promaaa/firefighter-robot/vision/README.md

# Vision: the fire detector

This folder holds the fire detector of the robot: a YOLO11n network (Ultralytics) with one class, fire.
It finds flames in the 640 x 480 image of the Arducam B0201 camera and gives a box for each fire.
`detector.py` is the plug-in that `robot/camera_node.py` loads. It needs only onnxruntime, numpy and pillow.

**Licence:** this folder (code and model files) is AGPL-3.0 ([LICENSE](LICENSE)), because it uses Ultralytics YOLO. The code in the rest of the repository is MIT ([../LICENSE](../LICENSE)).

**Not verified:** From the B0201 camera, the modes, the frame rates, the lens calibration and the screen bench (fire images on a screen, 5 and 6 Nov) are measured. No real flame is measured yet (test V4). No number comes from the ROCK 3C board. All test images are public photos and video frames. The RKNN models ran only in the Rockchip simulator.
**Measured on laptop (5 Nov):** at 640 x 480, the B0201 has f = 476 px at the image centre and a real field of view of 80° x 59° (`camera_b0201.json`). The old model value was f = 283 px.

## Status

| Part | Status |
|---|---|
| Dataset from public sources, with a data card (`data.py`, [DATA.md](DATA.md)) | built |
| YOLO11n detector, trained at 416 px (`train.py`) | built |
| Accuracy on held-out test images, CPU speed (`evaluate.py`, `export.py`, `detector.py`) | measured on laptop |
| RKNN INT8 model for the RK3566 NPU (`rknn_convert.py`) | measured on laptop, in the Rockchip simulator |
| Detector in the F2 mission simulation with real-fire flames ([sim/mission](../sim/mission/README.md)) | tested in simulation |
| Speed test for the robot board (`board_bench.py`) | built |
| B0201 on the laptop: 640 x 480 MJPEG at 14.8 fps (15 fps set), 1920 x 1080 MJPEG at 30 fps (`robot/bench.py camera`, [modes](results/b0201_modes.txt)) | measured on laptop |
| Camera calibration with a live view (`calibrate.py`) | measured on laptop: f = 476 px, RMS 0.51 px at 640 x 480 (100 views); f = 1084 px, RMS 1.53 px at 1920 x 1080 (50 views) |
| Screen bench: the B0201 films fire images on a screen (`screen_bench.py`) | built, tested in simulation (ideal camera, `--fake`) |
| Range test: the B0201 films real candles at measured distances (`range_test.py`) | built, tested in simulation (a video file in place of the camera) |
| Small-flame variant `small416`: training images scaled by 0.1 to 1.9 (`train.py`, [metrics.md](results/small416/metrics.md)) | measured on laptop: no gain, not used. Ideal-camera screen bench: a candle needs 23 px (old model: 16 px) |
| Model changes `cam416` (camera-like training images), `p2_416` (YOLOv8n-P2), `y26_416` (YOLO26n), `p2cam416` (P2 + camera-like images), `p2bench` (p2cam416 + B0201 screen bench frames) in `train.py` ([plan](../docs/plan/vision.md#model-changes-after-v2-and-v4)) | measured on laptop (test images and B0201 screen bench frames, 5 and 6 Nov; `p2bench` INT8 in the Rockchip simulator), planned (real candles V4, board) |
| Detector on the board with the B0201, indoor fire test | planned |

The test stages with the B0201 and the ROCK 3C, their commands and pass criteria: [docs/plan/vision.md](../docs/plan/vision.md).

## Terms

- Box: the rectangle around a fire, in pixels of the 640 x 480 image. Confidence: a score from 0 to 1 for each box.
- Precision: the share of boxes that are real fires. Recall: the share of real fires that get a box.
- IoU: the overlap of two boxes, from 0 to 1. mAP50: the area under the precision-recall curve, with a match at IoU 0.5 or more.
- New scenes: test images that do not show the same scene as a training image ([DATA.md](DATA.md)). They are closer to a new room.
- NPU: the neural processing unit of the RK3566 chip. RKNN: its model format. INT8: the network computes with 8-bit integers.

## Results

The detector keeps the boxes with a confidence of 0.28 or more. This threshold gives the best balance of precision and recall on the validation images.
The full test uses the 416 x 416 export of the deployed weights. On a 640 x 480 image, it resizes the image by the same factor as the deployed file (0.65).
Sources: [metrics.md](results/all416/metrics.md) ([JSON](results/all416/metrics.json)), [speed.md](results/speed.md), [deploy_check.md](results/deploy_check.md), [video_check.md](results/video_check.md).

| Test | Result |
|---|---|
| Real test images, all (13 919 images, 8 455 fire boxes) | precision 0.781, recall 0.745, mAP50 0.809 |
| Real test images, new scenes only (5 733 images, 2 284 fire boxes) | precision 0.673, recall 0.723, mAP50 0.747 |
| Small fires (box under 32 px wide), all real test images | recall 0.472, mAP50 0.529 |
| False alarms: 330 COCO photos of fire-like things, no fire | a false box in 2.1 % of the images |
| False alarms: 4 738 new-scene images without fire | a false box in 7.4 % of the images |
| Box width for 50 % recall (IoU 0.25), distance d = f × flame width / box width, f = 476 px | 16 px: a 10 cm flame up to 3.0 m, a 30 cm flame up to 8.9 m |
| Box width for 90 % recall (IoU 0.25) | 64 px: a 10 cm flame up to 0.7 m, a 30 cm flame up to 2.2 m |
| Laptop CPU (i7-9700, onnxruntime), `detect()` on a 640 x 480 frame | 12.0 ms with 4 threads (83 frames per second), 26.7 ms with 1 thread |
| RKNN INT8 in the Rockchip simulator, 918 test images | mAP50 0.775 (ONNX on the same images: 0.816). Small-fire recall 0.500 (ONNX: 0.554) |
| 6 real videos (Wikimedia Commons, [timeline](results/video_timeline.png)) | frames with a box: candle 95 %, burning bottle 100 %, far campfire 58 %. LED candles (no fire): weak false boxes, up to 0.36 |
| F2 mission simulation, real-fire flame sprites | recall by box width as on real photos. 0.001 false boxes per image |

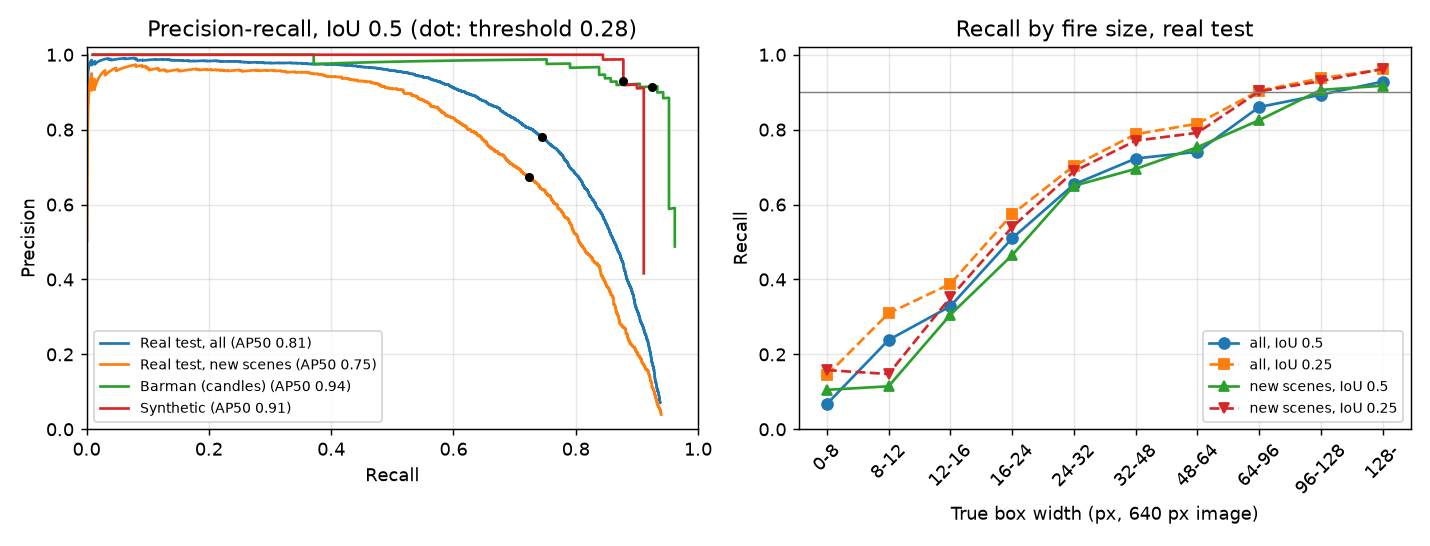
[picture p3: vision/results/all416/pr_and_size.png]
Precision-recall curves and recall by box width


Left: precision-recall curves at IoU 0.5. The dot is the threshold 0.28. Right: recall by true box width.

We trained YOLO11n from the COCO weights for 20 epochs at 416 px: AdamW, learning rate 0.001, batch 64, 62 719 images per epoch ([DATA.md](DATA.md), [training curves](results/training_curves.png)).
A control run without our 203 synthetic images (`real416`) gives the same mAP50 on real photos (0.811). On the synthetic test images, it falls from 0.911 to 0.164 ([variants.md](results/variants.md)).

## Models: which file runs where

| File | Runs on | How |
|---|---|---|
| `models/fire_yolo11n_416x320.onnx` (FP32, 10.5 MB) | laptop CPU or board CPU, with onnxruntime | the default of `detector.py` |
| `models/fire_yolo11n_416x320_int8.rknn` (INT8, 3.9 MB) | RK3566 NPU, with rknn-toolkit-lite2 | `FIRE_MODEL=vision/models/fire_yolo11n_416x320_int8.rknn` |

Both files take a 416 x 320 input: a 640 x 480 camera image becomes 416 x 312 with a 4 px grey border. `aim/` then uses only the boxes from its `min_conf` (0.3 for F2 and F3, `aim/geometry.py`).

## On the robot board (RK3566)

The robot runs the INT8 model on the NPU, so that the CPU stays free for the other robot programs. The target is 10 frames per second, the rate of `aim/`.

Measured on board, 11 Nov 2026 (ROCK 3C, Radxa OS Debian 12, kernel 6.1, NPU driver 0.9.8, librknnrt 2.5.0; [results/board_bench_rock-3c.md](results/board_bench_rock-3c.md)):

| Model and runtime | Detector (ms, median) | Camera + detector (fps) | 10 fps target |
|---|---|---|---|
| NPU INT8, `fire_yolo11n_416x320_int8.rknn` | 43.6 | 21.2 | PASS |
| NPU INT8, `fire_yolo11n_640x480_int8.rknn` | 70.5 | 13.5 | PASS |
| NPU INT8, `p2bench`, 416 x 320 | 66.5 | 14.2 | PASS |
| NPU INT8, `p2bench`, 640 x 480 | 114.8 | 8.3 | FAIL |
| CPU (onnxruntime, 4 threads), 416 x 320 | 246.5 | 3.8 | FAIL |

- The camera program (`robot/bench.py camera`, B0201 on the board, 1 ms exposure, a candle video on a screen) runs at 14.5 fps with `fire_yolo11n_416x320_int8.rknn` and finds the flame in 267 of 267 frames.
- **Known issue:** `p2bench` gives wrong boxes on the NPU (the whole candle, or boxes at the image edge), in INT8 and in fp16. The same model in ONNX on the laptop, and in the Rockchip simulator, gives the right box. So the robot uses `fire_yolo11n_416x320_int8.rknn` until this is fixed. `cam416` INT8 gives the right boxes on the NPU.

### NPU setup

`robot/setup/install.sh` (step 11) does both steps. By hand:

1. Enable the NPU. The Radxa image ships with it disabled. Then reboot.

```sh
sudo rsetup enable_overlays rk3568-npu-enable.dtbo
```

2. Install the NPU runtime 2.5.0. The image has 2.3.0, and our `.rknn` models need 2.5.0.

```sh
sudo curl -L -o /usr/lib/librknnrt.so https://raw.githubusercontent.com/airockchip/rknn-toolkit2/v2.5.0/rknpu2/runtime/Linux/librknn_api/aarch64/librknnrt.so
```

3. Check: `/sys/class/devfreq/fde40000.npu` exists, and `sudo cat /sys/kernel/debug/rknpu/version` prints the driver version.

### Speed test

The `.rknn` models other than `fire_yolo11n_416x320_int8.rknn` are not in git. Copy them from the laptop (docs/plan/vision.md, V6). Plug in the B0201 camera, then run from the repository root. Without a camera, add `--video FILE`:

```sh
uv run --with rknn-toolkit-lite2==2.5.0 python vision/board_bench.py
```

A model that cannot load shows "skipped" and the reason. The script writes `vision/results/board_bench_<host>.md`.

## Camera (Arducam B0201)

The B0201 has an M12 lens with a 120° diagonal field of view on a 16:9 sensor (datasheet). The robot reads it at 640 x 480 in MJPEG.
640 x 480 is the centre 1440 x 1080 of the 1920 x 1080 image, scaled by 1/2.25 (measured on laptop, 5 Nov: the edges of both images match). So a flame is 2.25 times wider in pixels at 1920 x 1080.
The lens calibration of 5 Nov (measured on laptop) gives f = 476 px, cx = 298 px, cy = 223 px and k1 = -0.39 at 640 x 480. The real field of view is 80° x 59°. The pinhole value of f gives 67.8°.
A board at a measured 400 mm comes out at 401 mm. `detector.py` and `aim/run.py` read `camera_b0201.json`. `robot/config.toml` `hfov_deg = 67.8` is only used when that file is missing.
Since 6 Nov, `aim/geometry.py` and the mission simulation use a pinhole camera with f = 476 px and the image centre. They have no lens distortion, so they see 67.8° instead of 80°.
`calibrate.py` measures the focal length, the image centre and the distortion with a printed checkerboard. Run it on the laptop, with the camera on USB.

1. Print `results/calib_board_9x6_25mm_A4.pdf` on A4 at 100 % scale: 10 x 7 squares (9 x 6 inner corners). Glue it flat on a rigid board. `calibrate.py --board-pdf FILE` writes it again.
2. Measure the 100 mm line under the board. When it is not 100 mm, measure one square and add `--square` with its size in metres.
3. Start the live capture. With a folder of 20 to 30 photos of the board, use `--images FOLDER` instead of `--camera`:

```sh
uv run --project vision python vision/calibrate.py --camera /dev/video0
```

4. Move the board slowly: near, far, tilted up to 45°, and in all four corners of the image. The script saves one view each second, 25 views in total.
5. Read the RMS error at the end. Below 0.5 px is good. Above 0.5 px, repeat with more views near the corners.
6. Commit the output file `vision/camera_b0201.json`. When it exists, `detector.py` corrects each box for the lens distortion, and `aim/run.py` uses its fx, fy, cx and cy.
7. Put the new `hfov_deg` into `robot/config.toml` for the other programs.

## How to run

Run all commands from the repository root, one at a time, in this order.
`--project vision` selects the vision environment (Python 3.12, torch, Ultralytics, OpenCV). The first run installs it (about 6 GB).
Big files stay outside git: the dataset in `~/datasets/firefighter/` and the training runs in `~/runs/firefighter/vision/`.

| Step | Command | Output |
|---|---|---|
| 1. Build the dataset: 26 GB download, about 40 GB on disk, about 30 min | `uv run --project vision python vision/data.py` | `~/datasets/firefighter/yolo/`, `vision/results/data_stats.md` |
| 2. Train: NVIDIA GPU with 6 GB of memory, about 2 h on an RTX 3090 | `uv run --project vision python vision/train.py all416` | `~/runs/firefighter/vision/all416/` |
| 3. Export to ONNX, measure the CPU speed, copy the 416 x 320 model to `vision/models/` | `uv run --project vision python vision/export.py all416 --speed --install` | `vision/results/speed.md` |
| 4. Evaluate on the test images: 20 to 40 min on the CPU | `uv run --project vision python vision/evaluate.py ~/runs/firefighter/vision/all416/onnx/fire_yolo11n_416.onnx --name all416` | `vision/results/all416/` |
| 5. Convert to RKNN and run the Rockchip simulator. uv makes a separate environment for rknn-toolkit2 | `uv run --script vision/rknn_convert.py vision/models/fire_yolo11n_416x320.onnx` | `~/runs/firefighter/vision/rknn/` |
| 6. Copy the INT8 model to `vision/models/` | `cp ~/runs/firefighter/vision/rknn/fire_yolo11n_416x320_int8.rknn vision/models/` | `vision/models/` |
| 7. Compare ONNX and the RKNN simulator on the same 918 test images | `uv run --project vision python vision/evaluate.py --conf 0.28 --deploy vision/models/fire_yolo11n_416x320.onnx --rknn ~/runs/firefighter/vision/rknn/preds_fire_yolo11n_416x320_int8.npz` | `vision/results/deploy_check.md` |
| 8. Run the tests: letterbox, box decoding, detector output, lens distortion, calibration | `uv run --project vision pytest vision/test_vision.py -q` | test result |
| 9. Real fire videos. First download the clips ([video_sources.md](results/video_sources.md)) | `uv run --project vision python vision/video_demo.py` | `vision/results/video_check.md`, `video_timeline.png` |
| Camera node with this detector on a video file (root environment) | `uv run python robot/camera_node.py --source video:FILE --detector vision/detector.py` | UDP port 5600 |

## Limits and open points

- `uv sync --extra board` installs rknn-toolkit-lite2 on the board (aarch64 only), so the camera node can load the RKNN model. `robot/setup/install.sh` runs it.
- **Open:** We still need the calibration of the B0201 and an indoor test with a real tray fire.
- Small fires are the weak point: under 16 px wide, the recall is under 40 %. A 640 x 480 input finds more of them (recall 0.679 against 0.554 on the 918 test images). It takes about twice the time.
- Lights can give false boxes: traffic lights, lamps and LED candles, with a confidence of 0.3 to 0.6. A screen that shows a fire also looks like a fire.
- The detector has no memory between frames. `aim/` confirms a fire over several frames.

## Licence notes

- Code and model files: GNU AGPL-3.0 ([LICENSE](LICENSE)). Datasets: [DATA.md](DATA.md) lists each source and its licence. The datasets are not in the repository.
- **Assumed:** Research and education use is allowed for all data sources. Two sources are non-commercial, so the model is not for commercial use.
- The video clips come from Wikimedia Commons ([video_sources.md](results/video_sources.md)). They are not in the repository.

## References

1. Rockchip, rknn_model_zoo, "Model performance benchmark (FPS)", README at commit 837db8e (2026-10-13). <https://github.com/airockchip/rknn_model_zoo>
2. Ultralytics YOLO11, AGPL-3.0. <https://github.com/ultralytics/ultralytics>
