promaaa/firefighter-robot/docs/hardware/power_calc.md

# Power numbers (generated by docs/hardware/power_calc.py)

Status: tested in simulation. 40 walking runs of 20 s on F2 (bhl_F2), case 7, 1 falls.

## Motor bus (24 V, two 6S packs through the diode)

- Battery power, walking, mean of the runs: 34 W (highest run 41 W). Standing: 21 W. Both include 18 W drive standby (ASSUMED).
- Peak bus power: 191 W instant, 148 W over 20 ms. Peak into one drive: 107 W.
- Peak regen of the 12 drives together: 54 W. Peak regen of one drive: 79 W (3.3 A at 24 V). Mean regen power: at most 1.4 W in one run.
- Pump (KLP02, through the DMC-101, after relay K1): 12 W or less while it sprays (0.5 A at 24 V, datasheet). At 10 % spray time (ASSUMED): 1.2 W on average.
- Battery time, two 6S at 80 % usable, simulated walking power plus the mean pump power: 5.0 h.

| Brake option | Peak bus voltage (V) | Peak resistor power (W) | Largest energy per event (J) | Mean resistor power, worst run (W) | Events per second | Brake current limit per drive (A) |
|---|---|---|---|---|---|---|
| none | 36.48 | 0 | 0.00 | 0.00 | 0.0 | - |
| 1 x 2.2 ohm | 25.56 | 47 | 2.04 | 1.15 | 4.1 | 11.2 |
| 2 x 2.2 ohm | 25.53 | 47 | 2.04 | 1.15 | 4.1 | 11.2 |
| 1 x 4.7 ohm | 25.63 | 45 | 2.04 | 1.14 | 4.1 | 5.2 |
| 2 x 4.7 ohm | 25.57 | 47 | 2.04 | 1.15 | 4.1 | 5.2 |
| 12 x own resistor, no ramp | 25.20 | 79 | - | 11.35 | 0.0 | - |

Ramp 25.5 V to 25.9 V, bus capacitance 6 mF, start at 25.2 V. The brake current counts in dc_max_positive_current (12 A).

## 3S rail (computer, relay coils, pan-tilt)

| Rail | Load | Typical (A) | Peak (A) | Source |
|---|---|---|---|---|
| 5V | ROCK 3C at full CPU load | 1.20 | 2.00 | estimate 5-6 W (parts.md). Radxa asks for a 5 V 3 A supply |
| 5V | 2 x CANable V2.0 Pro (isolated) | 0.20 | 0.25 | ASSUMED 100 mA each (isolated DC-DC + STM32G431) |
| 5V | Camera B0201 | 0.20 | 0.30 | listing: 300 mA max |
| 5V | IMU IM10A on UART | 0.01 | 0.02 | listing: 12 mA |
| 5V | Bus servo adapter, USB side | 0.02 | 0.05 | ASSUMED |
| 12V | Pan-tilt: 2 x ST3215 | 0.30 | 5.40 | Waveshare: stall 2.7 A each at 12 V. Typical ASSUMED |
| 12V | Push-lock switch lamps, meters | 0.05 | 0.05 | ASSUMED 15-20 mA each |

- 5 V rail: 1.63 A typical, 2.62 A peak.
- 3S input: 20.3 W typical (1.83 A at 11.1 V), 82.4 W peak (7.8 A at 10.5 V).
- 3S battery time at the typical load: 2.6 h.

## Harness check

All rows pass.
