promaaa/firefighter-robot/cad/final/kit/hardware.md

# Hardware list, final design F2 (generated by kit.py)

Counts are for one robot. Buy 10 % spare of the small screws.

| Item | Count | Where |
|---|---|---|
| M5 drop-in T-nut, 2020 6 mm slot | 32 | deck 4, holder 4, pod spacers 4, resistor mounts 4, tanks 8, frame clips 8 |
| M5 x 55 socket head screw + washer | 8 | tanks to the side slots of the posts (4 per tank) |
| M5 x 12 socket head screw | 8 | deck 4, holder 4 |
| M5 x 12 button head screw | 8 | pod spacers 4, resistor mounts 4 |
| M5 x 8 button head screw | 8 | frame clips |
| M5 x 12 button head screw + M5 nut + washer | 2 | relay K1 to the shelf, heads below (check the relay foot thickness) |
| M5 x 10 screw + M5 nut + washer | 2 | shunt to the pod plate (ASSUMED size, check the shunt) |
| M6 x 12 screw + M6 nut + 2 washers | 2 | diode to the pod plate, with thermal paste |
| M4 x 12 button head screw + M4 nut | 4 | head to the tilt U (nuts in the U pockets) |
| M4 x 16 screw + M4 nut | 4 | pan base to the deck (nuts in the deck pockets) |
| M3 heat-set insert, 4.0 mm hole, 5 mm long | 8 | resistor mounts |
| M3 x 8 screw + washer | 8 | brake resistors to their mounts (ASSUMED 39.7 x 21.4 mm pattern) |
| M3 x 20 screw + M3 nut | 4 | IMU mount and shelf to the front bracket bar 2, pump holder and shelf to the rear bar 2 |
| M3 x 10 screw + M3 nut + nylon spacer 5 mm | 4 | boost converter on the shelf |
| M3 x 12 button head screw + M3 nut | 4 | 3S basket to the pod plate (nuts in the band pockets) |
| M3 x 10 screw + M3 nut | 2 | pod cover to the basket ledge, from below |
| M3 x 10 set screw (or thread-forming M3 x 10) | 1 | nozzle adapter in the head |
| M2.5 x 10 male-female brass standoff + M2.5 nut | 4 | ROCK 3C on the pod plate |
| M2.5 x 5 screw | 4 | ROCK 3C to the standoffs |
| M2 x 8 screw + M2 nut | 4 | camera board in the head (34 or 28 mm pattern) |
| Brass hose barb M5 x 3 mm | 2 | tank outlets, with PTFE tape |
| Hose tee for 3 mm tube | 1 | joins the 2 tank lines in front of the torso |
| Silicone stopper for a 16 mm bore, with a vent hole | 2 | tank fill necks |
| Hook-and-loop strap 20 mm x 400 mm | 2 | 6S packs in the holder |
| Hook-and-loop strap 20 mm x 250 mm | 3 | 3S pack in the basket 2, DWP-385 pump holder 1 (see the pump note) |
| Rubber grommet for a 20 mm hole | 1 | pod plate cable pass |
| Zip tie 2.5 mm | 24 | IMU 1, hose clips 8, relay K2 1, filter 2, tank tubes 4, spare 8 |
| Double-sided foam tape 1 mm | 0.4 m | CANable x 2 and buck on the basket lip, relay K2, IMU back |
| Silicone tube 3 x 6 mm | 1.5 m | tanks to tee to filter to pump 0.6 m, pump to nozzle 0.7 m, spare |
| Thermal paste | 1 g | diode |
| Aluminium sheet 2 mm, 150 x 198 mm | 1 | pod plate (drawing pod_plate_al2) |
| Clear acrylic 5 mm, 140 x 109 mm | 1 | middle shelf (drawing shelf_acrylic_5mm), from the B4 sheet |
| 6808-2RS ball bearing, 40 x 52 x 7 mm | 1 | pan axis, in the pan base |
| M3 screw, length to fit (ASSUMED thread) | 12 | pan yoke to the pan servo horn 4, tilt U arms to the 2 tilt servo horns 8 |
| M2 screw, length to fit (ASSUMED thread) | 8 | pan servo in the pan base 4, tilt servo to the yoke tabs 4 |

The pan-tilt also needs the 2 ST3215 servos. The Waveshare drawing gives no thread size for the horn and case screws. See the pan-tilt steps in `README.md`.

**Pump:** The pump holder and its 250 mm strap fit the DWP-385 pump. The team uses the Kamoer KLP02 24 V pump with a DMC-101 controller. We will redraw the holder when the KLP02 arrives and is measured.
