promaaa/firefighter-robot/cad/final/kit/drawings/pod_plate_al2.pdf

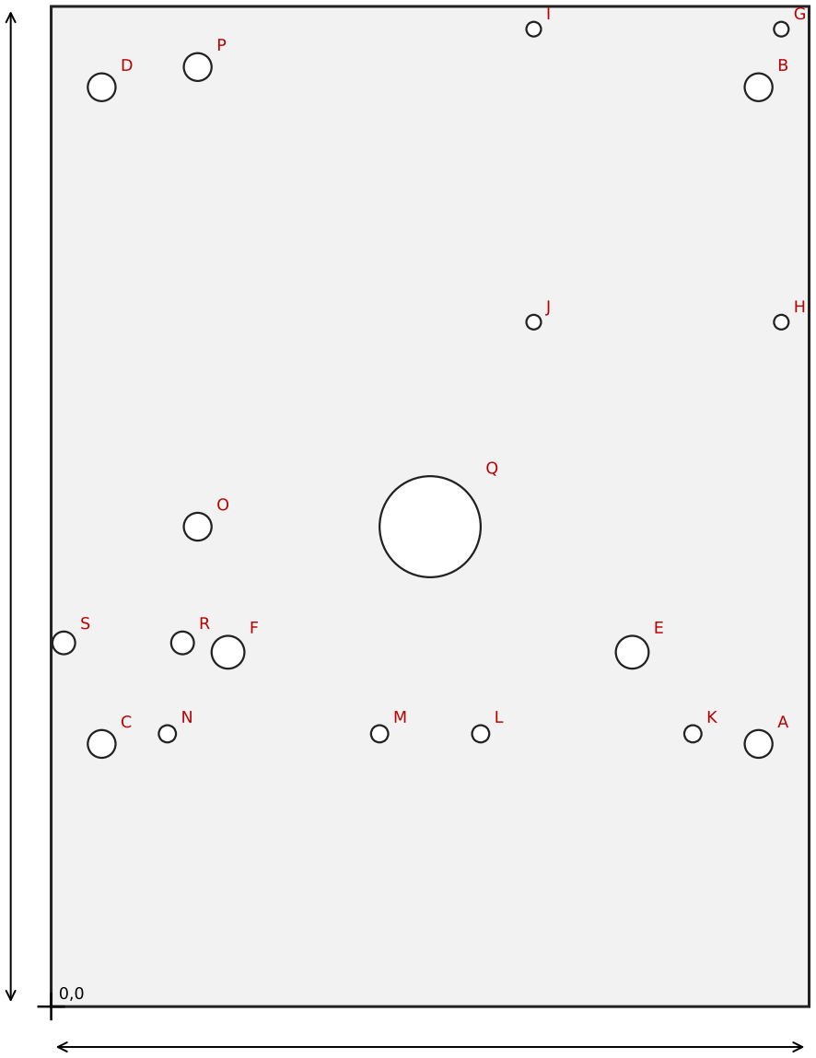
[picture p21: figure]

150.0

198.0

# Pod plate: 2 mm aluminium (5052 or 6061), 1 piece (seen from behind the robot)

| u | v | dia | use
A | 140.0 | 52.0 | 5.5 | M5 spacer
B | 140.0 | 182.0 | 5.5 | M5 spacer
C | 10.0 | 52.0 | 5.5 | M5 spacer
D | 10.0 | 182.0 | 5.5 | M5 spacer
E | 115.0 | 70.1 | 6.5 | M6 diode
F | 35.0 | 70.1 | 6.5 | M6 diode
G | 144.5 | 193.5 | 2.9 | M2.5 ROCK 3C
H | 144.5 | 135.5 | 2.9 | M2.5 ROCK 3C
I | 95.5 | 193.5 | 2.9 | M2.5 ROCK 3C
J | 95.5 | 135.5 | 2.9 | M2.5 ROCK 3C
K | 127.0 | 54.0 | 3.4 | M3 basket
L | 85.0 | 54.0 | 3.4 | M3 basket
M | 65.0 | 54.0 | 3.4 | M3 basket
N | 23.0 | 54.0 | 3.4 | M3 basket
O | 29.0 | 95.0 | 5.5 | M5 shunt*
P | 29.0 | 186.0 | 5.5 | M5 shunt*
Q | 75.0 | 95.0 | 20.0 | grommet
R | 26.0 | 72.0 | 4.5 | zip tie K2
S | 2.5 | 72.0 | 4.5 | zip tie K2

Seen from behind: robot left (+y) is on the left. Origin: bottom left corner seen from behind.
u = across, v = up from the bottom edge, mm. Deburr all edges. No bends.
* Shunt holes: ASSUMED near the ends of a 105 mm base. Drill them from the part. Grommet: 20 mm hole for a rubber grommet. M6 diode: thermal paste under the diode.
