promaaa/firefighter-robot/cad/final/kit/drawings/shelf_acrylic_5mm.pdf

## Middle shelf: 5 mm clear acrylic, 1 piece (top view, front = +x to the right)

| x | y | dia | use
A | 14.0 | 44.7 | 3.4 | M3 to bracket bar
B | 14.0 | 64.3 | 3.4 | M3 to bracket bar
C | 126.0 | 44.7 | 3.4 | M3 to bracket bar
D | 126.0 | 64.3 | 3.4 | M3 to bracket bar
E | 111.0 | 22.8 | 5.5 | M5 relay
F | 85.0 | 86.2 | 5.5 | M5 relay
G | 45.0 | 3.5 | 3.4 | M3 boost*
H | 45.0 | 62.5 | 3.4 | M3 boost*
I | 74.0 | 3.5 | 3.4 | M3 boost*
J | 74.0 | 62.5 | 3.4 | M3 boost*
slot 50.0..80.0 x 98.5..106.5
slot 82.0..106.0 x 2.5..10.5

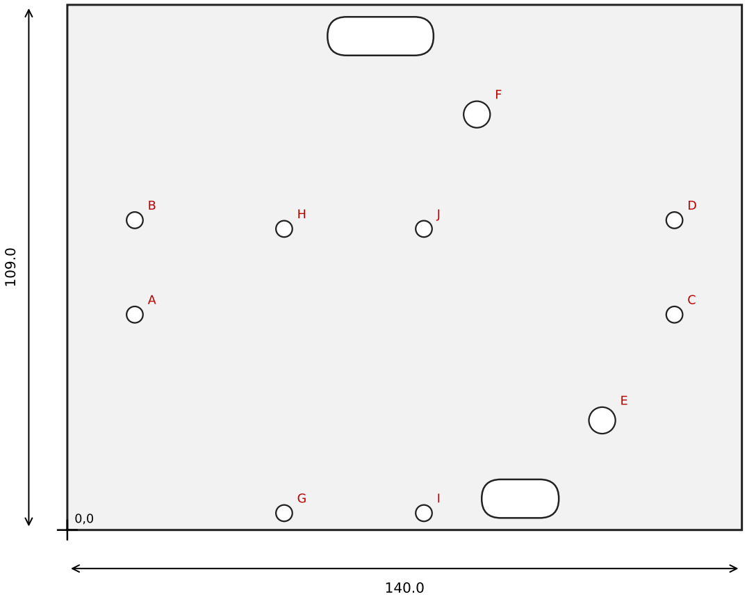
[picture p22: figure]

Origin: rear right corner (x -70, y -54.5).
u = robot x (forward), v = robot y (left), mm. Cut the outline and the 2 slots on a laser. Drill the holes or cut them on the laser.
* Boost holes: ASSUMED 59 x 29 mm pattern. Measure the board, then drill these 4 last. Relay: holes on one diagonal. Check which diagonal your relay has before you drill. M3 bracket holes: the holes of the BHL PC shelf brackets (mesh). Check on the robot. The shelf rests on the bracket bars (z 641). Rear M3 holes: the pump holder base sits
on them (M3 x 20).
