promaaa/firefighter-robot/cad/final/kit/drawings/pod_plate_al2.png

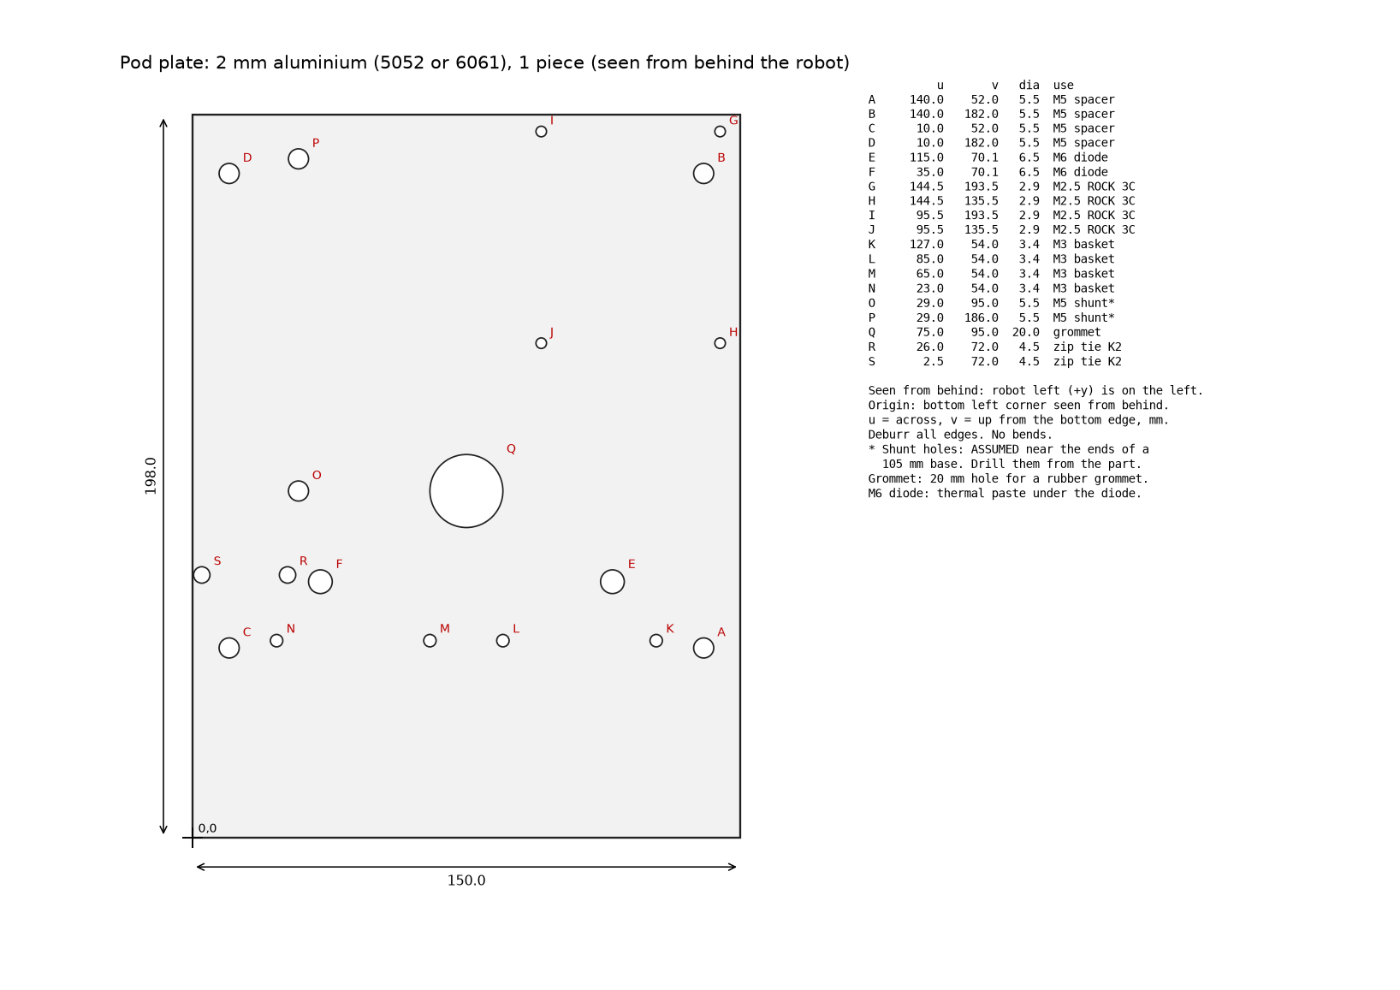
cad/final/kit/drawings/pod_plate_al2.png
