promaaa/firefighter-robot/cad/final/kit/drawings/shelf_acrylic_5mm.png

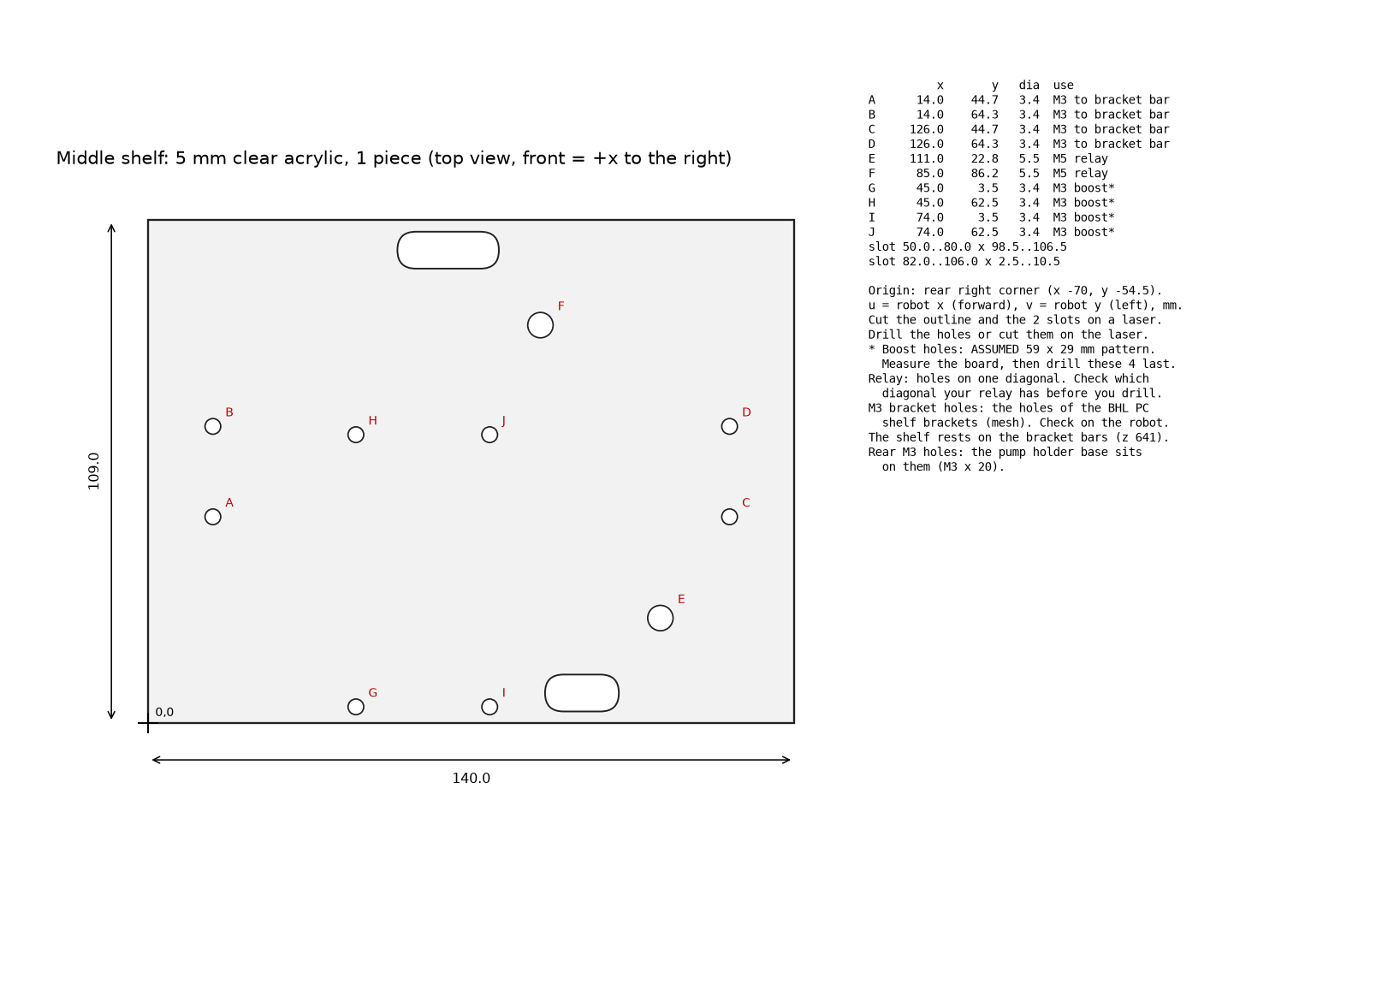
cad/final/kit/drawings/shelf_acrylic_5mm.png
