promaaa/firefighter-robot/cad/final/renders/f2_rear.jpg

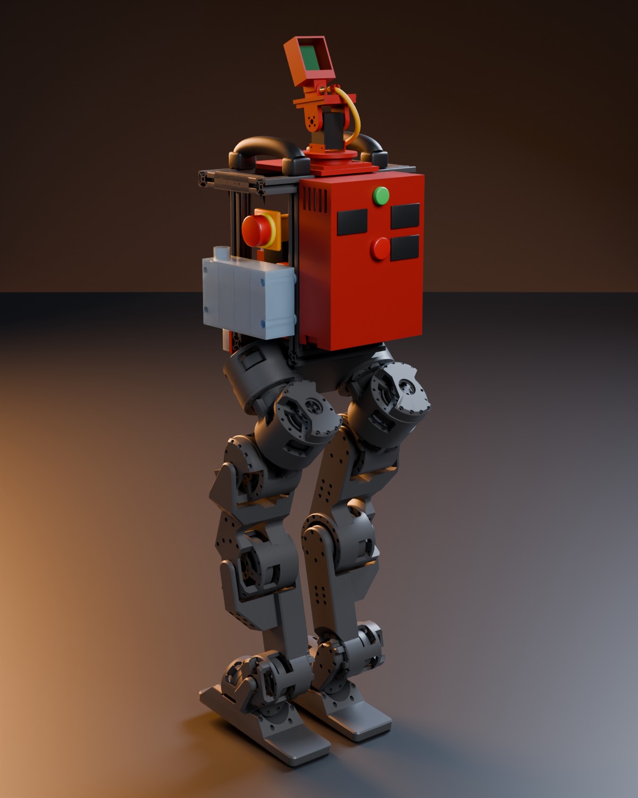
cad/final/renders/f2_rear.jpg
