promaaa/firefighter-robot/sim/mission/sprites/basket.webp

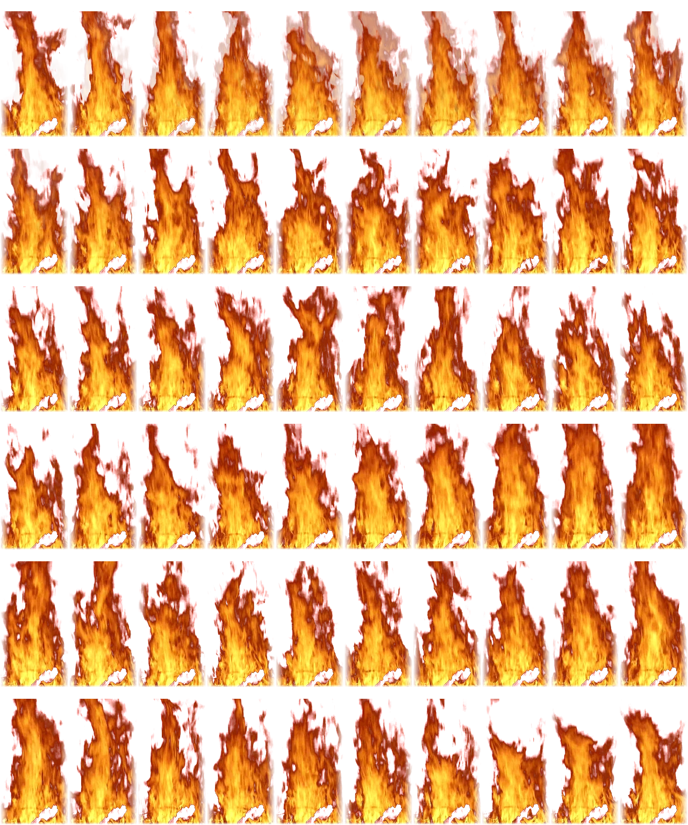
sim/mission/sprites/basket.webp
