promaaa/firefighter-robot/sim/mission/sprites/campfire_a.webp

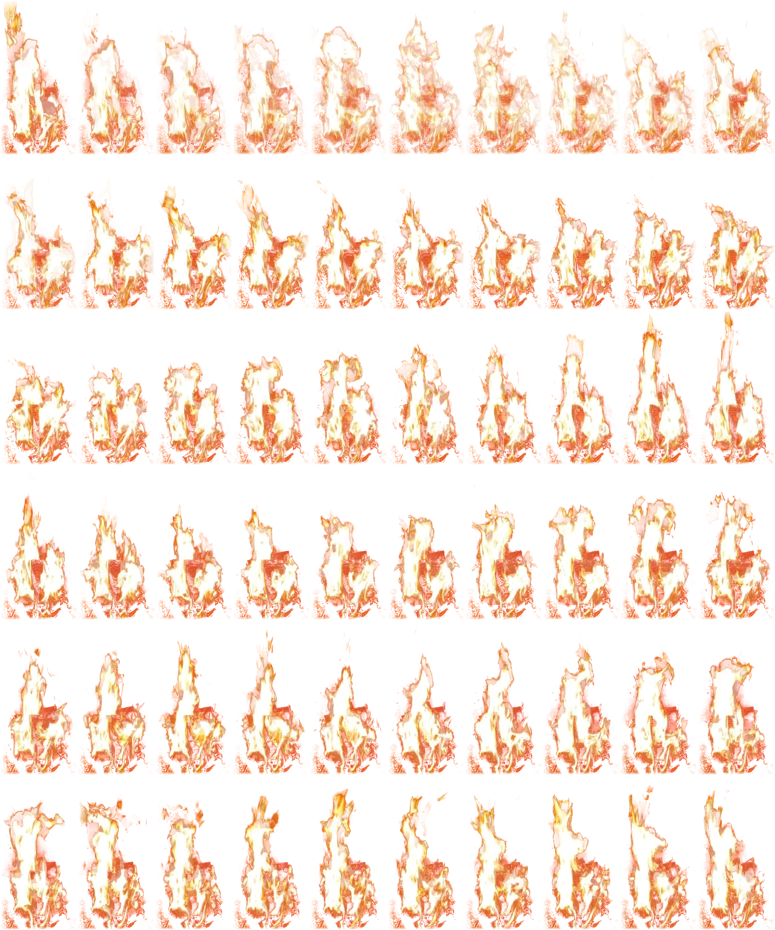
sim/mission/sprites/campfire_a.webp
