promaaa/firefighter-robot/sim/mission/sprites/campfire_b.webp

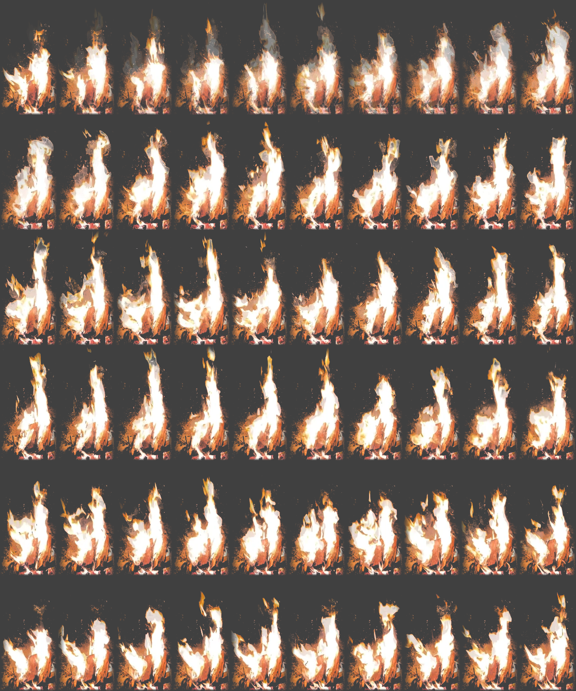
sim/mission/sprites/campfire_b.webp
