promaaa/firefighter-robot/sim/mission/sprites/free_flame.webp

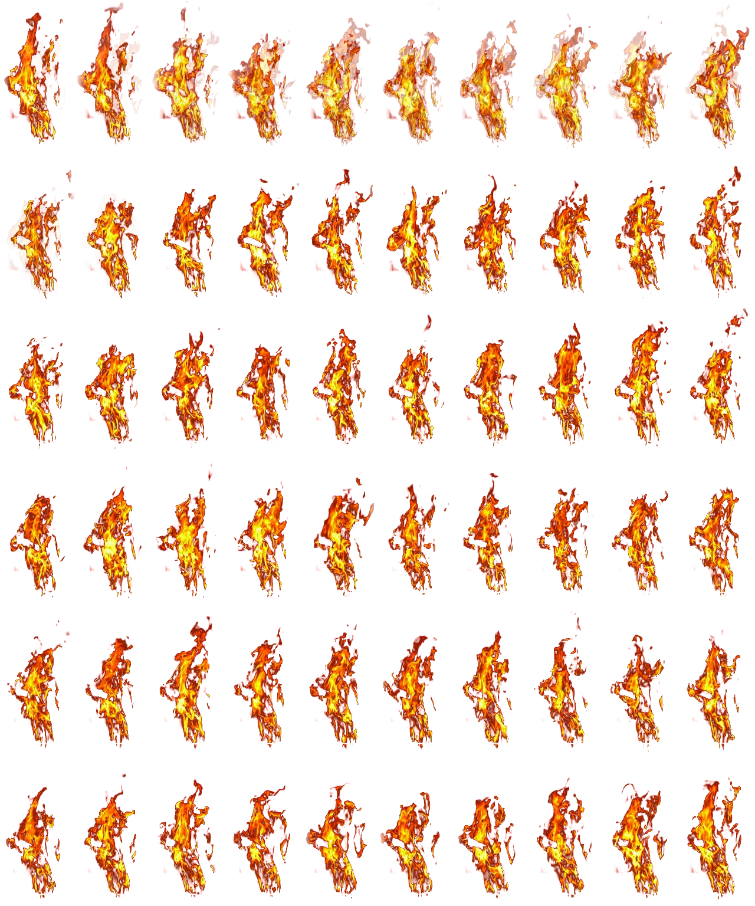
sim/mission/sprites/free_flame.webp
