promaaa/firefighter-robot/sim/mission/sprites/wood_fire.webp

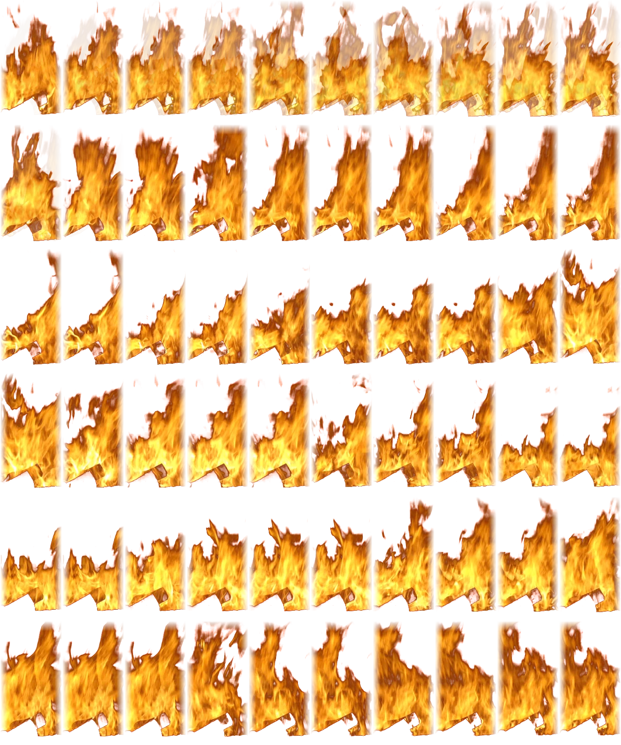
sim/mission/sprites/wood_fire.webp
