promaaa/firefighter-robot/docs/hardware/harness.csv

id | circuit | from | from_connector | to | to_connector | awg | colour | pair | length_mm | fuse | fuse_a | i_cont_a | i_peak_a | v_nom | notes
W01 | 6S pack A + | 6S pack A | EC5 (robot side) | F1 holder then diode D1 anode A1 | ring 6.4 mm (1/4-20 screw) | 12 | red | no | 250 | F1 | 20 | 1.5 | 8 | 25.2 | F1 = MTA 0100335 in-line holder (30 A. 4 mm2 leads) with a 20 A mini fuse within 50 mm of the EC5
W02 | 6S pack B + | 6S pack B | EC5 (robot side) | F2 holder then diode D1 anode A2 | ring 6.4 mm (1/4-20 screw) | 12 | red | no | 250 | F2 | 20 | 1.5 | 8 | 25.2 | F2 = MTA 0100335 within 50 mm of the EC5
W03 | 6S pack A - | 6S pack A | EC5 (robot side) | shunt BATT bolt | ring for the shunt bolt | 12 | black | no | 300 | F1 | 20 | 1.5 | 8 | 25.2 | F1 opens this loop
W04 | 6S pack B - | 6S pack B | EC5 (robot side) | shunt BATT bolt | ring for the shunt bolt | 12 | black | no | 300 | F2 | 20 | 1.5 | 8 | 25.2 | F2 opens this loop
W05 | motor bus + | diode D1 cathode K | ring 6.4 mm (1/4-20 screw) | relay K1 terminal 1 (+) | ring M5 | 10 | red | no | 150 | F1+F2 | 40 | 3 | 16 | 25.2 | both packs can feed this wire: 10 AWG carries 2 x 20 A
W06 | left leg + | relay K1 terminal 2 | ring M5 + F3 holder | left leg drive chain + | XT60 female (torso side) | 12 | red | no | 350 | F3 | 20 | 1.5 | 8 | 25.2 | F3 = MTA 0100335 at the relay. the leg keeps the course XT30 chain
W07 | right leg + | relay K1 terminal 2 | ring M5 + F4 holder | right leg drive chain + | XT60 female (torso side) | 12 | red | no | 350 | F4 | 20 | 1.5 | 8 | 25.2 | F4 = MTA 0100335 at the relay
W08 | left leg - | shunt LOAD bolt | ring for the shunt bolt | left leg drive chain - | XT60 female (torso side) | 12 | black | no | 350 | F3 | 20 | 1.5 | 8 | 25.2
W09 | right leg - | shunt LOAD bolt | ring for the shunt bolt | right leg drive chain - | XT60 female (torso side) | 12 | black | no | 350 | F4 | 20 | 1.5 | 8 | 25.2
W10 | brake resistor left | left hip roll drive AUX | AUX screw terminal (ferrule) | brake resistor RB1 (4.7 ohm 50 W, RH50C4R70J) | solder lug | 18 | red/black | yes | 250 | none (R limits it) | 0 | 0.1 | 5.2 | 25.9 | pulses up to 0.95 x 25.9 V / 4.7 ohm = 5.2 A. RB1 on the pelvis frame
W11 | brake resistor right | right hip roll drive AUX | AUX screw terminal (ferrule) | brake resistor RB2 (4.7 ohm 50 W, RH50C4R70J) | solder lug | 18 | red/black | yes | 250 | none (R limits it) | 0 | 0.1 | 5.2 | 25.9 | same settings on the right hip roll drive
W12 | motor bus meter | diode D1 cathode K and shunt sense screws | ring 6.4 mm + F5 holder | HAV6001 meter | meter leads | 22 | red/black | yes | 300 | F5 | 2 | 0.05 | 0.1 | 25.2 | F5 = mini 2 A in a Coms BE151 holder at K. twist the two sense wires
W20 | 3S main | 3S pack | EC5 (robot side) | F10 holder then HAV1625a ammeter then 3S distribution | Wago 221-413 | 16 | red/black | yes | 250 | F10 | 10 | 2.0 | 8.5 | 11.1 | F10 = 10 A mini fuse in a Coms BE151 holder within 50 mm of the EC5. ammeter in series in the + wire
W21 | 12 V switch feed | 3S distribution + | Wago 221-413 + F11 holder | S12 12 V push-lock switch NO (13) | ferrule | 22 | blue | no | 250 | F11 | 5 | 1.4 | 2.0 | 11.1 | S12 carries only the computer and the boost
W22 | buck input | S12 NO (14) and 3S distribution - | ferrule / Wago | 5 V buck VIN / GND | solder (Pololu pins) | 22 | blue/black | yes | 150 | F11 | 5 | 0.9 | 1.4 | 11.1
W23 | 5 V to ROCK 3C | 5 V buck VOUT / GND | solder (Pololu pins) | ROCK 3C header pins 2 + 4 (5 V) and 6 + 14 (GND) | 4 single Dupont female housings (22 AWG crimp) | 22 | red x2 / black x2 | yes | 150 | buck limit | 0 | 0.8 | 1.3 | 5.0 | two pairs in parallel. per wire 1.3 A peak. Do not plug a USB-C supply into the board at the same time
W24 | boost input | S12 NO (14) and 3S distribution - | ferrule / Wago | HAM5925 IN+ / IN- | screw terminal | 22 | blue/black | yes | 200 | F11 | 5 | 0.46 | 0.6 | 11.1
W25 | 24 V control | HAM5925 OUT+ | screw terminal + F12 holder | e-stop NC1 (11), with jumper W38 to NC2 (21) | ferrule | 22 | yellow | no | 200 | F12 | 2 | 0.18 | 0.2 | 24 | set the boost to 24.0 V and its current limit to 0.5 A before you connect the coils
W26 | 24 V control | e-stop NC1 (12) | ferrule | S24 24 V push-lock switch NO (13) | ferrule | 22 | yellow | no | 300 | F12 | 2 | 0.18 | 0.2 | 24
W27 | relay coil + | S24 NO (14) | ferrule | relay K1 coil plug Yazaki 7283-1020 (+) | crimp splice + heat shrink | 22 | yellow | no | 300 | F12 | 2 | 0.18 | 0.2 | 24 | varistor 10D390K across the coil leads. S24 lamp across the coil
W28 | relay coil - | relay K1 coil plug (-) | crimp splice + heat shrink | HAM5925 OUT- | screw terminal | 22 | black | no | 350 | F12 | 2 | 0.18 | 0.2 | 24
W29 | pan-tilt power | 12 V actuator node + / 3S distribution - | Wago 221-413 + F13 holder | bus servo adapter DC jack | DC plug 5.5 x 2.1 mm | 18 | red/black | yes | 400 | F13 | 10 | 0.3 | 5.4 | 11.1 | both servos at stall draw 5.4 A. F13 = 10 A mini fuse
W30 | actuator 12 V feed | 3S distribution + | Wago 221-413 | relay K2 terminal 30 | 6.3 mm female spade | 18 | red | no | 200 | F10 | 10 | 0.5 | 6.5 | 11.1 | K2 opens when the e-stop is pressed: the pan-tilt servos lose power
W31 | actuator 12 V node | relay K2 terminal 87 | 6.3 mm female spade | 12 V actuator node (Wago 221-413) | Wago 221-413 | 18 | red | no | 100 | F10 | 10 | 0.5 | 6.5 | 11.1
W32 | pump power | relay K1 terminal 2 (+24V_BUS) / RS1 LOAD bolt (GND_M) | ring M5 + F14 holder / ring for the shunt bolt | pump controller U7 (DMC-101) V+ / V- | screw terminal (check the DMC-101 datasheet) | 18 | red/black | yes | 300 | F14 | 3 | 0.5 | 1.5 | 25.2 | F14 = 3 A mini fuse in a Coms BE151 holder at K1 terminal 2. K1 (e-stop) cuts the pump. Peak current is an estimate: measure the start current
W37 | pump | pump controller U7 (DMC-101) M+ / M- | screw terminal | pump M1 (Kamoer KLP02, 24 V) | pump lead (check when the pump arrives) | 22 | red/black | yes | 200 | F14 | 3 | 0.5 | 1.5 | 25.2 | ≤ 12 W at 24 V. Add an SB560 flyback diode across the pump leads only if the pump is brushed and U7 has none
W33 | pump control | ROCK 3C pin 11 (GPIO3_A1) through R7 470 ohm / pin 9 (GND) | Dupont 1-pin x 2 | opto-isolator U8 input A / K | module pins | 26 | green/black | yes | 300 | none | 0 | 0.005 | 0.007 | 3.3 | proposed. R8 10 kohm from pin 11 to GND keeps the pump off while the board boots. High = pump on (check on the board)
W34 | e-stop sense | ROCK 3C pin 13 (GPIO3_A2) / pin 25 (GND) | Dupont 1-pin x 2 | e-stop NC3 (31 / 32) | ferrule | 26 | white/black | yes | 400 | none | 0 | 0.001 | 0.001 | 3.3 | R1 10 kohm pull-up from pin 1 (3.3 V) to pin 13: open contact or broken wire = high = stop
W35 | IMU UART | ROCK 3C pins 17 (3.3 V) / 20 (GND) / 18 (UART4_TX_M1) / 16 (UART4_RX_M1) | Dupont 1-pin x 4 | IM10A pin header VCC / GND / RX / TX | Dupont 1x4 | 26 | red/black/blue/green | no | 250 | none | 0 | 0.012 | 0.02 | 3.3 | UART4 on /dev/ttyS4. ROCK pin 18 (TX) to IMU RX. IMU TX to ROCK pin 16 (RX). The 3.3 V supply keeps the IMU TX at 3.3 V
W36 | 3S voltmeter | S12 NO (14) and 3S distribution - | ferrule / Wago | HAV1808 voltmeter | meter leads | 22 | blue/black | yes | 250 | F11 | 5 | 0.02 | 0.02 | 11.1 | shows the 3S voltage when the computer is on
W38 | 24 V control | e-stop NC1 (11) | twin ferrule | e-stop NC2 (21) | ferrule | 22 | yellow | no | 50 | F12 | 2 | 0.1 | 0.1 | 24 | jumper: NC2 feeds the K2 coil
W39 | relay K2 coil | e-stop NC2 (22) / HAM5925 OUT- | ferrule / screw terminal | relay K2 coil terminals 86 (+) / 85 (-) | 6.3 mm female spade | 22 | yellow/black | yes | 350 | F12 | 2 | 0.1 | 0.1 | 24 | SB560 across the K2 coil (cathode to 86). K2 coil current about 0.1 A (Assumed)
W40 | CAN left | CANable 1 screw terminal CAN_H / CAN_L / GND | screw terminal | left leg first drive CAN | JST-GH 2-pin CAN H / CAN L (course cable). GND wire to the shunt LOAD bolt | 24 | yellow/green/black twisted | no | 400 | none | 0 | 0.05 | 0.1 | 0 | termination jumper ON at the CANable and 120R jumper ON at the last drive. the CAN GND joins GND_M only here
W41 | CAN right | CANable 2 screw terminal CAN_H / CAN_L / GND | screw terminal | right leg first drive CAN | JST-GH 2-pin CAN H / CAN L (course cable). GND wire to the shunt LOAD bolt | 24 | yellow/green/black twisted | no | 400 | none | 0 | 0.05 | 0.1 | 0 | termination jumper ON at the CANable and 120R jumper ON at the last drive. the CAN GND joins GND_M only here
W42 | pump control, isolated side | opto-isolator U8 output C / E | module pins | pump controller U7 (DMC-101) control input / common | screw terminal (check the DMC-101 datasheet) | 26 | green/black | yes | 150 | none | 0 | 0.005 | 0.01 | 24 | proposed. The input type of the DMC-101 is not known yet
W50 | USB | ROCK 3C USB 2.0 host 1 | USB-A | CANable 1 | USB-C | USB | black | no | 300 | none | 0 | 0.1 | 0.1 | 5 | short USB-A to USB-C cable
W51 | USB | ROCK 3C USB 2.0 host 2 | USB-A | CANable 2 | USB-C | USB | black | no | 300 | none | 0 | 0.1 | 0.1 | 5 | short USB-A to USB-C cable
W52 | USB | ROCK 3C USB 3.0 host | USB-A | camera B0201 | camera cable | USB | black | no | 1000 | none | 0 | 0.2 | 0.3 | 5 | 1 m cable comes with the camera. route it through the pan loop
W53 | USB | ROCK 3C USB 2.0 OTG (board switch at HOST) | USB-A | bus servo adapter | USB-C | USB | black | no | 300 | none | 0 | 0.02 | 0.05 | 5 | set the board OTG switch to HOST
