promaaa/firefighter-robot/cad/final/kit/drawings/shelf_acrylic_5mm.dxf

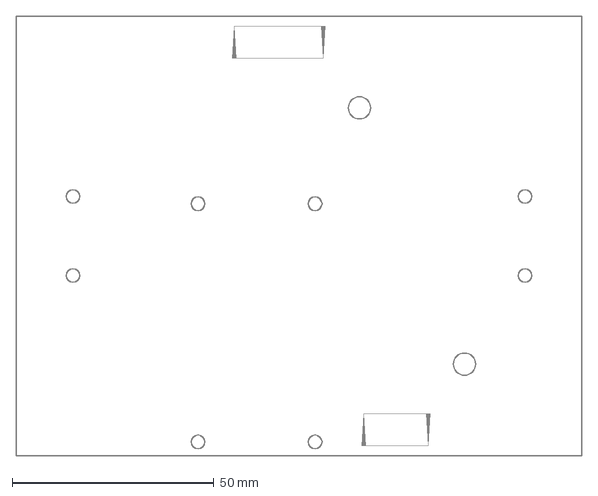
[picture p31: CAD file, 2026-10-22]
cad/final/kit/drawings/shelf_acrylic_5mm.dxf
140.0 x 109.0 mm
