promaaa/firefighter-robot/cad/final/kit/stl/pod_basket.stl

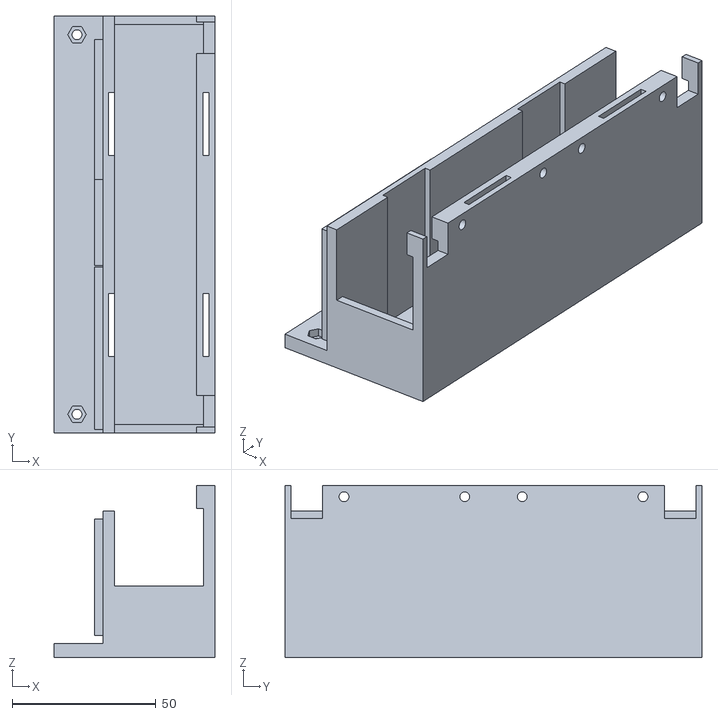
[picture p32: CAD file, 2026-10-22]
cad/final/kit/stl/pod_basket.stl
56.0 x 145.0 x 60.0
