promaaa/firefighter-robot/cad/final/out_f2/deck_f1.stl

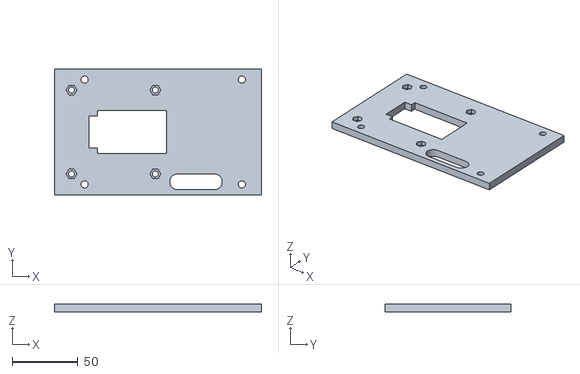
[picture p33: CAD file, 2026-10-22]
cad/final/out_f2/deck_f1.stl
158.0 x 96.0 x 6.00
