promaaa/firefighter-robot/cad/parts/out_sts3215/cam_usb32.stl

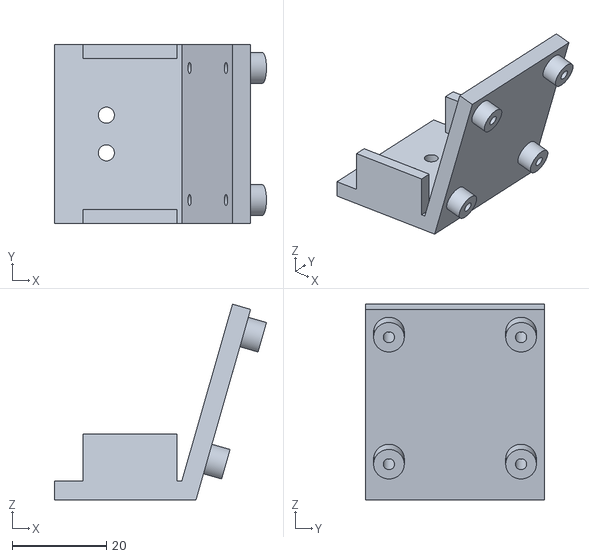
[picture p34: CAD file, 2026-10-22]
cad/parts/out_sts3215/cam_usb32.stl
44.9 x 38.0 x 41.5
