promaaa/firefighter-robot/cad/parts/out_sts3215/ref/ref_pan_bearing.stl

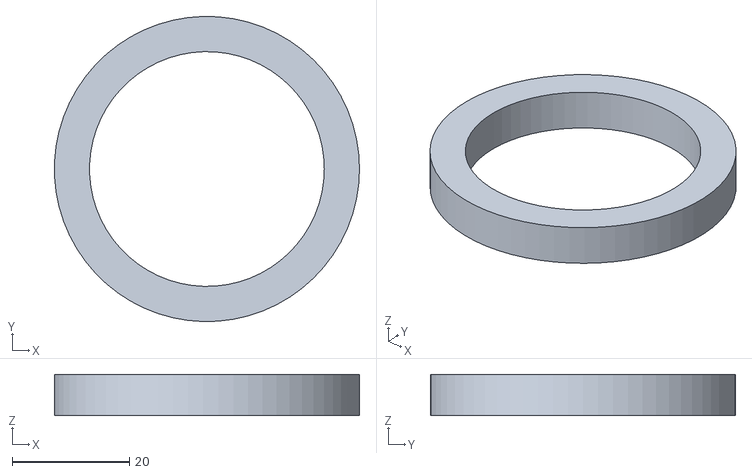
[picture p35: CAD file, 2026-10-22]
cad/parts/out_sts3215/ref/ref_pan_bearing.stl
52.0 x 52.0 x 7.00
