promaaa/firefighter-robot/source/robot_models/data/robots/asmr2026/asmr2026_humanoid_v1/meshes/leg_right_knee_pitch_visual.stl

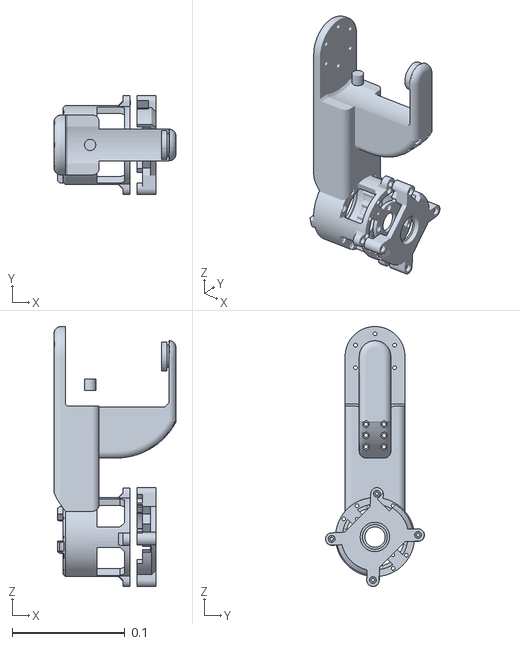
[picture p36: CAD file, 2026-11-11]
source/robot_models/data/robots/asmr2026/asmr2026_humanoid_v1/meshes/leg_right_knee_pitch_visual.stl
0.108 x 0.0876 x 0.23
