promaaa/firefighter-robot/cad/final/kit/drawings/pod_plate_al2.dxf

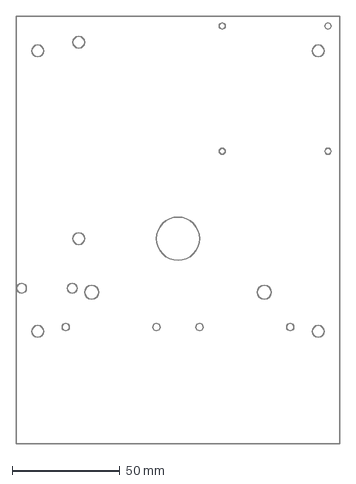
[picture p37: CAD file, 2026-10-22]
cad/final/kit/drawings/pod_plate_al2.dxf
150.0 x 198.0 mm
