promaaa/firefighter-robot/cad/final/out_f2/tank_right.stl

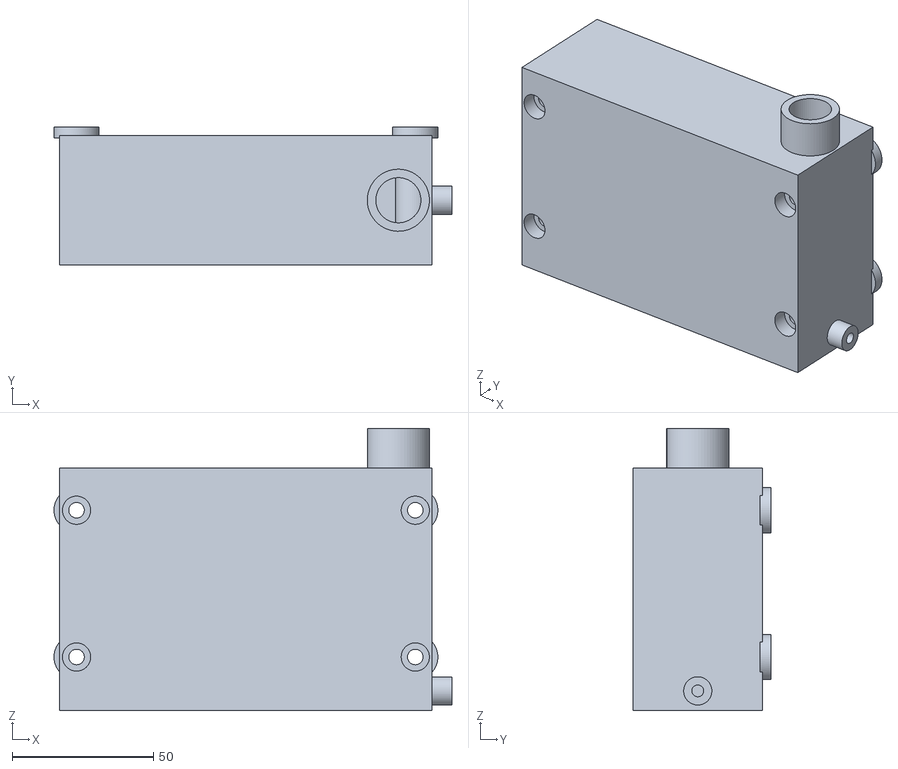
[picture p38: CAD file, 2026-10-22]
cad/final/out_f2/tank_right.stl
141.0 x 49.0 x 100.0
