promaaa/firefighter-robot/cad/parts/out_sts3215/pan_base.stl

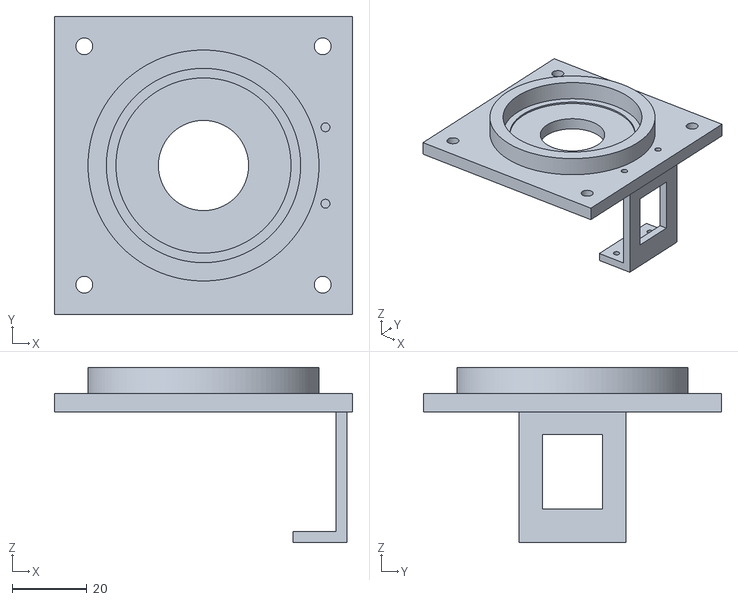
[picture p39: CAD file, 2026-10-22]
cad/parts/out_sts3215/pan_base.stl
80.0 x 80.0 x 47.0
