promaaa/firefighter-robot/source/robot_models/data/robots/asmr2026/asmr2026_humanoid_v1/meshes/leg_left_hip_pitch_visual.stl

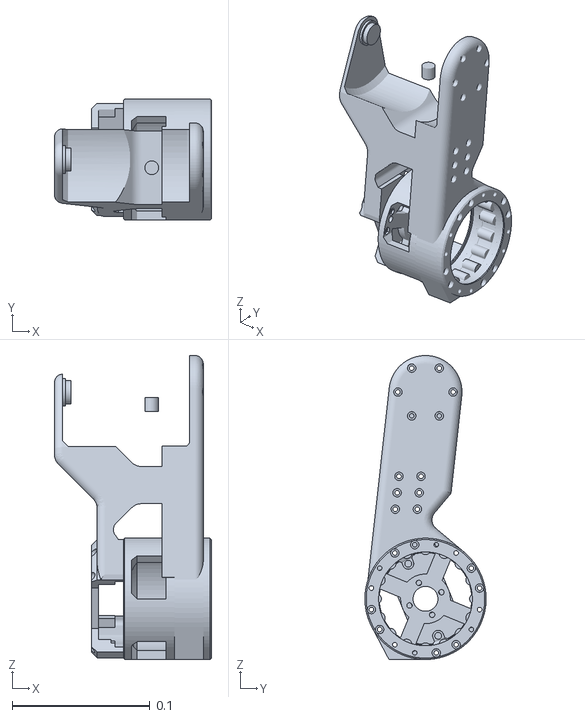
[picture p41: CAD file, 2026-11-11]
source/robot_models/data/robots/asmr2026/asmr2026_humanoid_v1/meshes/leg_left_hip_pitch_visual.stl
0.114 x 0.088 x 0.22
