promaaa/firefighter-robot/cad/final/kit/stl/pod_spacer_left.stl

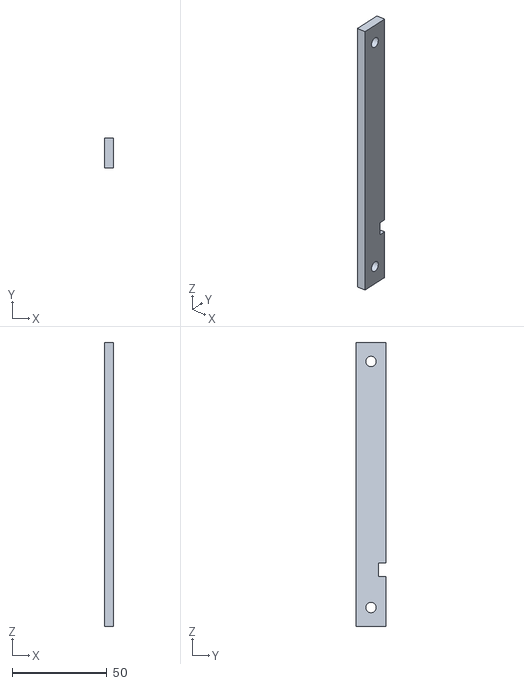
[picture p42: CAD file, 2026-10-22]
cad/final/kit/stl/pod_spacer_left.stl
5.00 x 16.0 x 150.0
