promaaa/firefighter-robot/cad/parts/out_sts3215/payload_plate.stl

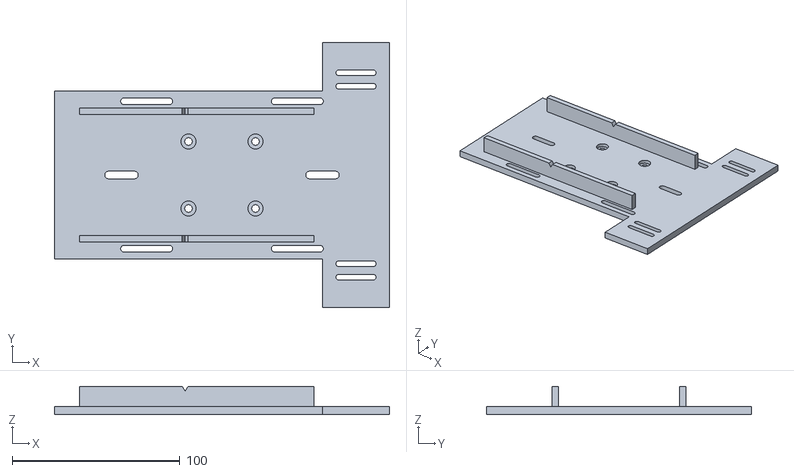
[picture p43: CAD file, 2026-10-22]
cad/parts/out_sts3215/payload_plate.stl
200.0 x 158.0 x 17.0
