promaaa/firefighter-robot/cad/parts/out_sts3215/ref/ref_tilt_servo.stl

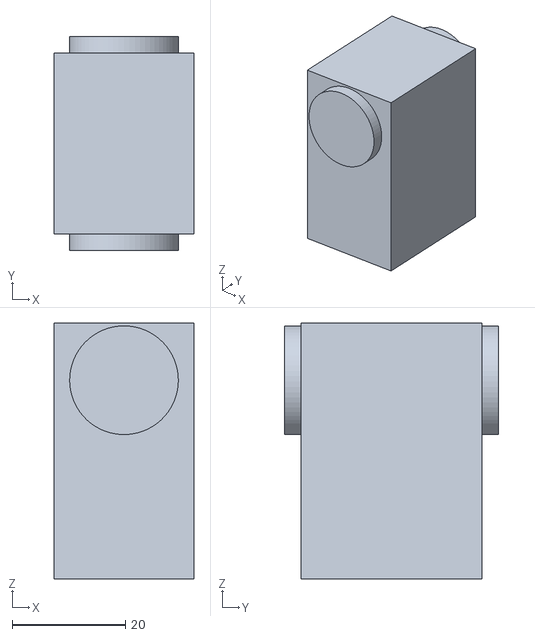
[picture p44: CAD file, 2026-10-22]
cad/parts/out_sts3215/ref/ref_tilt_servo.stl
24.7 x 37.8 x 45.2
