promaaa/firefighter-robot/source/robot_models/data/robots/asmr2026/asmr2026_humanoid_v1/meshes/leg_left_hip_yaw_visual.stl

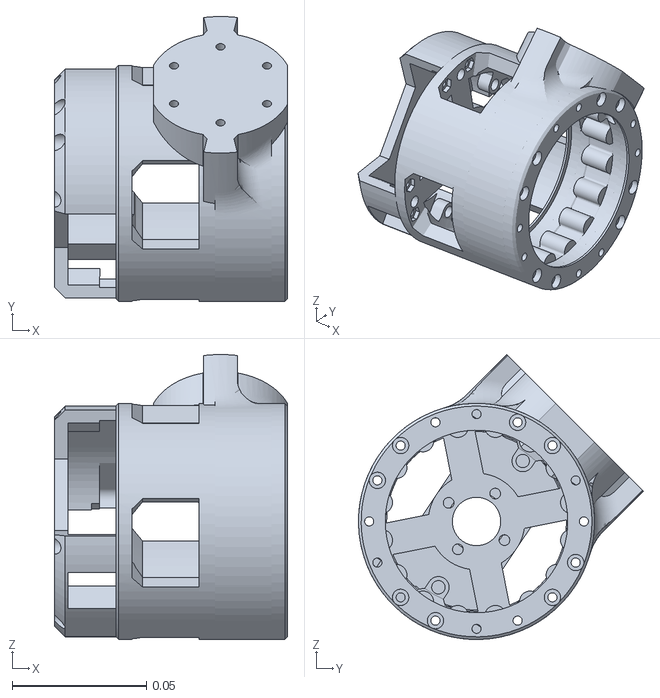
[picture p45: CAD file, 2026-11-11]
source/robot_models/data/robots/asmr2026/asmr2026_humanoid_v1/meshes/leg_left_hip_yaw_visual.stl
0.0869 x 0.106 x 0.106
