promaaa/firefighter-robot/cad/parts/out_sts3215/ref/ref_cam_thermal.stl

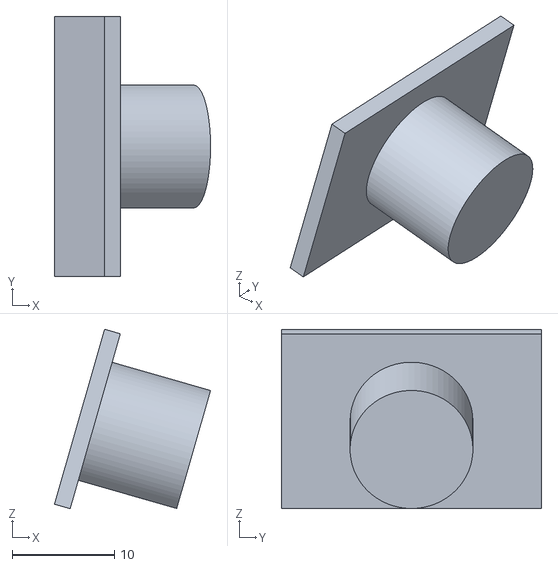
[picture p46: CAD file, 2026-10-22]
cad/parts/out_sts3215/ref/ref_cam_thermal.stl
15.3 x 25.4 x 17.5
