promaaa/firefighter-robot/cad/parts/out_sts3215/tilt_u.stl

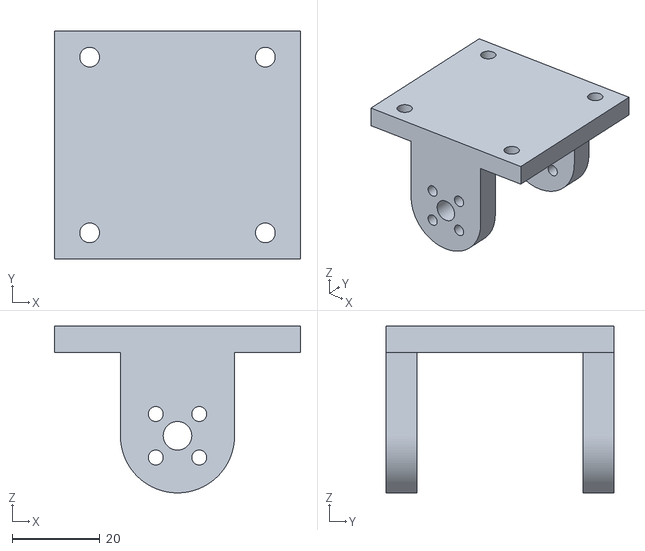
[picture p47: CAD file, 2026-10-22]
cad/parts/out_sts3215/tilt_u.stl
56.0 x 51.8 x 38.0
