promaaa/firefighter-robot/source/robot_models/data/robots/asmr2026/asmr2026_humanoid_v1/meshes/leg_left_hip_roll_visual.stl

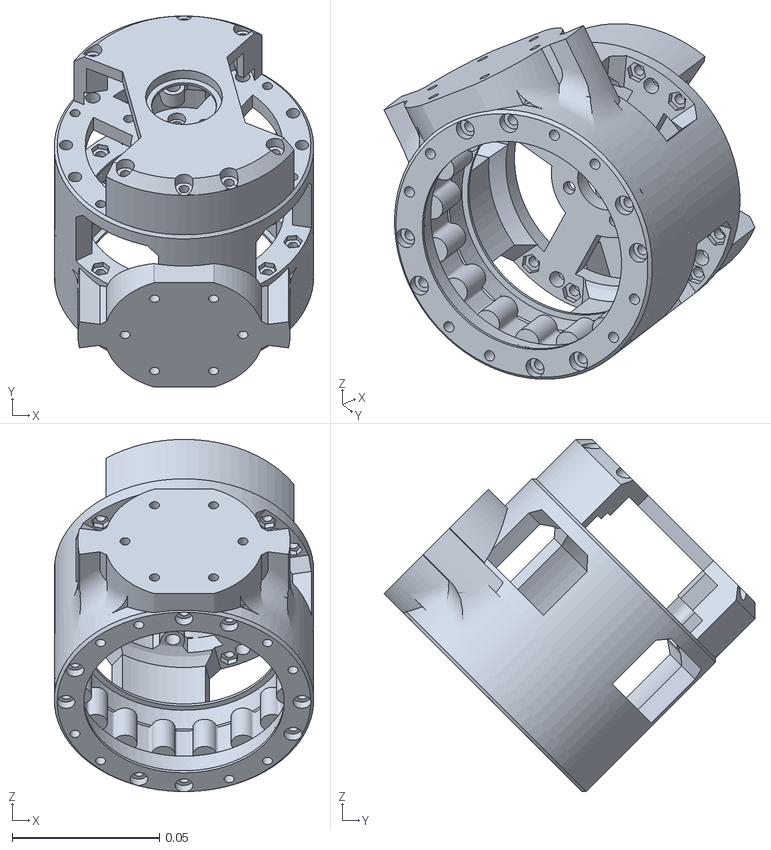
[picture p48: CAD file, 2026-11-11]
source/robot_models/data/robots/asmr2026/asmr2026_humanoid_v1/meshes/leg_left_hip_roll_visual.stl
0.088 x 0.126 x 0.119
