promaaa/firefighter-robot/cad/final/kit/stl/tank_left_tub.stl

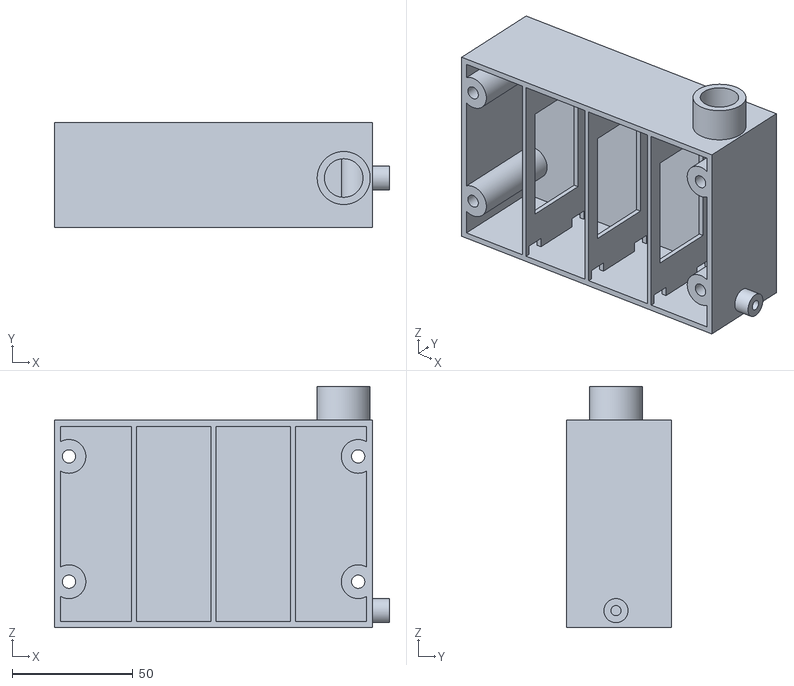
[picture p49: CAD file, 2026-10-22]
cad/final/kit/stl/tank_left_tub.stl
139.0 x 43.5 x 100.0
