promaaa/firefighter-robot/cad/parts/out_sts3215/pan_yoke.stl

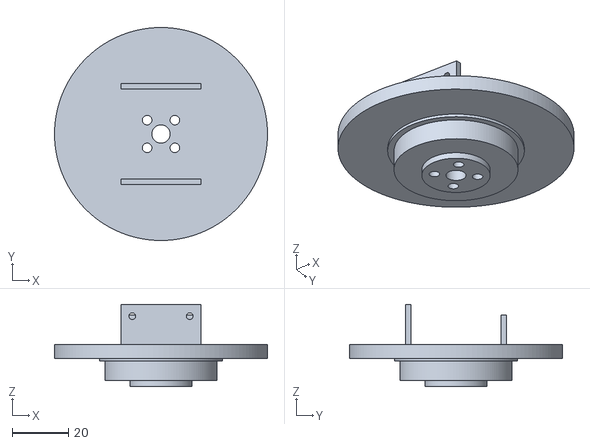
[picture p50: CAD file, 2026-10-22]
cad/parts/out_sts3215/pan_yoke.stl
76.0 x 76.0 x 29.3
