promaaa/firefighter-robot/source/robot_models/data/robots/asmr2026/asmr2026_humanoid_v1/meshes/base_visual.stl

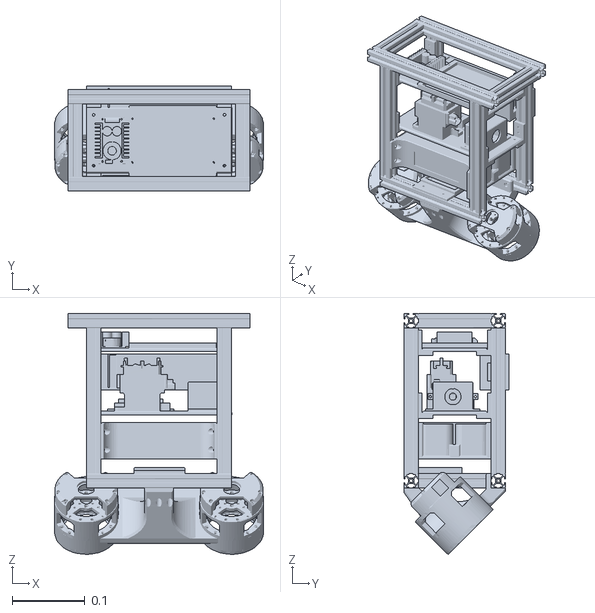
[picture p51: CAD file, 2026-11-11]
source/robot_models/data/robots/asmr2026/asmr2026_humanoid_v1/meshes/base_visual.stl
0.288 x 0.145 x 0.331
