promaaa/firefighter-robot/cad/final/kit/stl/resistor_mount_right.stl

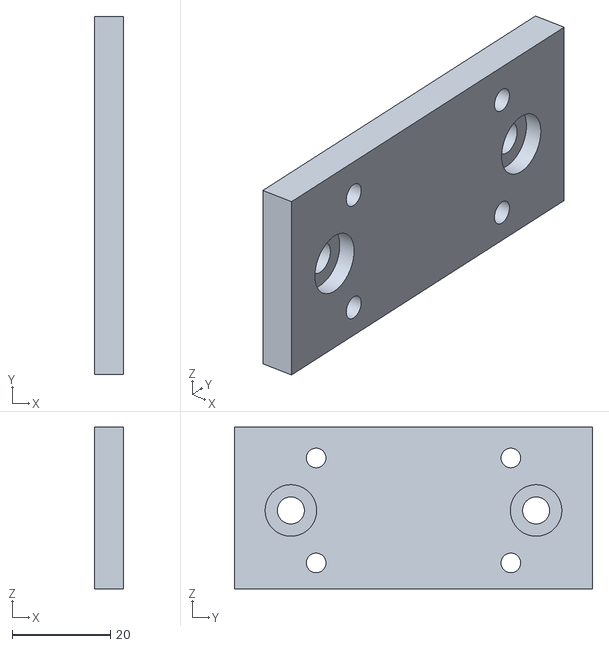
[picture p52: CAD file, 2026-10-22]
cad/final/kit/stl/resistor_mount_right.stl
6.00 x 73.0 x 33.0
