promaaa/firefighter-robot/cad/parts/out_sts3215/cam_mlx90640.stl

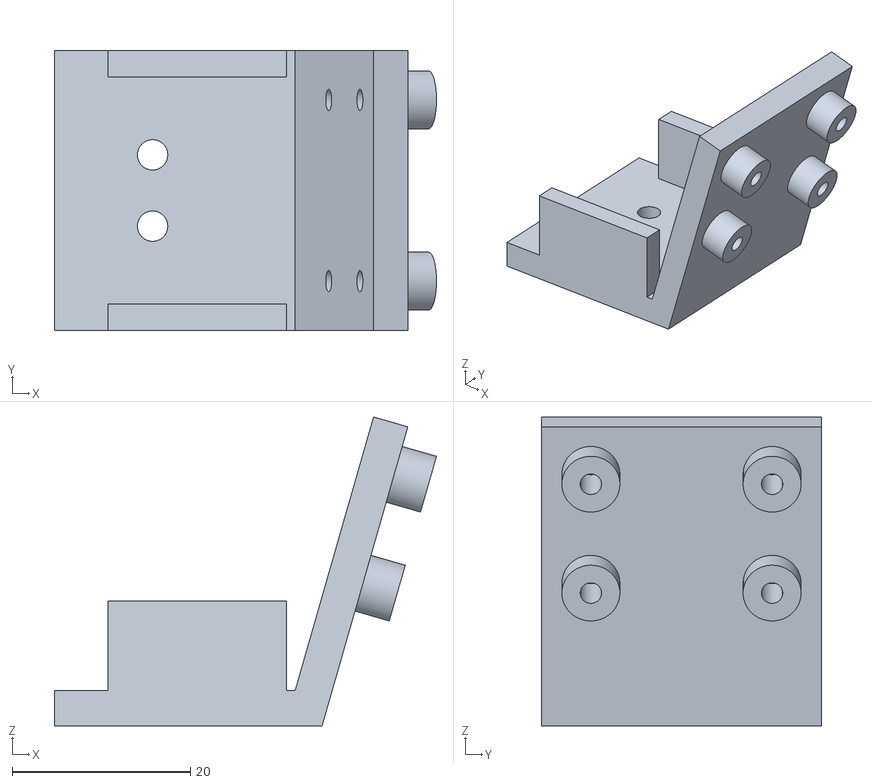
[picture p53: CAD file, 2026-10-22]
cad/parts/out_sts3215/cam_mlx90640.stl
42.8 x 31.4 x 34.6
