promaaa/firefighter-robot/cad/parts/out_sts3215/ref/ref_gun.stl

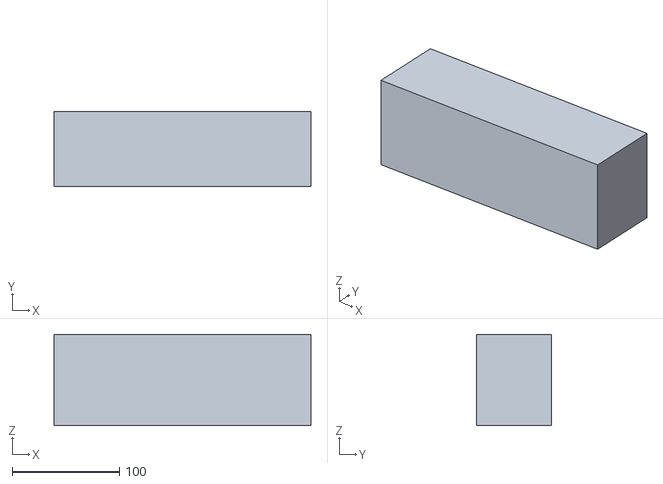
[picture p54: CAD file, 2026-10-22]
cad/parts/out_sts3215/ref/ref_gun.stl
240.0 x 70.0 x 85.0
