promaaa/firefighter-robot/source/robot_models/data/robots/asmr2026/asmr2026_humanoid_v1/meshes/leg_left_ankle_pitch_visual.stl

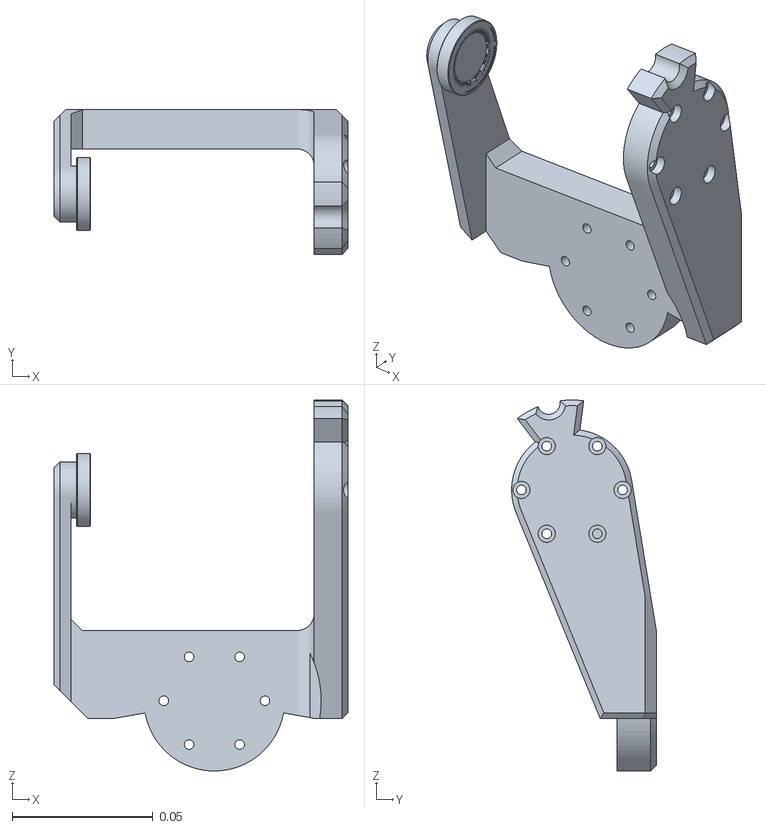
[picture p55: CAD file, 2026-11-11]
source/robot_models/data/robots/asmr2026/asmr2026_humanoid_v1/meshes/leg_left_ankle_pitch_visual.stl
0.105 x 0.0515 x 0.132
