promaaa/firefighter-robot/cad/final/kit/stl/pod_cover.stl

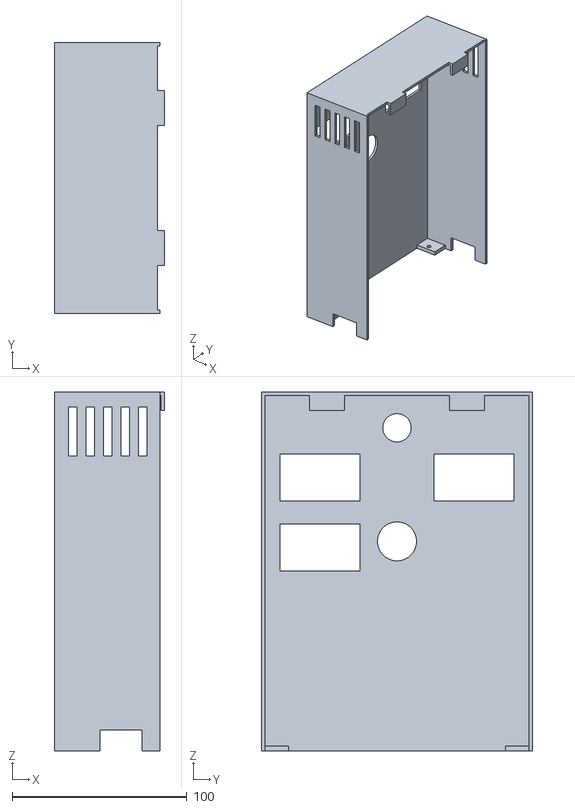
[picture p56: CAD file, 2026-10-22]
cad/final/kit/stl/pod_cover.stl
63.0 x 155.0 x 205.5
