promaaa/firefighter-robot/cad/parts/out_sts3215/deck.stl

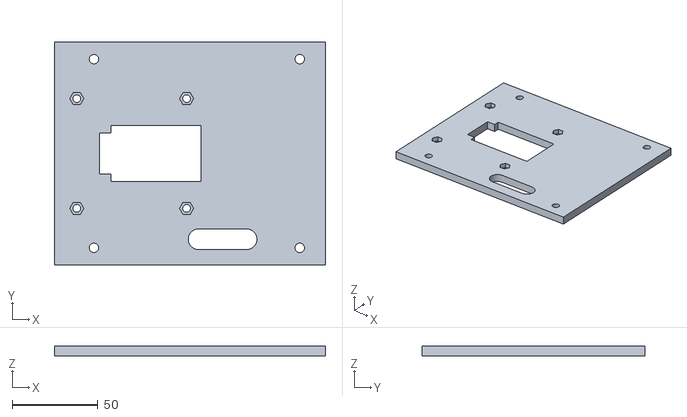
[picture p57: CAD file, 2026-10-22]
cad/parts/out_sts3215/deck.stl
158.0 x 130.0 x 6.00
