promaaa/firefighter-robot/cad/final/kit/stl/hose_clip.stl

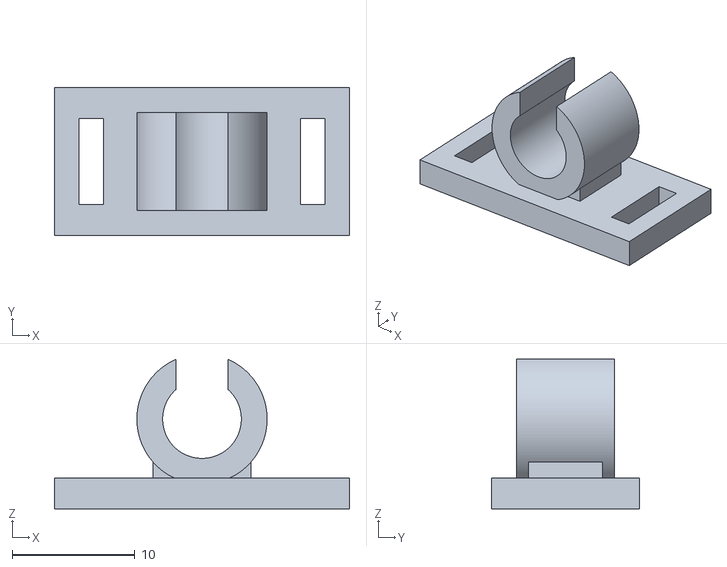
[picture p58: CAD file, 2026-10-22]
cad/final/kit/stl/hose_clip.stl
24.0 x 12.0 x 12.2
