promaaa/firefighter-robot/cad/final/kit/stl/frame_clip.stl

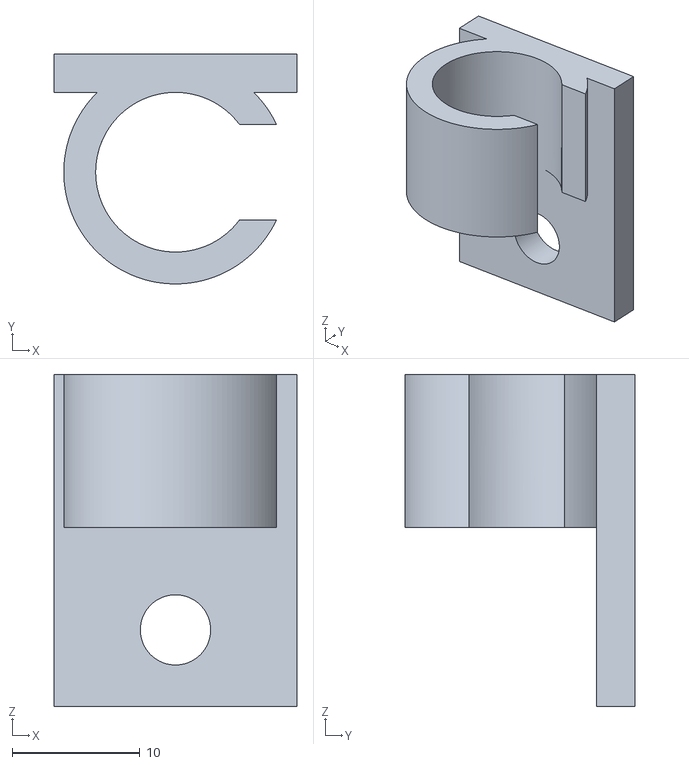
[picture p59: CAD file, 2026-10-22]
cad/final/kit/stl/frame_clip.stl
19.0 x 18.0 x 26.0
