promaaa/firefighter-robot/source/robot_models/data/robots/asmr2026/asmr2026_humanoid_v1/meshes/leg_left_ankle_roll_visual.stl

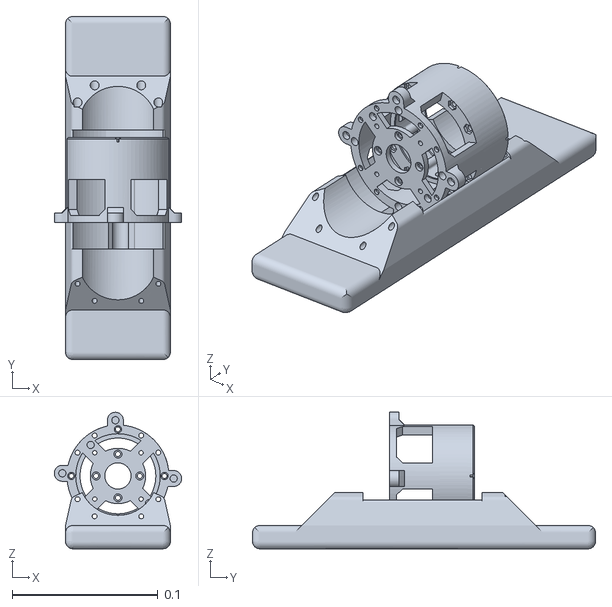
[picture p60: CAD file, 2026-11-11]
source/robot_models/data/robots/asmr2026/asmr2026_humanoid_v1/meshes/leg_left_ankle_roll_visual.stl
0.0874 x 0.236 x 0.0937
