promaaa/firefighter-robot/cad/final/kit/stl/tank_right_plate.stl

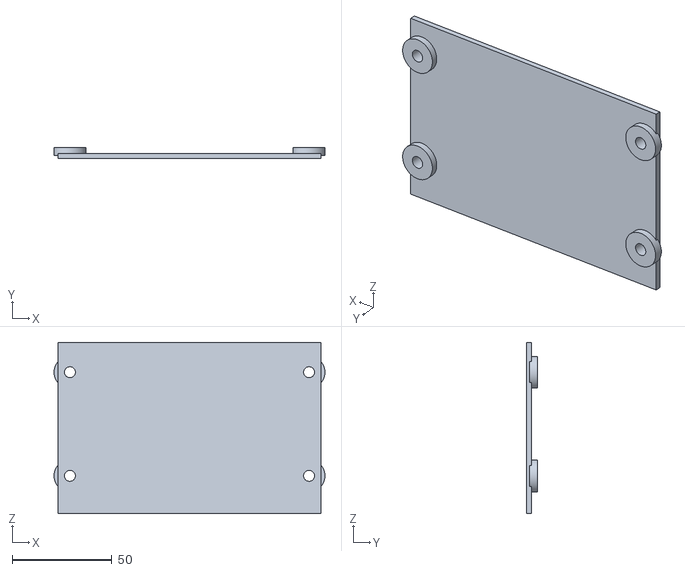
[picture p61: CAD file, 2026-10-22]
cad/final/kit/stl/tank_right_plate.stl
136.0 x 5.50 x 86.0
