promaaa/firefighter-robot/source/robot_models/data/robots/asmr2026/asmr2026_humanoid_v1/meshes/imu_2_visual.stl

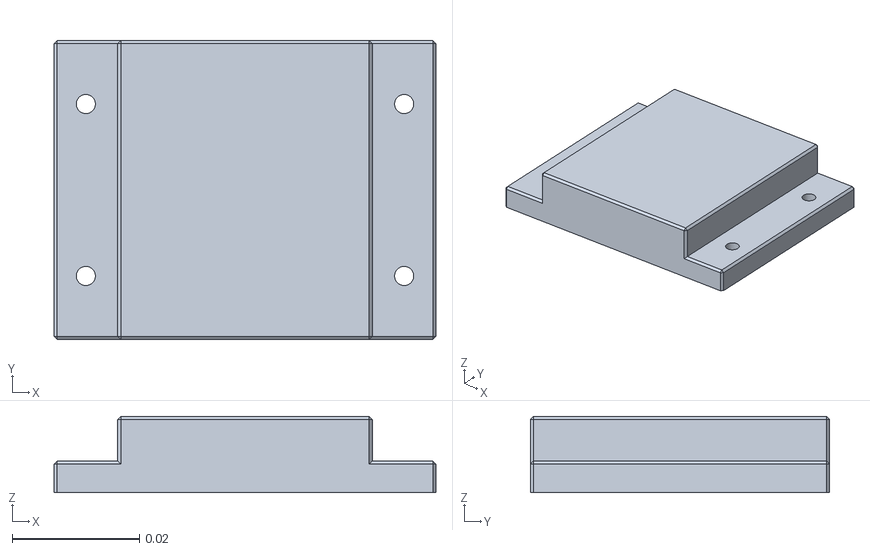
[picture p62: CAD file, 2026-11-11]
source/robot_models/data/robots/asmr2026/asmr2026_humanoid_v1/meshes/imu_2_visual.stl
0.06 x 0.047 x 0.012
