promaaa/firefighter-robot/cad/final/kit/stl/holder_6s_vega.stl

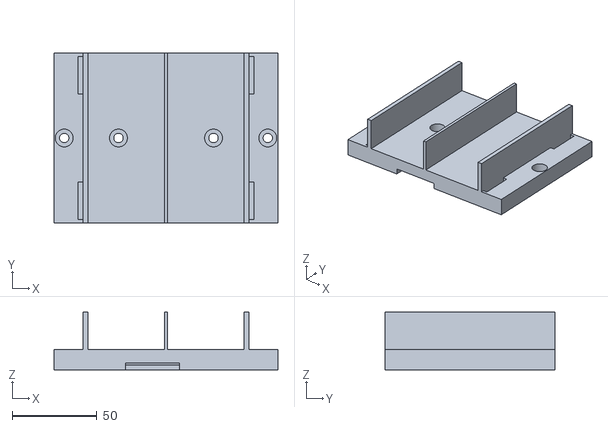
[picture p63: CAD file, 2026-10-22]
cad/final/kit/stl/holder_6s_vega.stl
132.0 x 100.0 x 34.0
