promaaa/firefighter-robot/cad/final/kit/stl/imu_mount.stl

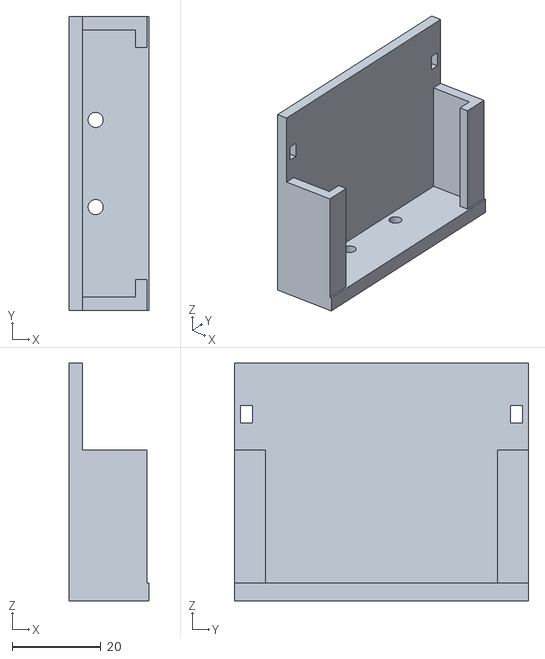
[picture p64: CAD file, 2026-10-22]
cad/final/kit/stl/imu_mount.stl
18.0 x 66.1 x 53.5
