promaaa/firefighter-robot/cad/final/kit/stl/pump_holder.stl

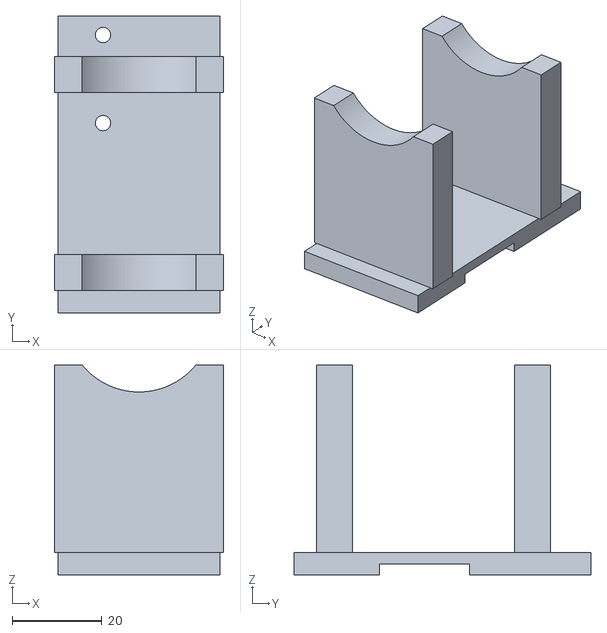
[picture p65: CAD file, 2026-10-22]
cad/final/kit/stl/pump_holder.stl
37.6 x 66.0 x 46.7
