promaaa/firefighter-robot/cad/final/kit/stl/head_f1.stl

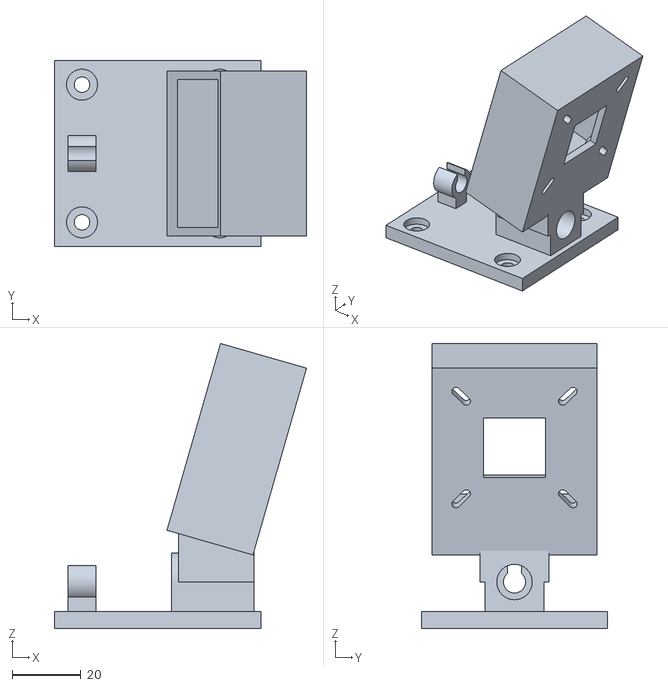
[picture p66: CAD file, 2026-10-22]
cad/final/kit/stl/head_f1.stl
73.2 x 54.0 x 82.8
