promaaa/firefighter-robot/cad/final/kit/stl/holder_6s_zeee.stl

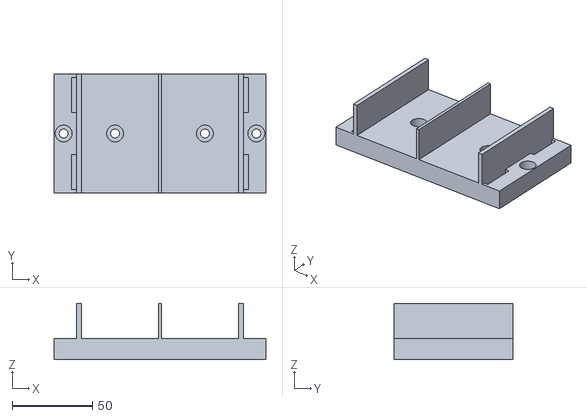
[picture p67: CAD file, 2026-10-22]
cad/final/kit/stl/holder_6s_zeee.stl
132.0 x 74.0 x 35.0
