promaaa/firefighter-robot/(list of files, cad)

Other CAD files:
cad/final/kit/stl/deck_f1.stl
cad/final/out_f2/tank_left.stl
cad/final/kit/stl/pan_base.stl
cad/parts/out_sts3215/ref/ref_pan_servo.stl
source/robot_models/data/robots/asmr2026/asmr2026_humanoid_v1/meshes/leg_left_knee_pitch_visual.stl
source/robot_models/data/robots/asmr2026/asmr2026_humanoid_v1/meshes/leg_right_hip_pitch_visual.stl
cad/final/kit/stl/resistor_mount_left.stl
source/robot_models/data/robots/asmr2026/asmr2026_humanoid_v1/meshes/leg_right_hip_yaw_visual.stl
source/robot_models/data/robots/asmr2026/asmr2026_humanoid_v1/meshes/leg_right_ankle_pitch_visual.stl
cad/final/kit/stl/tank_left_plate.stl
source/robot_models/data/robots/asmr2026/asmr2026_humanoid_v1/meshes/leg_right_ankle_roll_visual.stl
cad/final/kit/stl/pan_yoke.stl
source/robot_models/data/robots/asmr2026/asmr2026_humanoid_v1/meshes/leg_right_hip_roll_visual.stl
cad/final/kit/stl/pod_spacer_right.stl
cad/final/kit/stl/tank_right_tub.stl
cad/final/kit/stl/tilt_u.stl
