promaaa/firefighter-robot/cad/final/kit/print_sheet.md

# Print sheet, final design F2 (generated by kit.py)

Status: **planned**. Nothing is printed. Mass and time are estimates from the CAD volume, not from a slicer.

**Assumed:** PETG at 1.27 g/cm3, 0.4 mm nozzle, 0.2 mm layers, 4 perimeters (1.6 mm), 5 top and bottom layers, gyroid infill. The time model is 5 mm3/s of plastic, plus 20 % for moves, plus 10 min per part. Your slicer gives the real time.

The STL files are in the robot frame. Turn each part to the orientation in the table in the slicer.

| Part | Qty | Material | Infill | Orientation on the bed | Supports | Size (mm) | Mass each (g) | Time each (h:min) |
|---|---|---|---|---|---|---|---|---|
| pan_base | 1 | PETG | 40 % | shelf down | tree supports under the servo foot | 80 x 80 x 47 | 43 | 2:24 |
| pan_yoke | 1 | PETG | 40 % | disc down | none | 76 x 76 x 29 | 34 | 1:57 |
| tilt_u | 1 | PETG | 40 % | U base down | none | 56 x 52 x 38 | 28 | 1:37 |
| head_f1 | 1 | PETG | 30 % | base down | none (the window and the roof are bridges) | 73 x 54 x 83 | 54 | 3:00 |
| holder_6s_zeee | 1 | PETG | 30 % | base down | none (the strap tunnels are 22 mm bridges) | 132 x 74 x 35 | 115 | 6:11 |
| holder_6s_vega | 0 | PETG | 30 % | base down | none. Print instead of the Zeee holder if the TA buys VEGA packs | 132 x 100 x 34 | 141 | 7:34 |
| pod_spacer_left | 1 | PETG | 100 % | flat | none | 5 x 16 x 150 | 15 | 0:56 |
| pod_spacer_right | 1 | PETG | 100 % | flat | none | 5 x 16 x 150 | 15 | 0:56 |
| pod_basket | 1 | PETG | 40 % | back wall down (x = -77 face on the bed) | none | 56 x 145 x 60 | 118 | 6:22 |
| pod_cover | 1 | PETG | 30 % | upside down, top wall on the bed | under the 2 bottom screw tabs | 63 x 155 x 206 | 151 | 8:06 |
| imu_mount | 1 | PETG | 40 % | foot down | none | 18 x 66 x 54 | 22 | 1:21 |
| hose_clip | 4 | PETG | 100 % | foot down | none | 24 x 12 x 12 | 1 | 0:14 |
| frame_clip | 8 | PETG | 100 % | foot down (flat face on the bed) | none | 19 x 18 x 26 | 3 | 0:19 |
| pump_holder | 1 | PETG | 40 % | base down | none. It fits the DWP-385 only: wait for the KLP02 holder | 38 x 66 x 47 | 33 | 1:54 |
| resistor_mount_left | 1 | PETG | 40 % | flat, insert holes up | none | 6 x 73 x 33 | 15 | 0:57 |
| resistor_mount_right | 1 | PETG | 40 % | flat, insert holes up | none | 6 x 73 x 33 | 15 | 0:57 |
| tank_left_tub | 1 | PETG | 100 % | outer face (y = 124) on the bed | none | 139 x 44 x 100 | 128 | 6:52 |
| tank_left_plate | 1 | PETG | 100 % | glue face (y = 80.5) on the bed, pads up | none | 136 x 6 x 86 | 38 | 2:11 |
| tank_right_tub | 1 | PETG | 100 % | outer face (y = -124) on the bed | none | 139 x 44 x 100 | 128 | 6:52 |
| tank_right_plate | 1 | PETG | 100 % | glue face (y = -80.5) on the bed, pads up | none | 136 x 6 x 86 | 38 | 2:11 |
| deck_f1 | 1 | PETG | 40 % | flat, nut pockets up | none | 158 x 96 x 6 | 76 | 4:10 |

Total for one robot: 1.09 kg of PETG and about 62 h of printing (the VEGA holder is not counted).

Print the 4 tank pieces solid (100 %), so that the walls hold water. Glue each plate on its tub with two-part epoxy. Leak-test each glued tank for 1 hour.
