promaaa/firefighter-robot/vision/results/video_check.md

Detector threshold 0.28. 10 frames per second, up to 15 s per clip.

| Clip | Content | Frames | Frames with a detection >= 0.28 | Frames with a detection >= 0.5 | Highest confidence |
|---|---|---|---|---|---|
| candle_and_match_LoKiLeCh_CCBYSA3.ogv | fire: candle, close | 150 | 95 % | 94 % | 0.82 |
| candle_blow_GilesLaurent_CCBYSA4.webm | mixed: tea light lit, then blown out | 150 | 78 % | 71 % | 0.84 |
| burning_pet_bottle_CC0.ogv | fire: burning plastic bottle | 150 | 100 % | 95 % | 0.90 |
| campfire_Vijayanrajapuram_CCBYSA4.webm | fire: small campfire, far away | 150 | 58 % | 11 % | 0.62 |
| flameless_candle_1_CC0.webm | no fire: LED candle | 87 | 21 % | 0 % | 0.33 |
| flameless_candle_2_CC0.webm | no fire: LED candle | 70 | 50 % | 0 % | 0.36 |
