promaaa/firefighter-robot/sim/sim2sim/results/results_noise.md

| Model | Effort limit | Command | Result in 20 s | Mean vx, 5-20 s (m/s) | Mean yaw rate (rad/s) | Saturated steps (%) | Peak torque (Nm) |
|---|---:|---|---|---:|---:|---:|---:|
| asmr2026_humanoid_v1 | MJCF | stand | no fall | -0.00 | +0.00 | 0.1 | 18.1 |
| asmr2026_humanoid_v1 | MJCF | vx 0.3 | no fall | +0.29 | -0.04 | 3.2 | 18.1 |
| asmr2026_humanoid_v1 | MJCF | yaw 0.5 | no fall | +0.00 | +0.56 | 1.1 | 18.1 |
| asmr2026_humanoid_v1 | MJCF | vx 0.2 + yaw 0.5 | no fall | +0.20 | +0.52 | 2.2 | 18.1 |
