promaaa/firefighter-robot/sim/water/results/water.md

# Water system numbers (generated by sim/water/water.py)

Status: tested in simulation. Pump values: datasheets or shop pages (see `PUMPS` in the script). Not measured.
Geometry: nozzle 0.905 m over the floor, lift 0.23 m (full tank) to 0.31 m (empty), 1.0 m of 3.2 mm tube, 0.781 L in two R2 tanks (F2). Ranges: from the nozzle to the floor.

## Kamoer KLP02, 24 V, brushless, self-priming at 22.2 V, fittings: filter and check valve

Source: Kamoer data for the 24 V brushless KLP02: flow 0.7 L/min or more, head 30 m or more (294 kPa), suction lift 4 m or more, power 12 W or less (0.5 A at 24 V), about 250 g, switch control. ESTIMATE from two datasheet points: a straight line from the free flow to the head at zero flow (ASSUMED shape). The datasheet gives minimum values.

| Nozzle (mm) | Flow (L/min) | Flow (g/s) | Nozzle pressure (kPa) | Exit speed (m/s) | Intact column, laminar / turbulent (mm) | Max range, no drag (m) | Max range, best estimate (m) | Max range, low estimate (m) | Spray time, both tanks full (min) | Recoil (mN) |
|---|---|---|---|---|---|---|---|---|---|---|
| 0.8 | 0.35 | 5.8 | 93.0 | 13.0 | 431 / 70 | 16.3 (+30°) | 6.8 (+30°) | 2.6 (+15°) | 2.1 | 75 |
| 1.0 | 0.42 | 7.0 | 55.1 | 10.0 | 463 / 80 | 10.2 (+30°) | 6.1 (+30°) | 2.8 (+20°) | 1.8 | 70 |
| 1.2 | 0.46 | 7.7 | 32.1 | 7.6 | 465 / 86 | 6.4 (+30°) | 4.8 (+30°) | 2.6 (+25°) | 1.6 | 59 |
| 1.5 | 0.49 | 8.2 | 14.9 | 5.2 | 442 / 90 | 3.5 (+30°) | 3.1 (+30°) | 2.1 (+25°) | 1.5 | 43 |
| 2.0 | 0.51 | 8.5 | 5.1 | 3.0 | 396 / 93 | 1.6 (+30°) | 1.6 (+30°) | 1.3 (+25°) | 1.5 | 26 |

Range to the floor per elevation (best estimate / low estimate, m):

| Nozzle (mm) | -10° | -5° | +0° | +5° | +10° | +15° | +20° | +25° | +30° |
|---|---|---|---|---|---|---|---|---|---|
| 0.8 | 3.1 / 2.2 | 3.7 / 2.3 | 4.5 / 2.4 | 5.2 / 2.5 | 5.8 / 2.6 | 6.2 / 2.6 | 6.6 / 2.6 | 6.8 / 2.6 | 6.8 / 2.5 |
| 1.0 | 2.7 / 2.1 | 3.2 / 2.3 | 3.8 / 2.4 | 4.3 / 2.6 | 4.9 / 2.7 | 5.3 / 2.7 | 5.7 / 2.8 | 6.0 / 2.7 | 6.1 / 2.7 |
| 1.2 | 2.3 / 1.9 | 2.6 / 2.1 | 3.0 / 2.2 | 3.4 / 2.4 | 3.8 / 2.5 | 4.2 / 2.5 | 4.5 / 2.6 | 4.7 / 2.6 | 4.8 / 2.6 |
| 1.5 | 1.7 / 1.5 | 1.9 / 1.6 | 2.2 / 1.8 | 2.4 / 1.9 | 2.6 / 2.0 | 2.7 / 2.1 | 2.9 / 2.1 | 3.0 / 2.1 | 3.1 / 2.1 |
| 2.0 | 1.1 / 1.0 | 1.2 / 1.1 | 1.3 / 1.2 | 1.4 / 1.2 | 1.4 / 1.3 | 1.5 / 1.3 | 1.5 / 1.3 | 1.5 / 1.3 | 1.6 / 1.3 |

## motorbank DWP-385, 2-stage gear (comparison only) at 11.1 V, fittings: filter and check valve

Source: motorbank DWP-385 12 V datasheet image on eleparts goods 3850995 (read 2026-10-15): 6-18 V, 900 cc/min and 0.4-0.65 A at no load, 540 cc/min and 0.7-1.1 A rated, locking pressure 1.7 kgf/cm2 or more, 130 g, intermittent running. Straight line from free flow to the locking pressure (ASSUMED). It passes 540 cc/min at 67 kPa. Run at 11.1 V (3S).

| Nozzle (mm) | Flow (L/min) | Flow (g/s) | Nozzle pressure (kPa) | Exit speed (m/s) | Intact column, laminar / turbulent (mm) | Max range, no drag (m) | Max range, best estimate (m) | Max range, low estimate (m) | Spray time, both tanks full (min) | Recoil (mN) |
|---|---|---|---|---|---|---|---|---|---|---|
| 0.8 | 0.30 | 5.1 | 70.5 | 11.3 | 376 / 64 | 12.7 (+30°) | 6.0 (+30°) | 2.4 (+15°) | 2.5 | 57 |
| 1.0 | 0.39 | 6.4 | 46.7 | 9.2 | 426 / 76 | 8.8 (+30°) | 5.6 (+30°) | 2.6 (+20°) | 1.9 | 59 |
| 1.2 | 0.44 | 7.4 | 29.4 | 7.3 | 445 / 83 | 5.9 (+30°) | 4.6 (+30°) | 2.5 (+25°) | 1.7 | 54 |
| 1.5 | 0.49 | 8.1 | 14.7 | 5.2 | 438 / 89 | 3.4 (+30°) | 3.1 (+30°) | 2.1 (+25°) | 1.5 | 42 |
| 2.0 | 0.52 | 8.6 | 5.2 | 3.1 | 401 / 94 | 1.6 (+30°) | 1.6 (+30°) | 1.4 (+25°) | 1.4 | 26 |

Range to the floor per elevation (best estimate / low estimate, m):

| Nozzle (mm) | -10° | -5° | +0° | +5° | +10° | +15° | +20° | +25° | +30° |
|---|---|---|---|---|---|---|---|---|---|
| 0.8 | 2.8 / 2.0 | 3.4 / 2.1 | 4.0 / 2.2 | 4.5 / 2.3 | 5.1 / 2.4 | 5.5 / 2.4 | 5.7 / 2.4 | 5.9 / 2.4 | 6.0 / 2.3 |
| 1.0 | 2.6 / 2.0 | 3.0 / 2.1 | 3.5 / 2.3 | 4.0 / 2.4 | 4.5 / 2.5 | 4.9 / 2.6 | 5.2 / 2.6 | 5.4 / 2.6 | 5.6 / 2.5 |
| 1.2 | 2.2 / 1.8 | 2.6 / 2.0 | 2.9 / 2.1 | 3.3 / 2.3 | 3.6 / 2.4 | 4.0 / 2.5 | 4.2 / 2.5 | 4.4 / 2.5 | 4.6 / 2.5 |
| 1.5 | 1.7 / 1.5 | 1.9 / 1.6 | 2.1 / 1.8 | 2.3 / 1.9 | 2.5 / 2.0 | 2.7 / 2.0 | 2.9 / 2.1 | 3.0 / 2.1 | 3.1 / 2.1 |
| 2.0 | 1.1 / 1.0 | 1.2 / 1.1 | 1.3 / 1.2 | 1.4 / 1.2 | 1.4 / 1.3 | 1.5 / 1.3 | 1.5 / 1.3 | 1.6 / 1.4 | 1.6 / 1.3 |

## Sensitivity (recommended pump and nozzle)

| Case | Flow (L/min) | Exit speed (m/s) | Best-estimate range at +15° (m) |
|---|---|---|---|
| baseline: empty tank, filter and check valve | 0.42 | 10.0 | 5.3 |
| full tank | 0.42 | 10.0 | 5.4 |
| no check valve | 0.44 | 10.5 | 5.6 |
| no filter, no check valve | 0.45 | 10.7 | 5.7 |
| tube 0.7 m | 0.42 | 10.0 | 5.4 |
| tube 1.3 m | 0.42 | 9.9 | 5.3 |
| bus full, 25.2 V | 0.47 | 11.0 | 5.9 |
| bus low, 21 V | 0.40 | 9.5 | 5.1 |
| datasheet voltage, 24 V | 0.45 | 10.6 | 5.7 |
| nozzle Cd 0.65 (sharp orifice) | 0.38 | 11.8 | 6.0 |
| quadratic pump curve | 0.48 | 11.4 | 6.2 |

Equivalent constant drag for `aim/` (`ControllerConfig.drag`): 0.109 1/m (fit to the best estimate at +15°).
Jet speed against the bus voltage: v0 = 10.0 m/s × (V / 22.2 V)^0.80 (fit from 21 V and 25.2 V, ASSUMED speed ~ voltage).

## Fire capacity (recommended pump and nozzle)

- Water flow 7.0 g/s. If all of it evaporates, it takes 18 kW. This is an upper limit: on a real fire much of the water runs off.
- At the hand-application rates of 9 to 15 L/(m2 min), the flow covers 280 to 467 cm2 of fire floor area, a square of 17 to 22 cm.
- A loose paper fire of that area peaks at about 8 to 22 kW.
