promaaa/firefighter-robot/vision/results/calib_board_9x6_25mm_A4.pdf

this line is 100 mm: measure it

Calibration board: 9 x 6 inner corners, 25 mm squares. Print at 100 % (no scaling).
