promaaa/firefighter-robot/vision/results/variants.md

Real test = D-Fire + FASDD + Barman test images. IoU 0.5.

| Variant | Threshold | Precision | Recall | mAP50 | mAP50-95 | mAP50, new scenes | Recall, small fires | FP per image, COCO fire-like | Synthetic mAP50 | Smallest width at 50 % recall, IoU 0.25 (px) |
|---|---|---|---|---|---|---|---|---|---|---|
| all416 | 0.28 | 0.781 | 0.745 | 0.809 | 0.503 | 0.747 | 0.472 | 0.045 | 0.911 | 16 |
| real416 | 0.25 | 0.752 | 0.762 | 0.811 | 0.506 | 0.744 | 0.504 | 0.061 | 0.164 | 16 |
