promaaa/firefighter-robot/sim/mission/results/sprite_check.md

Detection rate of one visible full-strength fire (10 flame pixels or more), by distance and tray diameter.
YOLO 0.28: vision/detector.py at its own threshold. YOLO 0.5: only boxes that aim/ uses (min_conf 0.5).
Baseline: sim/sim2sim/baseline_detector.py. Overlap: any overlap with the true flame box (campaign rule). IoU: 0.25 or more.

| Flames | Tray (cm) | Distance (m) | Images | True box width (px) | YOLO 0.28, overlap | YOLO 0.28, IoU 0.25 | YOLO 0.5, overlap | Baseline, overlap |
|---|---|---|---|---|---|---|---|---|
| procedural | 10 | 1.0 | 40 | 54 | 72 % | 72 % | 38 % | 100 % |
| procedural | 10 | 1.5 | 40 | 37 | 70 % | 70 % | 32 % | 100 % |
| procedural | 10 | 2.0 | 40 | 29 | 78 % | 78 % | 40 % | 100 % |
| procedural | 10 | 2.5 | 40 | 22 | 85 % | 85 % | 62 % | 100 % |
| procedural | 10 | 3.0 | 40 | 20 | 85 % | 72 % | 48 % | 100 % |
| procedural | 10 | 3.5 | 35 | 17 | 74 % | 69 % | 37 % | 100 % |
| procedural | 10 | 4.0 | 35 | 13 | 66 % | 63 % | 31 % | 100 % |
| procedural | 10 | 4.5 | 33 | 10 | 70 % | 70 % | 21 % | 88 % |
| procedural | 10 | 5.0 | 35 | 10 | 34 % | 29 % | 0 % | 77 % |
| procedural | 15 | 1.0 | 40 | 85 | 68 % | 68 % | 48 % | 100 % |
| procedural | 15 | 1.5 | 40 | 58 | 72 % | 72 % | 57 % | 100 % |
| procedural | 15 | 2.0 | 40 | 44 | 88 % | 88 % | 65 % | 100 % |
| procedural | 15 | 2.5 | 40 | 35 | 80 % | 80 % | 60 % | 100 % |
| procedural | 15 | 3.0 | 40 | 27 | 90 % | 88 % | 68 % | 100 % |
| procedural | 15 | 3.5 | 35 | 27 | 71 % | 71 % | 31 % | 100 % |
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

| Flames | YOLO 0.28 | YOLO 0.5 | Baseline |
|---|---|---|---|
| procedural | 0.000 | 0.000 | 0.627 |
| real | 0.000 | 0.000 | 0.628 |

By real clip (phase % 5). Procedural: the same scenes, trays and placements with the procedural flames:

| Real clip | Images | YOLO 0.28, real | YOLO 0.28, procedural | YOLO 0.5, real | Baseline, real | Baseline, procedural |
|---|---|---|---|---|---|---|
| basket | 305 | 80 % | 73 % | 58 % | 100 % | 100 % |
| campfire_a | 310 | 72 % | 81 % | 53 % | 86 % | 100 % |
| campfire_b | 265 | 88 % | 79 % | 67 % | 65 % | 98 % |
| free_flame | 265 | 48 % | 74 % | 28 % | 97 % | 98 % |
| wood_fire | 255 | 95 % | 93 % | 76 % | 100 % | 100 % |

Images: 2840 (2798 with a visible flame). Hidden flames (furniture between) are not in the rates.
