promaaa/firefighter-robot/sim/water/results/curves_DWP-385.png

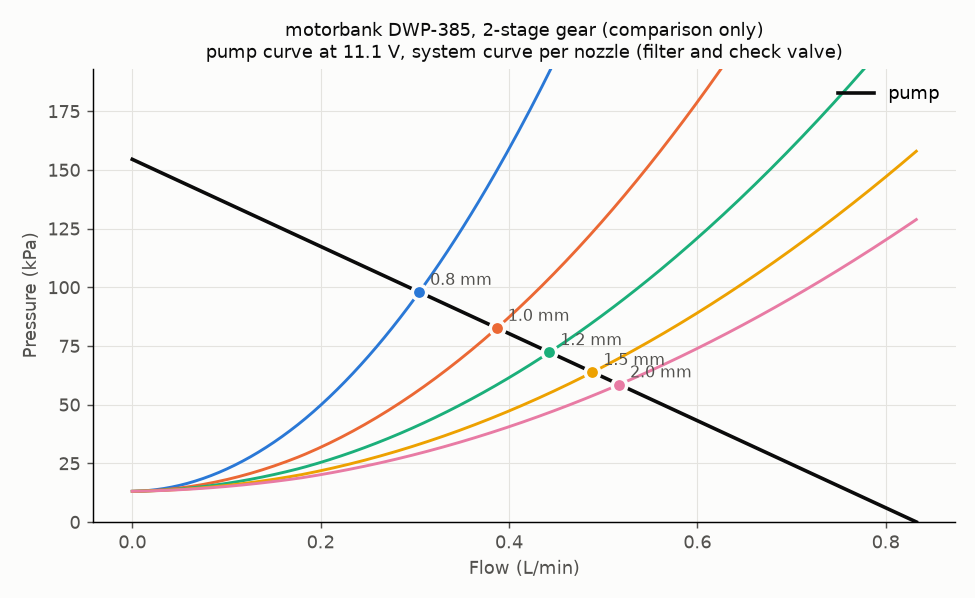
sim/water/results/curves_DWP-385.png
