promaaa/firefighter-robot/sim/water/results/ranges.png

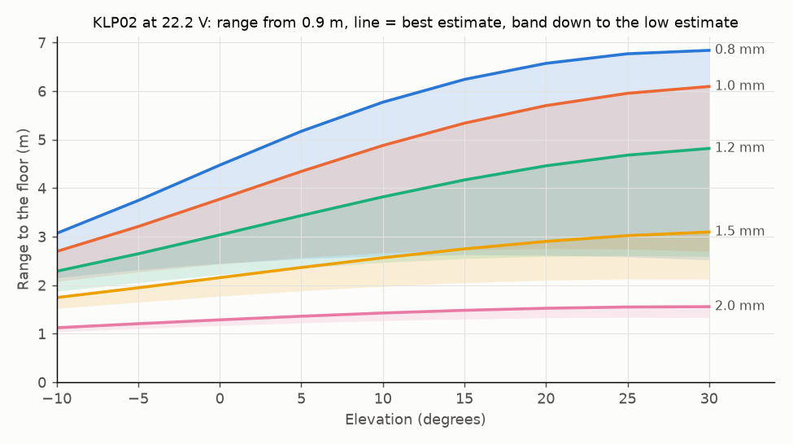
sim/water/results/ranges.png
