promaaa/firefighter-robot/vision/results/b0201_first_image.png

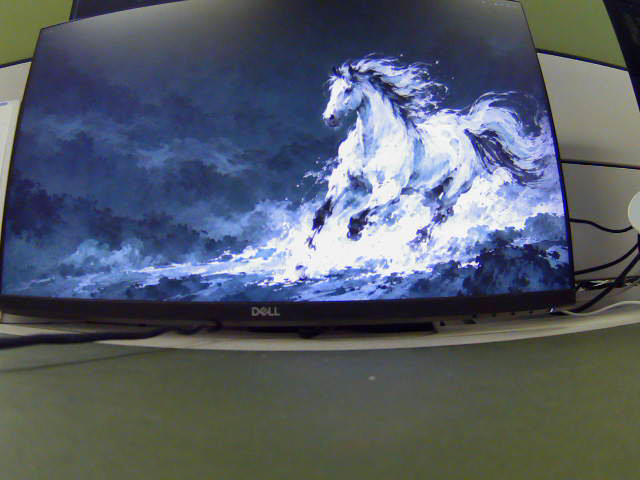
vision/results/b0201_first_image.png
