promaaa/firefighter-robot/vision/results/calib_640x480.jpg

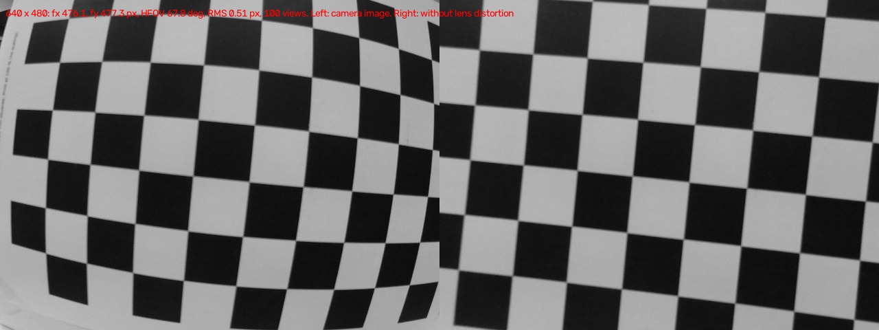
vision/results/calib_640x480.jpg
