promaaa/firefighter-robot/vision/results/calib_1920x1080.jpg

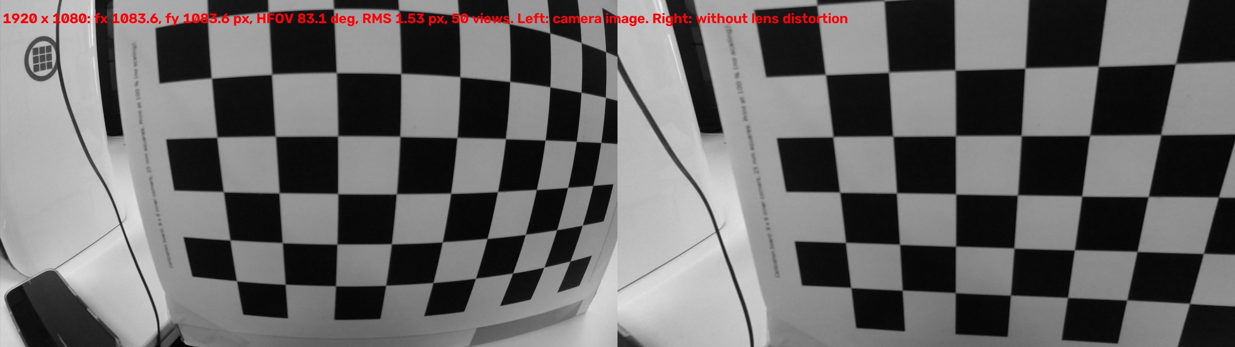
vision/results/calib_1920x1080.jpg
