promaaa/firefighter-robot/vision/results/p2bench/pr_and_size.png

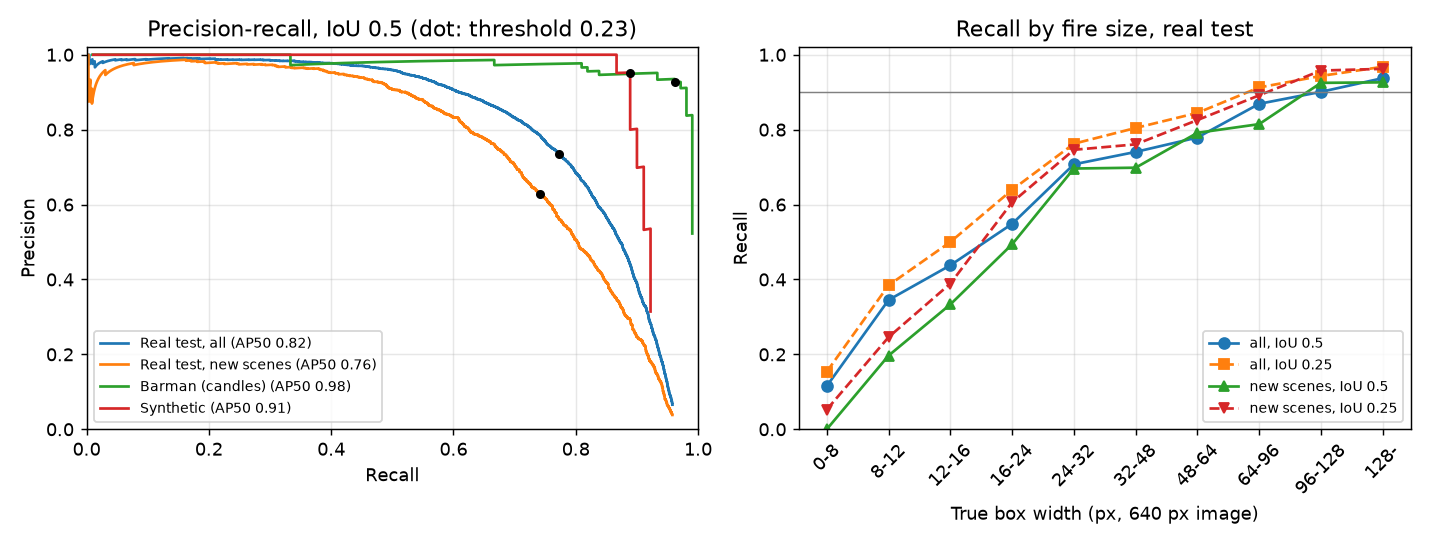
vision/results/p2bench/pr_and_size.png
