promaaa/firefighter-robot/vision/results/training_curves.png

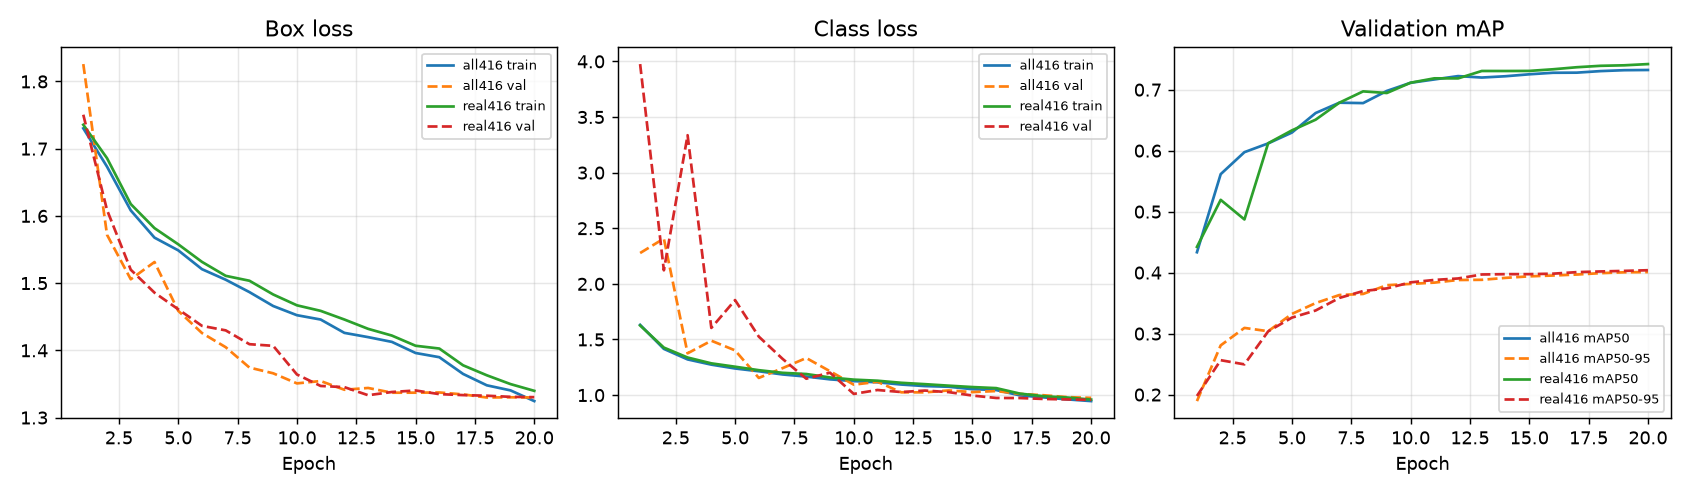
vision/results/training_curves.png
