promaaa/firefighter-robot/vision/results/video_timeline.png

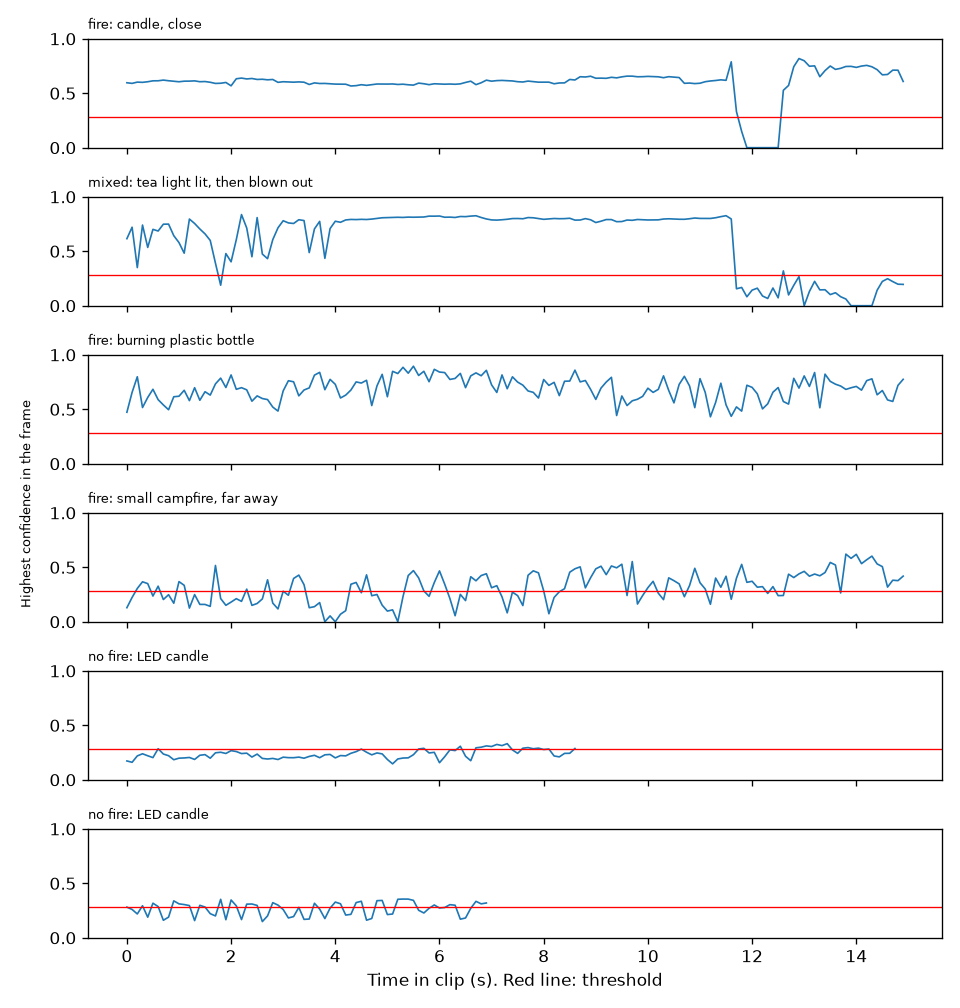
vision/results/video_timeline.png
