promaaa/firefighter-robot/docs/hardware/schematic/SOB-E_schematic.pdf

## MOTOR POWER · 2 × 6S LiPo, 22.2 V nominal, 25.2 V full

–

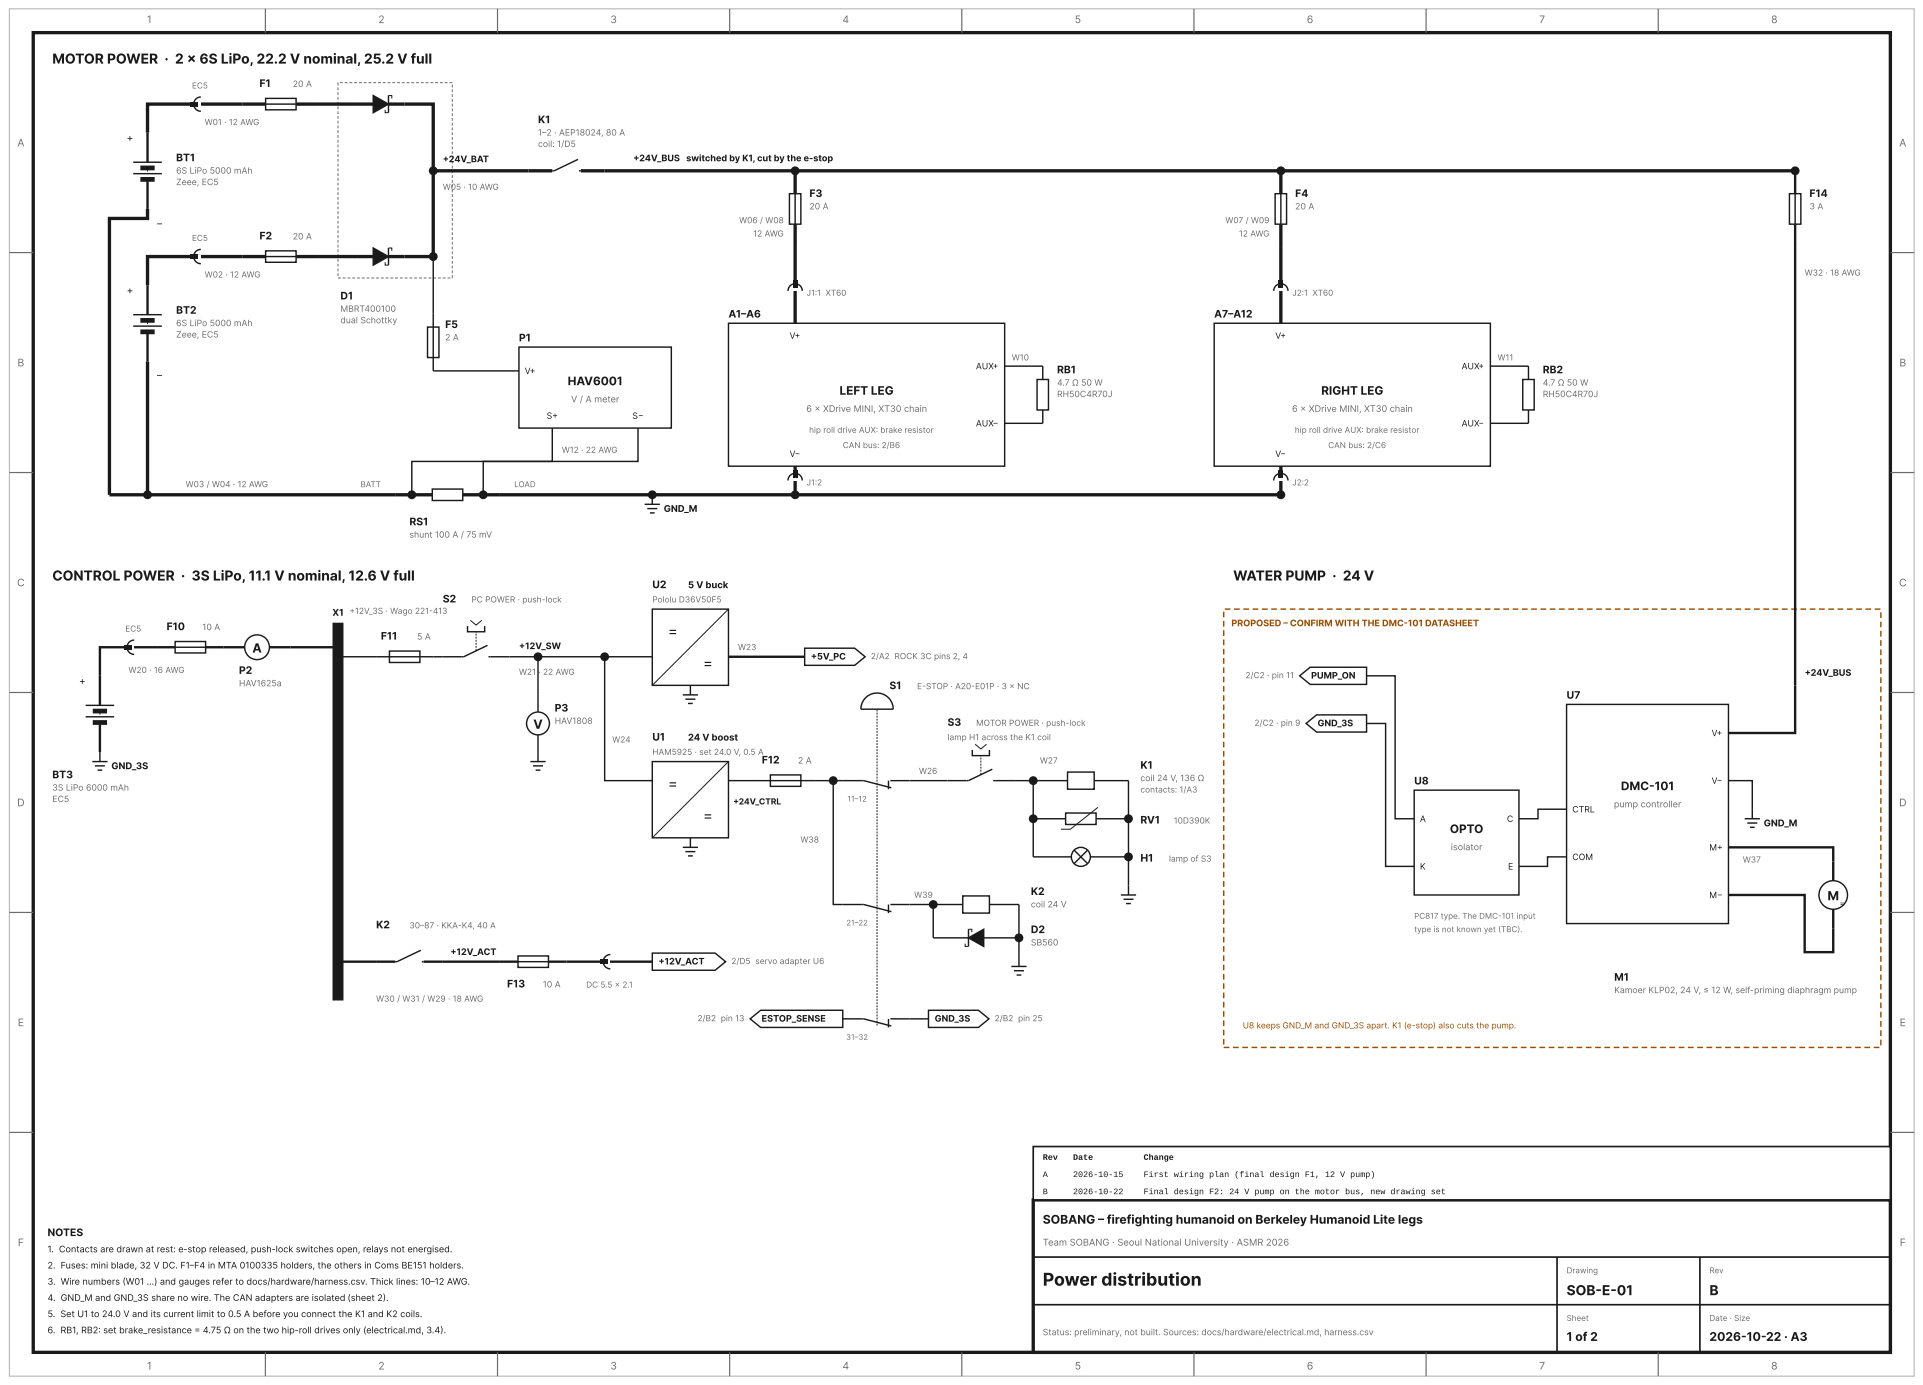
[picture p78: page 1]

+24V_BUS switched by K1, cut by the e-stop

hip roll drive AUX: brake resistor

CONTROL POWER · 3S LiPo, 11.1 V nominal, 12.6 V full

PROPOSED – CONFIRM WITH THE DMC-101 DATASHEET

lamp H1 across the K1 coil

PC817 type. The DMC-101 input
type is not known yet (TBC).

Kamoer KLP02, 24 V, ≤ 12 W, self-priming diaphragm pump

U8 keeps GND_M and GND_3S apart. K1 (e-stop) also cuts the pump.

SOBANG – firefighting humanoid on Berkeley Humanoid Lite legs

Team SOBANG · Seoul National University · ASMR 2026

1. Contacts are drawn at rest: e-stop released, push-lock switches open, relays not energised.

2. Fuses: mini blade, 32 V DC. F1–F4 in MTA 0100335 holders, the others in Coms BE151 holders.

3. Wire numbers (W01 …) and gauges refer to docs/hardware/harness.csv. Thick lines: 10–12 AWG.

4. GND_M and GND_3S share no wire. The CAN adapters are isolated (sheet 2).

5. Set U1 to 24.0 V and its current limit to 0.5 A before you connect the K1 and K2 coils.
6. RB1, RB2: set brake_resistance = 4.75 Ω on the two hip-roll drives only (electrical.md, 3.4).

Status: preliminary, not built. Sources: docs/hardware/electrical.md, harness.csv

## ROBOT COMPUTER, CAN BUSES, SENSORS AND PAN-TILT

U3

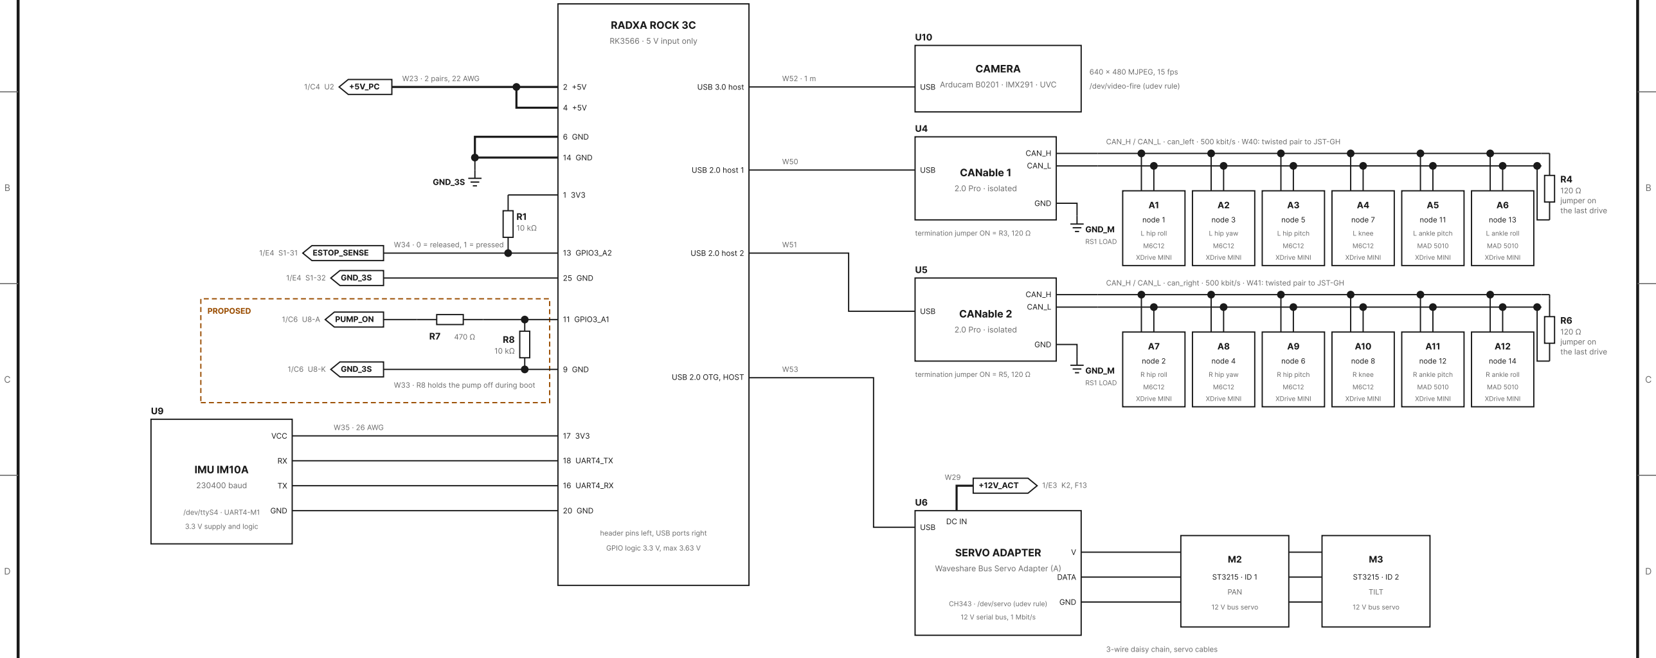
[picture p79: figure]
RADXA ROCK 3C; RK3566 · 5 V input only; 6 GND; 14 GND; 13 GPIO3_A2; 25 GND; 11 GPIO3_A1; 9 GND; 18 UART4_TX; 16 UART4_RX; 20 GND; USB 3.0 host; USB 2.0 host 1; USB 2.0 host 2; USB 2.0 OTG, HOST; header pins left, USB ports right; GPIO logic 3.3 V, max 3.63 V; W23 · 2 pairs, 22 AWG; GND_3S; ESTOP_SENSE; W34 · 0 = released, 1 = pressed; PUMP_ON; W33 · R8 holds the pump off during boot; PROPOSED; IMU IM10A; 230400 baud; VCC; /dev/ttyS4 · UART4-M1; GND; 3.3 V supply and logic; W35 · 26 AWG; CAMERA; Arducam B0201 · IMX291 · UVC; USB; 640 × 480 MJPEG, 15 fps; /dev/video-fire (udev rule); CANable 1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

CAN_H / CAN_L · can_left · 500 kbit/s · W40: twisted pair to JST-GH

CAN_H / CAN_L · can_right · 500 kbit/s · W41: twisted pair to JST-GH

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
A | A
E | E
F | F

## SOBANG – firefighting humanoid on Berkeley Humanoid Lite legs

Team SOBANG · Seoul National University · ASMR 2026

# Control and communication

Status: preliminary, not built. Sources: docs/hardware/electrical.md, harness.csv

Drawing

## SOB-E-02

Rev
B

Sheet

## 2 of 2

Date · Size
2026-10-22 · A3
Rev | Date | Change
A | 2026-10-15 | First wiring plan (final design F1, 12 V pump)
B | 2026-10-22 | Final design F2: 24 V pump on the motor bus, new drawing set

### NOTES

1. Node ids follow legs/robot.py (JOINTS, BHL numbering). If the drives get other ids, change that table.
2. The order of the drives along each chain is not fixed. Terminate only the last drive of each chain.
3. Each CANable joins its CAN GND to GND_M at the RS1 LOAD bolt only (W40, W41).
4. Do not plug a USB-C supply into the ROCK 3C while the header gives 5 V: both feed the same rail.
5. Do not use header pins 8 and 10: they carry the boot console. Enable UART4-M1 with rsetup.
6. gpiochip numbers are not verified: check GPIO3_A1 and GPIO3_A2 with gpiodetect on the board.
