promaaa/firefighter-robot/policies/act_gain125/params/env.yaml

viewer:
  eye: !!python/tuple
  - 7.5
  - 7.5
  - 7.5
  lookat: !!python/tuple
  - 0.0
  - 0.0
  - 0.0
  cam_prim_path: /OmniverseKit_Persp
  resolution: !!python/tuple
  - 1280
  - 720
  origin_type: world
  env_index: 0
  asset_name: null
  body_name: null
sim:
  physics_prim_path: /physicsScene
  device: cuda:0
  dt: 0.005
  render_interval: 4
  gravity: !!python/tuple
  - 0.0
  - 0.0
  - -9.81
  enable_scene_query_support: false
  use_fabric: true
  physx:
    solver_type: 1
    min_position_iteration_count: 1
    max_position_iteration_count: 255
    min_velocity_iteration_count: 0
    max_velocity_iteration_count: 255
    enable_ccd: false
    enable_stabilization: true
    enable_enhanced_determinism: false
    bounce_threshold_velocity: 0.5
    friction_offset_threshold: 0.04
    friction_correlation_distance: 0.025
    gpu_max_rigid_contact_count: 8388608
    gpu_max_rigid_patch_count: 327680
    gpu_found_lost_pairs_capacity: 2097152
    gpu_found_lost_aggregate_pairs_capacity: 33554432
    gpu_total_aggregate_pairs_capacity: 2097152
    gpu_collision_stack_size: 67108864
    gpu_heap_capacity: 67108864
    gpu_temp_buffer_capacity: 16777216
    gpu_max_num_partitions: 8
    gpu_max_soft_body_contacts: 1048576
    gpu_max_particle_contacts: 1048576
  physics_material:
    func: isaaclab.sim.spawners.materials.physics_materials:spawn_rigid_body_material
    static_friction: 1.0
    dynamic_friction: 1.0
    restitution: 0.0
    improve_patch_friction: true
    friction_combine_mode: multiply
    restitution_combine_mode: multiply
    compliant_contact_stiffness: 0.0
    compliant_contact_damping: 0.0
  render:
    enable_translucency: null
    enable_reflections: null
    enable_global_illumination: null
    antialiasing_mode: null
    enable_dlssg: null
    enable_dl_denoiser: null
    dlss_mode: null
    enable_direct_lighting: null
    samples_per_pixel: null
    enable_shadows: null
    enable_ambient_occlusion: null
    carb_settings: null
    rendering_mode: null
  disable_contact_processing: true
ui_window_class_type: isaaclab.envs.ui.manager_based_rl_env_window:ManagerBasedRLEnvWindow
seed: 42
decimation: 8
scene:
  num_envs: 4096
  env_spacing: 2.5
  lazy_sensor_update: true
  replicate_physics: true
  filter_collisions: true
  robot:
    class_type: isaaclab.assets.articulation.articulation:Articulation
    prim_path: /World/envs/env_.*/robot
    spawn:
      func: isaaclab.sim.spawners.from_files.from_files:spawn_from_usd
      visible: true
      semantic_tags: null
      copy_from_source: true
      mass_props: null
      deformable_props: null
      rigid_props:
        rigid_body_enabled: null
        kinematic_enabled: null
        disable_gravity: false
        linear_damping: 0.0
        angular_damping: 0.0
        max_linear_velocity: 1000.0
        max_angular_velocity: 1000.0
        max_depenetration_velocity: 1.0
        max_contact_impulse: null
        enable_gyroscopic_forces: null
        retain_accelerations: false
        solver_position_iteration_count: null
        solver_velocity_iteration_count: null
        sleep_threshold: null
        stabilization_threshold: null
      collision_props: null
      activate_contact_sensors: true
      scale: null
      articulation_props:
        articulation_enabled: null
        enabled_self_collisions: false
        solver_position_iteration_count: 8
        solver_velocity_iteration_count: 4
        sleep_threshold: null
        stabilization_threshold: null
        fix_root_link: null
      fixed_tendons_props: null
      joint_drive_props: null
      visual_material_path: material
      visual_material: null
      usd_path: /home/young/ASMR/source/berkeley_humanoid_lite_assets/data/robots/asmr2026/asmr2026_humanoid_v1/usd/asmr2026_humanoid.usd
      variants: null
    init_state:
      pos: !!python/tuple
      - 0.0
      - 0.0
      - -0.03977653
      rot: !!python/tuple
      - 1.0
      - 0.0
      - 0.0
      - 0.0
      lin_vel: !!python/tuple
      - 0.0
      - 0.0
      - 0.0
      ang_vel: !!python/tuple
      - 0.0
      - 0.0
      - 0.0
      joint_pos:
        leg_left_hip_roll_joint: 0.0
        leg_left_hip_yaw_joint: 0.0
        leg_left_hip_pitch_joint: 0.58519126
        leg_left_knee_pitch_joint: -0.95241361
        leg_left_ankle_pitch_joint: 0.36722235
        leg_left_ankle_roll_joint: 0.0
        leg_right_hip_roll_joint: 0.0
        leg_right_hip_yaw_joint: 0.0
        leg_right_hip_pitch_joint: -0.58519126
        leg_right_knee_pitch_joint: 0.95241361
        leg_right_ankle_pitch_joint: -0.36722235
        leg_right_ankle_roll_joint: 0.0
      joint_vel:
        .*: 0.0
    collision_group: 0
    debug_vis: false
    soft_joint_pos_limit_factor: 0.9
    actuators:
      legs:
        class_type: berkeley_humanoid_lite_assets.robots.asmr2026_humanoid:FrictionImplicitActuator
        joint_names_expr:
        - leg_.*_hip_roll_joint
        - leg_.*_hip_yaw_joint
        - leg_.*_hip_pitch_joint
        - leg_.*_knee_pitch_joint
        effort_limit: null
        velocity_limit: null
        effort_limit_sim: 18.09
        velocity_limit_sim: 20.943951023931955
        stiffness: 90.01079213793496
        damping: 5.730265000147783
        armature: 0.0228
        friction: 0.0
        coulomb_friction: 0.377
        viscous_friction: 0.09
        friction_smoothing_velocity: 0.1
      ankles:
        class_type: berkeley_humanoid_lite_assets.robots.asmr2026_humanoid:FrictionImplicitActuator
        joint_names_expr:
        - leg_.*_ankle_pitch_joint
        - leg_.*_ankle_roll_joint
        effort_limit: null
        velocity_limit: null
        effort_limit_sim: 22.572
        velocity_limit_sim: 20.943951023931955
        stiffness: 21.95000018802273
        damping: 0.4890831443108589
        armature: 0.00556
        friction: 0.0
        coulomb_friction: 0.317
        viscous_friction: 0.03
        friction_smoothing_velocity: 0.3
  terrain:
    class_type: isaaclab.terrains.terrain_importer:TerrainImporter
    collision_group: -1
    prim_path: /World/ground
    num_envs: 4096
    terrain_type: plane
    terrain_generator: null
    usd_path: null
    env_spacing: 2.5
    visual_material:
      func: isaaclab.sim.spawners.materials.visual_materials:spawn_from_mdl_file
      mdl_path: '{NVIDIA_NUCLEUS_DIR}/Materials/Base/Architecture/Shingles_01.mdl'
      project_uvw: true
      albedo_brightness: null
      texture_scale: null
    physics_material:
      func: isaaclab.sim.spawners.materials.physics_materials:spawn_rigid_body_material
      static_friction: 1.0
      dynamic_friction: 1.0
      restitution: 0.0
      improve_patch_friction: true
      friction_combine_mode: multiply
      restitution_combine_mode: multiply
      compliant_contact_stiffness: 0.0
      compliant_contact_damping: 0.0
    max_init_terrain_level: 5
    debug_vis: false
  contact_forces:
    class_type: isaaclab.sensors.contact_sensor.contact_sensor:ContactSensor
    prim_path: /World/envs/env_.*/robot/.*
    update_period: 0.005
    history_length: 3
    debug_vis: false
    track_pose: false
    track_air_time: true
    force_threshold: 1.0
    filter_prim_paths_expr: []
    visualizer_cfg:
      prim_path: /Visuals/ContactSensor
      markers:
        contact:
          func: isaaclab.sim.spawners.shapes.shapes:spawn_sphere
          visible: true
          semantic_tags: null
          copy_from_source: true
          mass_props: null
          rigid_props: null
          collision_props: null
          activate_contact_sensors: false
          visual_material_path: material
          visual_material:
            func: isaaclab.sim.spawners.materials.visual_materials:spawn_preview_surface
            diffuse_color: !!python/tuple
            - 1.0
            - 0.0
            - 0.0
            emissive_color: !!python/tuple
            - 0.0
            - 0.0
            - 0.0
            roughness: 0.5
            metallic: 0.0
            opacity: 1.0
          physics_material_path: material
          physics_material: null
          radius: 0.02
        no_contact:
          func: isaaclab.sim.spawners.shapes.shapes:spawn_sphere
          visible: false
          semantic_tags: null
          copy_from_source: true
          mass_props: null
          rigid_props: null
          collision_props: null
          activate_contact_sensors: false
          visual_material_path: material
          visual_material:
            func: isaaclab.sim.spawners.materials.visual_materials:spawn_preview_surface
            diffuse_color: !!python/tuple
            - 0.0
            - 1.0
            - 0.0
            emissive_color: !!python/tuple
            - 0.0
            - 0.0
            - 0.0
            roughness: 0.5
            metallic: 0.0
            opacity: 1.0
          physics_material_path: material
          physics_material: null
          radius: 0.02
  light:
    class_type: null
    prim_path: /World/light
    spawn:
      func: isaaclab.sim.spawners.lights.lights:spawn_light
      visible: true
      semantic_tags: null
      copy_from_source: true
      prim_type: DistantLight
      color: !!python/tuple
      - 0.75
      - 0.75
      - 0.75
      enable_color_temperature: false
      color_temperature: 6500.0
      normalize: false
      exposure: 0.0
      intensity: 3000.0
      angle: 0.53
    init_state:
      pos: !!python/tuple
      - 0.0
      - 0.0
      - 0.0
      rot: !!python/tuple
      - 1.0
      - 0.0
      - 0.0
      - 0.0
    collision_group: 0
    debug_vis: false
  sky_light:
    class_type: null
    prim_path: /World/skyLight
    spawn:
      func: isaaclab.sim.spawners.lights.lights:spawn_light
      visible: true
      semantic_tags: null
      copy_from_source: true
      prim_type: DomeLight
      color: !!python/tuple
      - 0.13
      - 0.13
      - 0.13
      enable_color_temperature: false
      color_temperature: 6500.0
      normalize: false
      exposure: 0.0
      intensity: 1000.0
      texture_file: null
      texture_format: automatic
      visible_in_primary_ray: true
    init_state:
      pos: !!python/tuple
      - 0.0
      - 0.0
      - 0.0
      rot: !!python/tuple
      - 1.0
      - 0.0
      - 0.0
      - 0.0
    collision_group: 0
    debug_vis: false
recorders:
  dataset_file_handler_class_type: isaaclab.utils.datasets.hdf5_dataset_file_handler:HDF5DatasetFileHandler
  dataset_export_dir_path: /tmp/isaaclab/logs
  dataset_filename: dataset
  dataset_export_mode:
    _value_: 1
    _name_: EXPORT_ALL
  export_in_record_pre_reset: true
observations:
  policy:
    concatenate_terms: true
    enable_corruption: true
    history_length: null
    flatten_history_dim: true
    velocity_commands:
      func: isaaclab.envs.mdp.observations:generated_commands
      params:
        command_name: base_velocity
      modifiers: null
      noise: null
      clip: null
      scale: null
      history_length: 0
      flatten_history_dim: true
    base_ang_vel:
      func: isaaclab.envs.mdp.observations:base_ang_vel
      params: {}
      modifiers: null
      noise:
        func: isaaclab.utils.noise.noise_model:uniform_noise
        operation: add
        n_min: -0.3
        n_max: 0.3
      clip: null
      scale: null
      history_length: 0
      flatten_history_dim: true
    projected_gravity:
      func: isaaclab.envs.mdp.observations:projected_gravity
      params: {}
      modifiers: null
      noise:
        func: isaaclab.utils.noise.noise_model:uniform_noise
        operation: add
        n_min: -0.05
        n_max: 0.05
      clip: null
      scale: null
      history_length: 0
      flatten_history_dim: true
    joint_pos:
      func: isaaclab.envs.mdp.observations:joint_pos_rel
      params:
        asset_cfg:
          name: robot
          joint_names:
          - leg_left_hip_roll_joint
          - leg_left_hip_yaw_joint
          - leg_left_hip_pitch_joint
          - leg_left_knee_pitch_joint
          - leg_left_ankle_pitch_joint
          - leg_left_ankle_roll_joint
          - leg_right_hip_roll_joint
          - leg_right_hip_yaw_joint
          - leg_right_hip_pitch_joint
          - leg_right_knee_pitch_joint
          - leg_right_ankle_pitch_joint
          - leg_right_ankle_roll_joint
          joint_ids: !!python/object/apply:builtins.slice
          - null
          - null
          - null
          fixed_tendon_names: null
          fixed_tendon_ids: !!python/object/apply:builtins.slice
          - null
          - null
          - null
          body_names: null
          body_ids: !!python/object/apply:builtins.slice
          - null
          - null
          - null
          object_collection_names: null
          object_collection_ids: !!python/object/apply:builtins.slice
          - null
          - null
          - null
          preserve_order: true
      modifiers: null
      noise:
        func: isaaclab.utils.noise.noise_model:uniform_noise
        operation: add
        n_min: -0.05
        n_max: 0.05
      clip: null
      scale: null
      history_length: 0
      flatten_history_dim: true
    joint_vel:
      func: isaaclab.envs.mdp.observations:joint_vel_rel
      params:
        asset_cfg:
          name: robot
          joint_names:
          - leg_left_hip_roll_joint
          - leg_left_hip_yaw_joint
          - leg_left_hip_pitch_joint
          - leg_left_knee_pitch_joint
          - leg_left_ankle_pitch_joint
          - leg_left_ankle_roll_joint
          - leg_right_hip_roll_joint
          - leg_right_hip_yaw_joint
          - leg_right_hip_pitch_joint
          - leg_right_knee_pitch_joint
          - leg_right_ankle_pitch_joint
          - leg_right_ankle_roll_joint
          joint_ids: !!python/object/apply:builtins.slice
          - null
          - null
          - null
          fixed_tendon_names: null
          fixed_tendon_ids: !!python/object/apply:builtins.slice
          - null
          - null
          - null
          body_names: null
          body_ids: !!python/object/apply:builtins.slice
          - null
          - null
          - null
          object_collection_names: null
          object_collection_ids: !!python/object/apply:builtins.slice
          - null
          - null
          - null
          preserve_order: true
      modifiers: null
      noise:
        func: isaaclab.utils.noise.noise_model:uniform_noise
        operation: add
        n_min: -2.0
        n_max: 2.0
      clip: null
      scale: null
      history_length: 0
      flatten_history_dim: true
    actions:
      func: isaaclab.envs.mdp.observations:last_action
      params: {}
      modifiers: null
      noise: null
      clip: null
      scale: null
      history_length: 0
      flatten_history_dim: true
  critic:
    concatenate_terms: true
    enable_corruption: false
    history_length: null
    flatten_history_dim: true
    velocity_commands:
      func: isaaclab.envs.mdp.observations:generated_commands
      params:
        command_name: base_velocity
      modifiers: null
      noise: null
      clip: null
      scale: null
      history_length: 0
      flatten_history_dim: true
    base_ang_vel:
      func: isaaclab.envs.mdp.observations:base_ang_vel
      params: {}
      modifiers: null
      noise:
        func: isaaclab.utils.noise.noise_model:uniform_noise
        operation: add
        n_min: -0.3
        n_max: 0.3
      clip: null
      scale: null
      history_length: 0
      flatten_history_dim: true
    projected_gravity:
      func: isaaclab.envs.mdp.observations:projected_gravity
      params: {}
      modifiers: null
      noise:
        func: isaaclab.utils.noise.noise_model:uniform_noise
        operation: add
        n_min: -0.05
        n_max: 0.05
      clip: null
      scale: null
      history_length: 0
      flatten_history_dim: true
    joint_pos:
      func: isaaclab.envs.mdp.observations:joint_pos_rel
      params:
        asset_cfg:
          name: robot
          joint_names:
          - leg_left_hip_roll_joint
          - leg_left_hip_yaw_joint
          - leg_left_hip_pitch_joint
          - leg_left_knee_pitch_joint
          - leg_left_ankle_pitch_joint
          - leg_left_ankle_roll_joint
          - leg_right_hip_roll_joint
          - leg_right_hip_yaw_joint
          - leg_right_hip_pitch_joint
          - leg_right_knee_pitch_joint
          - leg_right_ankle_pitch_joint
          - leg_right_ankle_roll_joint
          joint_ids: !!python/object/apply:builtins.slice
          - null
          - null
          - null
          fixed_tendon_names: null
          fixed_tendon_ids: !!python/object/apply:builtins.slice
          - null
          - null
          - null
          body_names: null
          body_ids: !!python/object/apply:builtins.slice
          - null
          - null
          - null
          object_collection_names: null
          object_collection_ids: !!python/object/apply:builtins.slice
          - null
          - null
          - null
          preserve_order: true
      modifiers: null
      noise:
        func: isaaclab.utils.noise.noise_model:uniform_noise
        operation: add
        n_min: -0.05
        n_max: 0.05
      clip: null
      scale: null
      history_length: 0
      flatten_history_dim: true
    joint_vel:
      func: isaaclab.envs.mdp.observations:joint_vel_rel
      params:
        asset_cfg:
          name: robot
          joint_names:
          - leg_left_hip_roll_joint
          - leg_left_hip_yaw_joint
          - leg_left_hip_pitch_joint
          - leg_left_knee_pitch_joint
          - leg_left_ankle_pitch_joint
          - leg_left_ankle_roll_joint
          - leg_right_hip_roll_joint
          - leg_right_hip_yaw_joint
          - leg_right_hip_pitch_joint
          - leg_right_knee_pitch_joint
          - leg_right_ankle_pitch_joint
          - leg_right_ankle_roll_joint
          joint_ids: !!python/object/apply:builtins.slice
          - null
          - null
          - null
          fixed_tendon_names: null
          fixed_tendon_ids: !!python/object/apply:builtins.slice
          - null
          - null
          - null
          body_names: null
          body_ids: !!python/object/apply:builtins.slice
          - null
          - null
          - null
          object_collection_names: null
          object_collection_ids: !!python/object/apply:builtins.slice
          - null
          - null
          - null
          preserve_order: true
      modifiers: null
      noise:
        func: isaaclab.utils.noise.noise_model:uniform_noise
        operation: add
        n_min: -2.0
        n_max: 2.0
      clip: null
      scale: null
      history_length: 0
      flatten_history_dim: true
    actions:
      func: isaaclab.envs.mdp.observations:last_action
      params: {}
      modifiers: null
      noise: null
      clip: null
      scale: null
      history_length: 0
      flatten_history_dim: true
    base_lin_vel:
      func: isaaclab.envs.mdp.observations:base_lin_vel
      params: {}
      modifiers: null
      noise: null
      clip: null
      scale: null
      history_length: 0
      flatten_history_dim: true
actions:
  joint_pos:
    class_type: isaaclab.envs.mdp.actions.joint_actions:JointPositionAction
    asset_name: robot
    debug_vis: false
    clip: null
    joint_names:
    - leg_left_hip_roll_joint
    - leg_left_hip_yaw_joint
    - leg_left_hip_pitch_joint
    - leg_left_knee_pitch_joint
    - leg_left_ankle_pitch_joint
    - leg_left_ankle_roll_joint
    - leg_right_hip_roll_joint
    - leg_right_hip_yaw_joint
    - leg_right_hip_pitch_joint
    - leg_right_knee_pitch_joint
    - leg_right_ankle_pitch_joint
    - leg_right_ankle_roll_joint
    scale: 0.25
    offset: 0.0
    preserve_order: true
    use_default_offset: true
events:
  physics_material:
    func: isaaclab.envs.mdp.events:randomize_rigid_body_material
    params:
      asset_cfg:
        name: robot
        joint_names: null
        joint_ids: !!python/object/apply:builtins.slice
        - null
        - null
        - null
        fixed_tendon_names: null
        fixed_tendon_ids: !!python/object/apply:builtins.slice
        - null
        - null
        - null
        body_names: .*
        body_ids: !!python/object/apply:builtins.slice
        - null
        - null
        - null
        object_collection_names: null
        object_collection_ids: !!python/object/apply:builtins.slice
        - null
        - null
        - null
        preserve_order: false
      static_friction_range: !!python/tuple
      - 0.8
      - 0.8
      dynamic_friction_range: !!python/tuple
      - 0.8
      - 0.8
      restitution_range: !!python/tuple
      - 0.0
      - 0.0
      num_buckets: 64
    mode: startup
    interval_range_s: null
    is_global_time: false
    min_step_count_between_reset: 0
  add_base_mass:
    func: isaaclab.envs.mdp.events:randomize_rigid_body_mass
    params:
      asset_cfg:
        name: robot
        joint_names: null
        joint_ids: !!python/object/apply:builtins.slice
        - null
        - null
        - null
        fixed_tendon_names: null
        fixed_tendon_ids: !!python/object/apply:builtins.slice
        - null
        - null
        - null
        body_names: base
        body_ids: !!python/object/apply:builtins.slice
        - null
        - null
        - null
        object_collection_names: null
        object_collection_ids: !!python/object/apply:builtins.slice
        - null
        - null
        - null
        preserve_order: false
      mass_distribution_params: !!python/tuple
      - -0.0
      - 0.0
      operation: add
    mode: startup
    interval_range_s: null
    is_global_time: false
    min_step_count_between_reset: 0
  add_all_joint_default_pos: null
  scale_all_actuator_torque_constant:
    func: isaaclab.envs.mdp.events:randomize_actuator_gains
    params:
      asset_cfg:
        name: robot
        joint_names:
        - .*
        joint_ids: !!python/object/apply:builtins.slice
        - null
        - null
        - null
        fixed_tendon_names: null
        fixed_tendon_ids: !!python/object/apply:builtins.slice
        - null
        - null
        - null
        body_names: null
        body_ids: !!python/object/apply:builtins.slice
        - null
        - null
        - null
        object_collection_names: null
        object_collection_ids: !!python/object/apply:builtins.slice
        - null
        - null
        - null
        preserve_order: false
      stiffness_distribution_params: !!python/tuple
      - 0.8
      - 1.25
      damping_distribution_params: !!python/tuple
      - 0.8
      - 1.25
      operation: scale
      distribution: log_uniform
    mode: startup
    interval_range_s: null
    is_global_time: false
    min_step_count_between_reset: 0
  reset_base:
    func: isaaclab.envs.mdp.events:reset_root_state_uniform
    params:
      pose_range:
        x: !!python/tuple
        - -0.5
        - 0.5
        y: !!python/tuple
        - -0.5
        - 0.5
        yaw: !!python/tuple
        - -3.14
        - 3.14
      velocity_range:
        x: !!python/tuple
        - -0.5
        - 0.5
        y: !!python/tuple
        - -0.5
        - 0.5
        z: !!python/tuple
        - 0.0
        - 0.0
        roll: !!python/tuple
        - -0.5
        - 0.5
        pitch: !!python/tuple
        - -0.5
        - 0.5
        yaw: !!python/tuple
        - -0.5
        - 0.5
    mode: reset
    interval_range_s: null
    is_global_time: false
    min_step_count_between_reset: 0
  reset_robot_joints:
    func: isaaclab.envs.mdp.events:reset_joints_by_scale
    params:
      position_range: !!python/tuple
      - 0.5
      - 1.5
      velocity_range: !!python/tuple
      - 0.0
      - 0.0
    mode: reset
    interval_range_s: null
    is_global_time: false
    min_step_count_between_reset: 0
  base_external_force_torque:
    func: isaaclab.envs.mdp.events:apply_external_force_torque
    params:
      asset_cfg:
        name: robot
        joint_names: null
        joint_ids: !!python/object/apply:builtins.slice
        - null
        - null
        - null
        fixed_tendon_names: null
        fixed_tendon_ids: !!python/object/apply:builtins.slice
        - null
        - null
        - null
        body_names: base
        body_ids: !!python/object/apply:builtins.slice
        - null
        - null
        - null
        object_collection_names: null
        object_collection_ids: !!python/object/apply:builtins.slice
        - null
        - null
        - null
        preserve_order: false
      force_range: !!python/tuple
      - -2.0
      - 2.0
      torque_range: !!python/tuple
      - -2.0
      - 2.0
    mode: reset
    interval_range_s: null
    is_global_time: false
    min_step_count_between_reset: 0
  scale_leg_mass:
    func: isaaclab.envs.mdp.events:randomize_rigid_body_mass
    params:
      asset_cfg:
        name: robot
        joint_names: null
        joint_ids: !!python/object/apply:builtins.slice
        - null
        - null
        - null
        fixed_tendon_names: null
        fixed_tendon_ids: !!python/object/apply:builtins.slice
        - null
        - null
        - null
        body_names: leg_.*
        body_ids: !!python/object/apply:builtins.slice
        - null
        - null
        - null
        object_collection_names: null
        object_collection_ids: !!python/object/apply:builtins.slice
        - null
        - null
        - null
        preserve_order: false
      mass_distribution_params: !!python/tuple
      - 1.0
      - 1.0
      operation: scale
    mode: startup
    interval_range_s: null
    is_global_time: false
    min_step_count_between_reset: 0
  shift_torso_com:
    func: berkeley_humanoid_lite.tasks.locomotion.velocity.mdp.dynamics:randomize_body_com_offset
    params:
      asset_cfg:
        name: robot
        joint_names: null
        joint_ids: !!python/object/apply:builtins.slice
        - null
        - null
        - null
        fixed_tendon_names: null
        fixed_tendon_ids: !!python/object/apply:builtins.slice
        - null
        - null
        - null
        body_names: base
        body_ids: !!python/object/apply:builtins.slice
        - null
        - null
        - null
        object_collection_names: null
        object_collection_ids: !!python/object/apply:builtins.slice
        - null
        - null
        - null
        preserve_order: false
      x_range: !!python/tuple
      - -0.0
      - 0.0
      z_range: !!python/tuple
      - -0.0
      - 0.0
    mode: startup
    interval_range_s: null
    is_global_time: false
    min_step_count_between_reset: 0
  add_payload:
    func: berkeley_humanoid_lite.tasks.locomotion.velocity.mdp.dynamics:add_body_payload
    params:
      asset_cfg:
        name: robot
        joint_names: null
        joint_ids: !!python/object/apply:builtins.slice
        - null
        - null
        - null
        fixed_tendon_names: null
        fixed_tendon_ids: !!python/object/apply:builtins.slice
        - null
        - null
        - null
        body_names: base
        body_ids: !!python/object/apply:builtins.slice
        - null
        - null
        - null
        object_collection_names: null
        object_collection_ids: !!python/object/apply:builtins.slice
        - null
        - null
        - null
        preserve_order: false
      mass: 1.0
      position: !!python/tuple
      - 0.0
      - 0.0
      - 0.8838
      size: !!python/tuple
      - 0.1
      - 0.1
      - 0.1
    mode: startup
    interval_range_s: null
    is_global_time: false
    min_step_count_between_reset: 0
rerender_on_reset: false
wait_for_textures: true
xr: null
is_finite_horizon: false
episode_length_s: 20.0
rewards:
  track_lin_vel_xy_exp:
    func: berkeley_humanoid_lite.tasks.locomotion.velocity.mdp.rewards:track_lin_vel_xy_yaw_frame_exp
    params:
      command_name: base_velocity
      std: 0.25
    weight: 2.0
  track_ang_vel_z_exp:
    func: berkeley_humanoid_lite.tasks.locomotion.velocity.mdp.rewards:track_ang_vel_z_world_exp
    params:
      command_name: base_velocity
      std: 0.25
    weight: 1.0
  termination_penalty:
    func: isaaclab.envs.mdp.rewards:is_terminated
    params: {}
    weight: -10.0
  lin_vel_z_l2:
    func: isaaclab.envs.mdp.rewards:lin_vel_z_l2
    params: {}
    weight: -0.1
  ang_vel_xy_l2:
    func: isaaclab.envs.mdp.rewards:ang_vel_xy_l2
    params: {}
    weight: -0.05
  flat_orientation_l2:
    func: isaaclab.envs.mdp.rewards:flat_orientation_l2
    params: {}
    weight: -2.0
  action_rate_l2:
    func: isaaclab.envs.mdp.rewards:action_rate_l2
    params: {}
    weight: -0.01
  dof_torques_l2:
    func: isaaclab.envs.mdp.rewards:joint_torques_l2
    params:
      asset_cfg:
        name: robot
        joint_names:
        - leg_left_hip_roll_joint
        - leg_left_hip_yaw_joint
        - leg_left_hip_pitch_joint
        - leg_left_knee_pitch_joint
        - leg_left_ankle_pitch_joint
        - leg_left_ankle_roll_joint
        - leg_right_hip_roll_joint
        - leg_right_hip_yaw_joint
        - leg_right_hip_pitch_joint
        - leg_right_knee_pitch_joint
        - leg_right_ankle_pitch_joint
        - leg_right_ankle_roll_joint
        joint_ids: !!python/object/apply:builtins.slice
        - null
        - null
        - null
        fixed_tendon_names: null
        fixed_tendon_ids: !!python/object/apply:builtins.slice
        - null
        - null
        - null
        body_names: null
        body_ids: !!python/object/apply:builtins.slice
        - null
        - null
        - null
        object_collection_names: null
        object_collection_ids: !!python/object/apply:builtins.slice
        - null
        - null
        - null
        preserve_order: false
    weight: -0.002
  dof_acc_l2:
    func: isaaclab.envs.mdp.rewards:joint_acc_l2
    params:
      asset_cfg:
        name: robot
        joint_names:
        - leg_left_hip_roll_joint
        - leg_left_hip_yaw_joint
        - leg_left_hip_pitch_joint
        - leg_left_knee_pitch_joint
        - leg_left_ankle_pitch_joint
        - leg_left_ankle_roll_joint
        - leg_right_hip_roll_joint
        - leg_right_hip_yaw_joint
        - leg_right_hip_pitch_joint
        - leg_right_knee_pitch_joint
        - leg_right_ankle_pitch_joint
        - leg_right_ankle_roll_joint
        joint_ids: !!python/object/apply:builtins.slice
        - null
        - null
        - null
        fixed_tendon_names: null
        fixed_tendon_ids: !!python/object/apply:builtins.slice
        - null
        - null
        - null
        body_names: null
        body_ids: !!python/object/apply:builtins.slice
        - null
        - null
        - null
        object_collection_names: null
        object_collection_ids: !!python/object/apply:builtins.slice
        - null
        - null
        - null
        preserve_order: false
    weight: -1.0e-06
  dof_pos_limits:
    func: isaaclab.envs.mdp.rewards:joint_pos_limits
    params: {}
    weight: -1.0
  feet_air_time:
    func: berkeley_humanoid_lite.tasks.locomotion.velocity.mdp.rewards:feet_air_time_positive_biped
    params:
      command_name: base_velocity
      sensor_cfg:
        name: contact_forces
        joint_names: null
        joint_ids: !!python/object/apply:builtins.slice
        - null
        - null
        - null
        fixed_tendon_names: null
        fixed_tendon_ids: !!python/object/apply:builtins.slice
        - null
        - null
        - null
        body_names: .*_ankle_roll
        body_ids: !!python/object/apply:builtins.slice
        - null
        - null
        - null
        object_collection_names: null
        object_collection_ids: !!python/object/apply:builtins.slice
        - null
        - null
        - null
        preserve_order: false
      threshold: 0.4
    weight: 1.0
  feet_slide:
    func: berkeley_humanoid_lite.tasks.locomotion.velocity.mdp.rewards:feet_slide
    params:
      sensor_cfg:
        name: contact_forces
        joint_names: null
        joint_ids: !!python/object/apply:builtins.slice
        - null
        - null
        - null
        fixed_tendon_names: null
        fixed_tendon_ids: !!python/object/apply:builtins.slice
        - null
        - null
        - null
        body_names: .*_ankle_roll
        body_ids: !!python/object/apply:builtins.slice
        - null
        - null
        - null
        object_collection_names: null
        object_collection_ids: !!python/object/apply:builtins.slice
        - null
        - null
        - null
        preserve_order: false
      asset_cfg:
        name: robot
        joint_names: null
        joint_ids: !!python/object/apply:builtins.slice
        - null
        - null
        - null
        fixed_tendon_names: null
        fixed_tendon_ids: !!python/object/apply:builtins.slice
        - null
        - null
        - null
        body_names: .*_ankle_roll
        body_ids: !!python/object/apply:builtins.slice
        - null
        - null
        - null
        object_collection_names: null
        object_collection_ids: !!python/object/apply:builtins.slice
        - null
        - null
        - null
        preserve_order: false
    weight: -0.1
  undesired_contacts:
    func: isaaclab.envs.mdp.rewards:undesired_contacts
    params:
      sensor_cfg:
        name: contact_forces
        joint_names: null
        joint_ids: !!python/object/apply:builtins.slice
        - null
        - null
        - null
        fixed_tendon_names: null
        fixed_tendon_ids: !!python/object/apply:builtins.slice
        - null
        - null
        - null
        body_names:
        - base
        - .*_hip_.*
        - .*_knee_.*
        body_ids: !!python/object/apply:builtins.slice
        - null
        - null
        - null
        object_collection_names: null
        object_collection_ids: !!python/object/apply:builtins.slice
        - null
        - null
        - null
        preserve_order: false
      threshold: 1.0
    weight: -1.0
  joint_deviation_hip:
    func: isaaclab.envs.mdp.rewards:joint_deviation_l1
    params:
      asset_cfg:
        name: robot
        joint_names:
        - .*_hip_yaw_joint
        - .*_hip_roll_joint
        joint_ids: !!python/object/apply:builtins.slice
        - null
        - null
        - null
        fixed_tendon_names: null
        fixed_tendon_ids: !!python/object/apply:builtins.slice
        - null
        - null
        - null
        body_names: null
        body_ids: !!python/object/apply:builtins.slice
        - null
        - null
        - null
        object_collection_names: null
        object_collection_ids: !!python/object/apply:builtins.slice
        - null
        - null
        - null
        preserve_order: false
    weight: -0.2
  joint_deviation_ankle_roll:
    func: isaaclab.envs.mdp.rewards:joint_deviation_l1
    params:
      asset_cfg:
        name: robot
        joint_names:
        - .*_ankle_roll_joint
        joint_ids: !!python/object/apply:builtins.slice
        - null
        - null
        - null
        fixed_tendon_names: null
        fixed_tendon_ids: !!python/object/apply:builtins.slice
        - null
        - null
        - null
        body_names: null
        body_ids: !!python/object/apply:builtins.slice
        - null
        - null
        - null
        object_collection_names: null
        object_collection_ids: !!python/object/apply:builtins.slice
        - null
        - null
        - null
        preserve_order: false
    weight: -0.2
terminations:
  time_out:
    func: isaaclab.envs.mdp.terminations:time_out
    params: {}
    time_out: true
  base_orientation:
    func: isaaclab.envs.mdp.terminations:bad_orientation
    params:
      limit_angle: 0.78
      asset_cfg:
        name: robot
        joint_names: null
        joint_ids: !!python/object/apply:builtins.slice
        - null
        - null
        - null
        fixed_tendon_names: null
        fixed_tendon_ids: !!python/object/apply:builtins.slice
        - null
        - null
        - null
        body_names: base
        body_ids: !!python/object/apply:builtins.slice
        - null
        - null
        - null
        object_collection_names: null
        object_collection_ids: !!python/object/apply:builtins.slice
        - null
        - null
        - null
        preserve_order: false
    time_out: false
curriculum: null
commands:
  base_velocity:
    class_type: isaaclab.envs.mdp.commands.velocity_command:UniformVelocityCommand
    resampling_time_range: !!python/tuple
    - 10.0
    - 10.0
    debug_vis: true
    asset_name: robot
    heading_command: true
    heading_control_stiffness: 0.5
    rel_standing_envs: 0.02
    rel_heading_envs: 1.0
    ranges:
      lin_vel_x: !!python/tuple
      - -0.5
      - 0.5
      lin_vel_y: !!python/tuple
      - -0.25
      - 0.25
      ang_vel_z: !!python/tuple
      - -1.0
      - 1.0
      heading: !!python/tuple
      - -3.141592653589793
      - 3.141592653589793
    goal_vel_visualizer_cfg:
      prim_path: /Visuals/Command/velocity_goal
      markers:
        arrow:
          func: isaaclab.sim.spawners.from_files.from_files:spawn_from_usd
          visible: true
          semantic_tags: null
          copy_from_source: true
          mass_props: null
          deformable_props: null
          rigid_props: null
          collision_props: null
          activate_contact_sensors: false
          scale: !!python/tuple
          - 0.5
          - 0.5
          - 0.5
          articulation_props: null
          fixed_tendons_props: null
          joint_drive_props: null
          visual_material_path: material
          visual_material:
            func: isaaclab.sim.spawners.materials.visual_materials:spawn_preview_surface
            diffuse_color: !!python/tuple
            - 0.0
            - 1.0
            - 0.0
            emissive_color: !!python/tuple
            - 0.0
            - 0.0
            - 0.0
            roughness: 0.5
            metallic: 0.0
            opacity: 1.0
          usd_path: http://omniverse-content-production.s3-us-west-2.amazonaws.com/Assets/Isaac/4.5/Isaac/Props/UIElements/arrow_x.usd
          variants: null
    current_vel_visualizer_cfg:
      prim_path: /Visuals/Command/velocity_current
      markers:
        arrow:
          func: isaaclab.sim.spawners.from_files.from_files:spawn_from_usd
          visible: true
          semantic_tags: null
          copy_from_source: true
          mass_props: null
          deformable_props: null
          rigid_props: null
          collision_props: null
          activate_contact_sensors: false
          scale: !!python/tuple
          - 0.5
          - 0.5
          - 0.5
          articulation_props: null
          fixed_tendons_props: null
          joint_drive_props: null
          visual_material_path: material
          visual_material:
            func: isaaclab.sim.spawners.materials.visual_materials:spawn_preview_surface
            diffuse_color: !!python/tuple
            - 0.0
            - 0.0
            - 1.0
            emissive_color: !!python/tuple
            - 0.0
            - 0.0
            - 0.0
            roughness: 0.5
            metallic: 0.0
            opacity: 1.0
          usd_path: http://omniverse-content-production.s3-us-west-2.amazonaws.com/Assets/Isaac/4.5/Isaac/Props/UIElements/arrow_x.usd
          variants: null
curriculums: {}
