promaaa/firefighter-robot/(commit log)

2026-10-22 Add the final design F2: CAD scripts, print kit and renders
    Two R2 water tanks on the torso posts, the pan-tilt head, the rear pod and the battery holder. cad/final/kit holds the 21 printed pieces, the cut drawings and the 77-step assembly guide.
    [cam_mlx90640.stl, cam_usb32.stl, deck.stl, deck_f1.stl, frame_clip.stl, head_f1.stl, holder_6s_vega.stl, holder_6s_zeee.stl]
2026-10-22 Add the robot software: launcher, legs, pan-tilt, pump and aiming
    Runs on the Radxa ROCK 3C. robot/launch.py starts and watches all nodes in sim, bench or full mode. Tested in simulation with fake hardware.
2026-10-22 Add the simulations: robot models, missions, walking policy and water jet
    MuJoCo models of the F2 robot, the full firefighting mission, the evaluation of the walking policies, the drive risk study and the water jet model of the Kamoer KLP02 pump.
2026-10-22 Add the electrical drawings SOB-E rev B, the wiring list and the parts to order
    Overview, sheet 1 power distribution and sheet 2 control and communication, with the 24 V pump on the motor bus. harness.csv lists every wire and power_calc.py checks it.
    [harness.csv]
2026-10-22 Add the project plan, documentation index, licences and test workflow
    The plan follows the team schedule board. The README is now a short project summary with links.
2026-10-22 Build the robot models before the leg tests in the workflow
    Also keep the DWP-385 comparison curve that sim/water/water.py writes.
2026-11-06 Add the vision tests with the B0201 camera and the new detectors
    docs/plan/vision.md gives the test stages V1 to V11 with their commands and pass criteria.
    vision/screen_bench.py films fire images on a screen with the robot camera, and bench_compare.py
    compares the detectors on these frames. vision/range_test.py records real candles. calibrate.py
    gives the lens calibration (f = 476 px at 640 x 480). train.py adds camera-like images, the P2
    and YOLO26n networks and training with the bench frames (p2bench).
    The robot uses the lens calibration (aim/run.py), the camera USB id and the measured camera delay
    (robot/config.toml). The design F3 changes in the same files are not part of this commit.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
2026-11-06 Use the calibrated camera focal length in the mission simulation
    The simulations now use f = 476 px, the lens calibration of 5 Nov, instead of the old model value f = 283 px.
    The mission simulation no longer corrects the lens distortion on its rendered images. In its software-in-the-loop
    mode, aim/ gets the rendered camera through the new robot/config.toml [camera] calib key.
    New campaign and sprite check. The YOLO detector puts out 37 fires of 102 instead of 25 in a control run with
    f = 283 px, the same code and the same 50 missions.
2026-11-11 Bring up the ROCK 3C: NPU setup in install.sh and first board measurements
    install.sh step 11 enables the rk3568-npu-enable overlay and installs
    librknnrt 2.5.0: the Radxa image ships with the NPU disabled and runtime
    2.3.0. robot/README.md bring-up step 1 adds headless Wi-Fi setup and the
    5 V 3 A supply. vision/README.md and docs/plan/vision.md record the
    measured board speed (V6) and camera node test (V7), and the open issue
    of wrong p2bench boxes on the NPU. board_bench.py strips the NUL from the
    device-tree model name.
2026-11-11 Integrate the locomotion code. (Incomplete) Add test_menu.py for testing the actuators .
    [asmr2026_humanoid.urdf, asmr2026_humanoid.xml, base_visual.stl, imu_2_visual.stl, leg_left_ankle_pitch_visual.stl, leg_left_ankle_roll_visual.stl, leg_left_hip_pitch_visual.stl, leg_left_hip_roll_visual.stl]
